Caveatron/caveatron_old_rev-A_version/README.md

# rev-A_version
 Original Caveatron version based on Arduino Due
