Caveatron/caveatron_old_rev-A_version/caveatron-hardware-documentation/README.md

# Documentation for Assembling the Caveatron Hardware
