Caveatron/caveatron_old_rev-A_version/caveatron-hardware-documentation/Electronics/readme.txt

Caveatron Electronics Documentation

Caveatron Base Electronics.pdf - shows approximate layout of electronics modules in main body interior along with pin connection points.

Caveatron Board Connection.pdf - shows details of the module positions and wiring connections of each protoboard used in the main body.

Caveatron Wiring Diagram.pdf - Wiring diagram for the main body enclosure electronics

Caveatron Wiring Diagram Notes.pdf - Additional notes on the electronics

Caveatron 4m LIDAR Wiring Diagram.pdf - Wiring diagram for 4m (XV) LIDAR Module

Caveatron 25m LIDAR Wiring Diagram.pdf - Wiring diagram for 25m (SWEEP) LIDAR Module
