Caveatron/caveatron_old_rev-A_version/caveatron-hardware-documentation/Electronics/Cavatron Base Electronics - Rev A.pdf

## Caveatron Rev A Main Body Base Electronics Illustration

2017-09-23

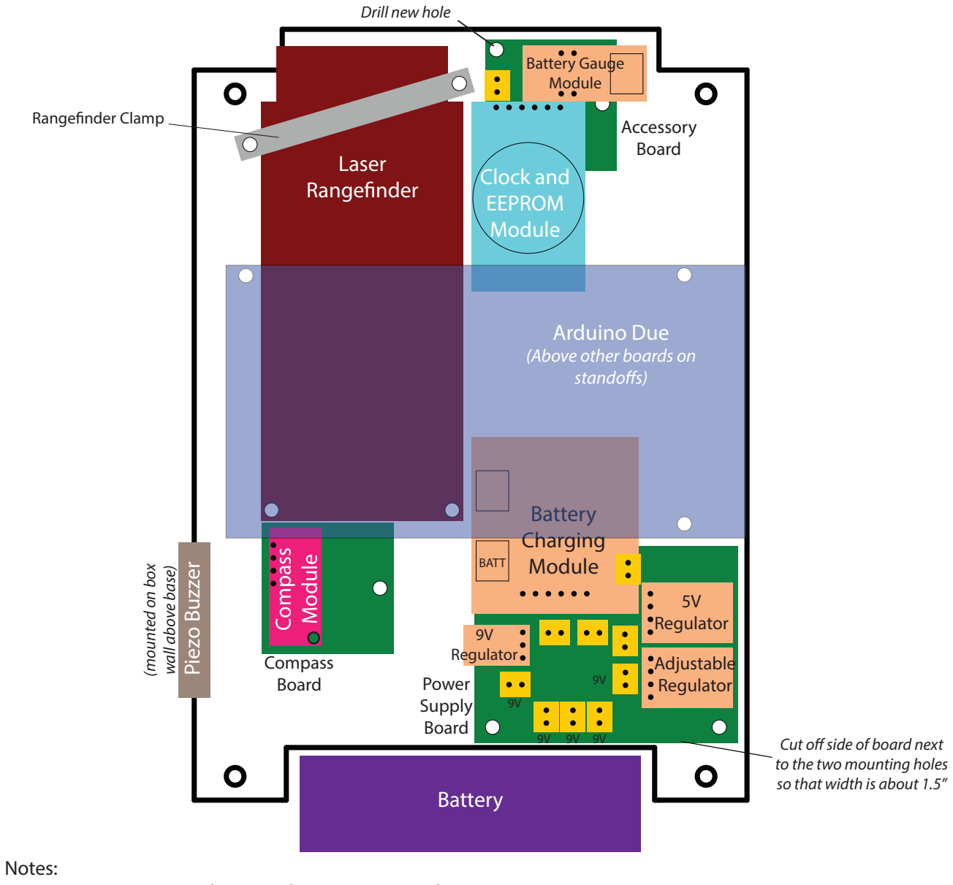
[picture p1: figure]
Battery; Battery Charging Module; Arduino Due (Above other boards on standos); Compass Module; Laser; Rangender; Clock and; EEPROM Module; Battery Gauge Module; 5V Regulator; Adjustable Regulator; 9V Regulator; Accessory Board; Compass; Board; Power; Supply Board; (mounted on box wall above base); Piezo Buzzer; BATT; Drill new hole; Cut o side of board next to the two mounting holes so that width is about 1.5”; Notes:; Rangender Clamp

- Wiring connectors are shown in the seperate Board Connections document.
- Yellow rectangles are JST-PH 2-pin connectors.
- The Rangnder Clamps is a custom cut plastic piece to secure the front of the rangender. A pair of standos screwed down to the base hold it in place.
- It is important to align the edge of the Compass Board with the rear edge of the Laser Rangender so the Compass board cannot rotate and is parallel to it.
- Be sure the battery holder on the Accessory Board and the BATT connector on the Battery Charging Module clear the Arduino Board.

The green boards are protoboards onto which the connectors and modules are soldered with pins. The following protoboards are used:
- Sparkfun PRT-08808 1” Square Protoboard (2x)
- Sparkfun PRT-08811 2” Square Protoboard (1x) These boards are modied as indicated in the drawing.
