Caveatron/caveatron_old_rev-A_version/caveatron-hardware-documentation/Enclosure/Caveatron Main Body Base Plate Hole Pattern.pdf

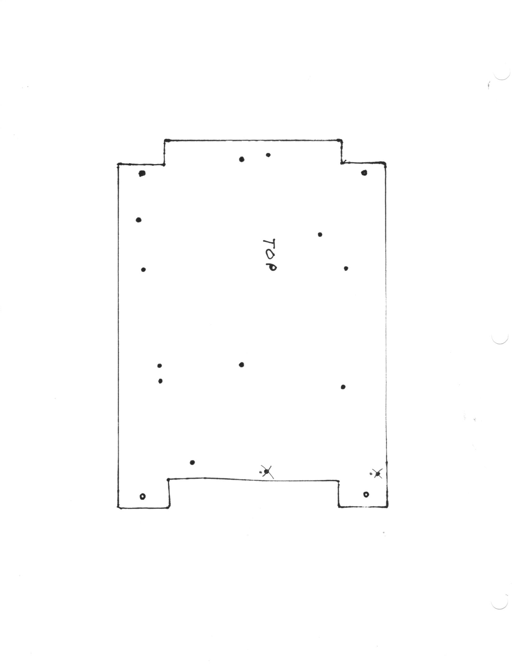
[picture p2: page 1]
