Caveatron/caveatron_old_rev-A_version/caveatron_libraries/SdFat/extras/AnalogBinLoggerExtras/ADC_ENOB.PNG

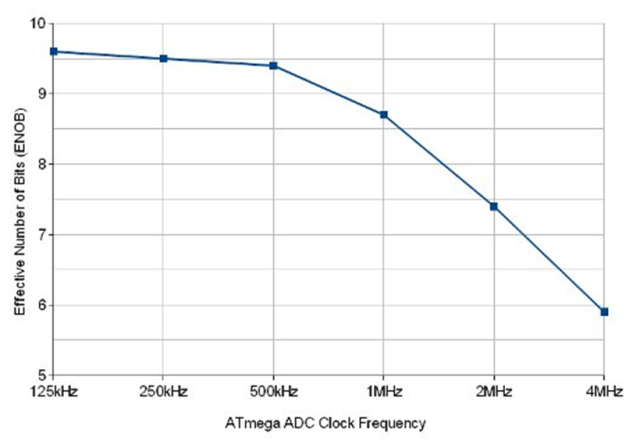
caveatron_libraries/SdFat/extras/AnalogBinLoggerExtras/ADC_ENOB.PNG
