Caveatron/caveatron_old_rev-A_version/caveatron_libraries/SdFat/extras/AnalogBinLoggerExtras/DATA.png

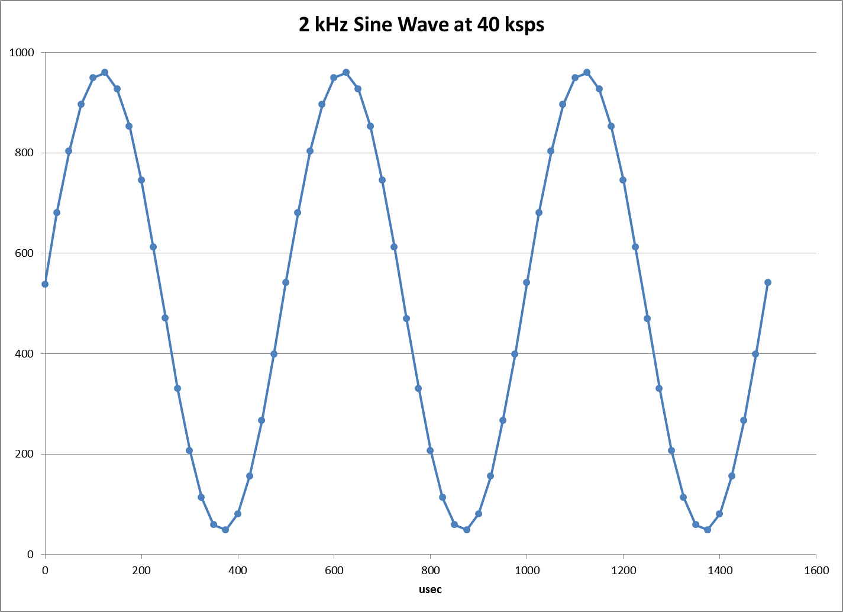
caveatron_libraries/SdFat/extras/AnalogBinLoggerExtras/DATA.png
