Caveatron/caveatron_old_rev-A_version/caveatron_libraries/SdFat/extras/AnalogBinLoggerExtras/FFT.png

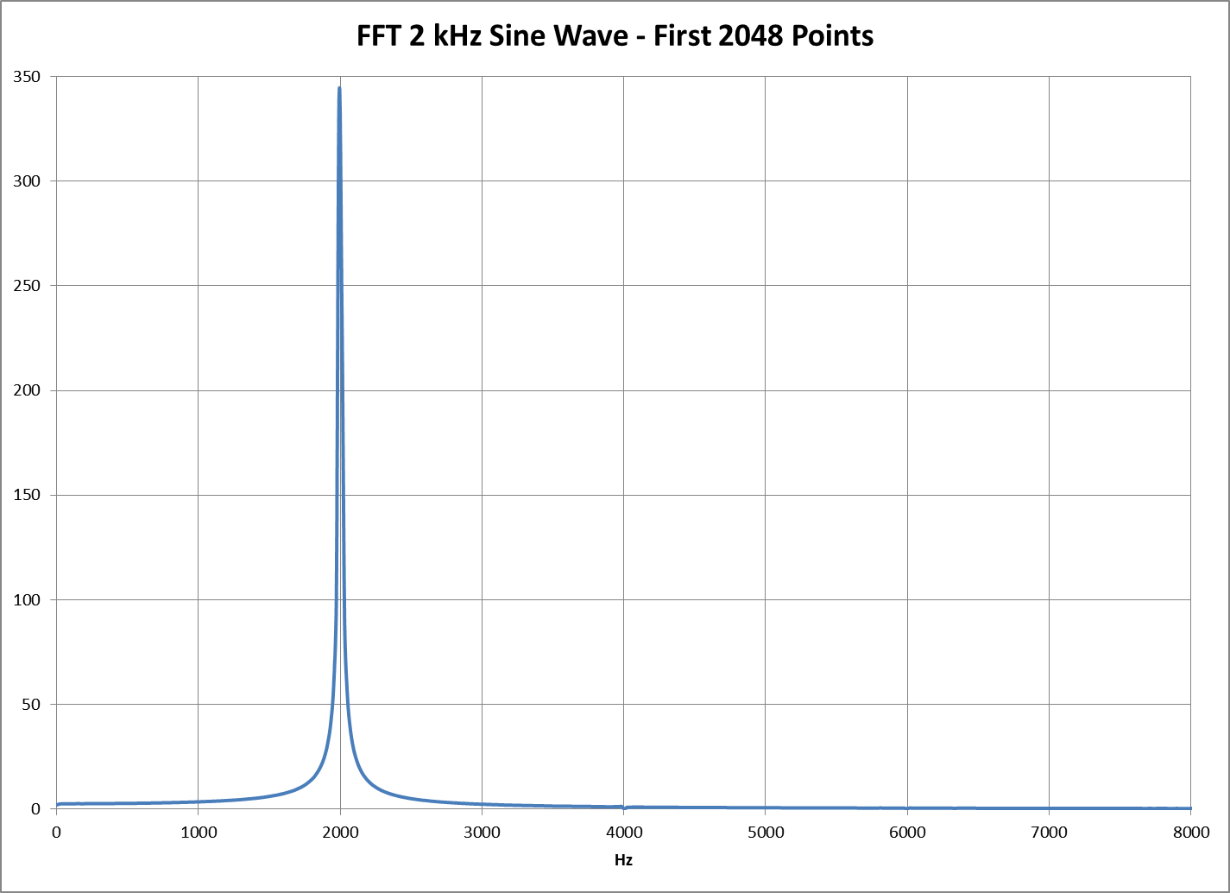
caveatron_libraries/SdFat/extras/AnalogBinLoggerExtras/FFT.png
