Caveatron/caveatron_old_rev-A_version/caveatron_libraries/SdFat/extras/html/_arduino_files_8h__dep__incl.png

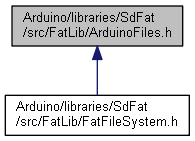
caveatron_libraries/SdFat/extras/html/_arduino_files_8h__dep__incl.png
