Caveatron/caveatron_old_rev-A_version/caveatron_libraries/SdFat/extras/html/_sd_fat_config_8h__incl.png

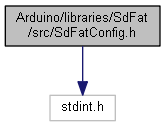
caveatron_libraries/SdFat/extras/html/_sd_fat_config_8h__incl.png
