Caveatron/caveatron_old_rev-A_version/caveatron_libraries/SdFat/extras/html/class_arduino_in_stream__coll__graph.png

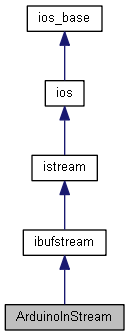
caveatron_libraries/SdFat/extras/html/class_arduino_in_stream__coll__graph.png
