Caveatron/caveatron_old_rev-A_version/caveatron_libraries/SdFat/extras/html/class_sd_fat__coll__graph.png

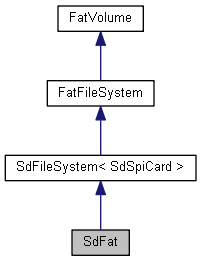
caveatron_libraries/SdFat/extras/html/class_sd_fat__coll__graph.png
