Caveatron/caveatron_old_rev-A_version/caveatron_libraries/SdFat/extras/html/class_sd_fat_e_x__coll__graph.png

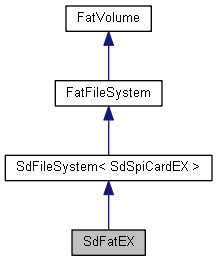
caveatron_libraries/SdFat/extras/html/class_sd_fat_e_x__coll__graph.png
