Caveatron/caveatron_old_rev-A_version/caveatron_libraries/SdFat/extras/html/classfstream__coll__graph.png

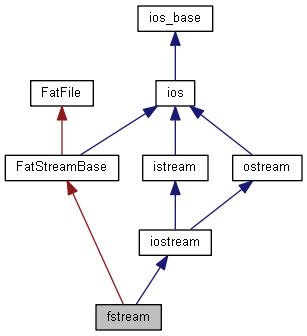
caveatron_libraries/SdFat/extras/html/classfstream__coll__graph.png
