Caveatron/caveatron_old_rev-A_version/caveatron_libraries/SdFat/extras/html/classistream__inherit__graph.png

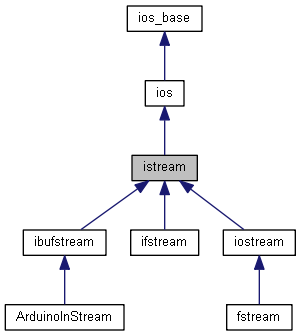
caveatron_libraries/SdFat/extras/html/classistream__inherit__graph.png
