Caveatron/caveatron_old_rev-A_version/caveatron_libraries/SdFat/extras/html/dir_7e472674a7b7d2590a789f197241f95f_dep.png

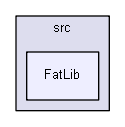
caveatron_libraries/SdFat/extras/html/dir_7e472674a7b7d2590a789f197241f95f_dep.png
