Caveatron/caveatron_old_rev-A_version/caveatron_libraries/SdFat/extras/html/dir_481cc946b8a81b8d9363a4aad6201160_dep.png

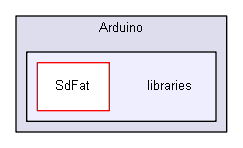
caveatron_libraries/SdFat/extras/html/dir_481cc946b8a81b8d9363a4aad6201160_dep.png
