Caveatron/caveatron_old_rev-A_version/caveatron_libraries/SdFat/extras/html/dir_1281b15c327061056ab3b326e90c50cf_dep.png

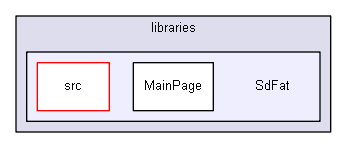
caveatron_libraries/SdFat/extras/html/dir_1281b15c327061056ab3b326e90c50cf_dep.png
