Caveatron/caveatron_old_rev-A_version/caveatron_libraries/SdFat/extras/html/dir_c18d6c86f7b0afecac5c3a8a9885031e_dep.png

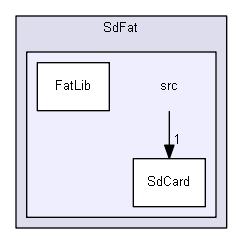
caveatron_libraries/SdFat/extras/html/dir_c18d6c86f7b0afecac5c3a8a9885031e_dep.png
