Caveatron/caveatron_old_rev-A_version/caveatron_libraries/SdFat/extras/html/fstream_8h__incl.png

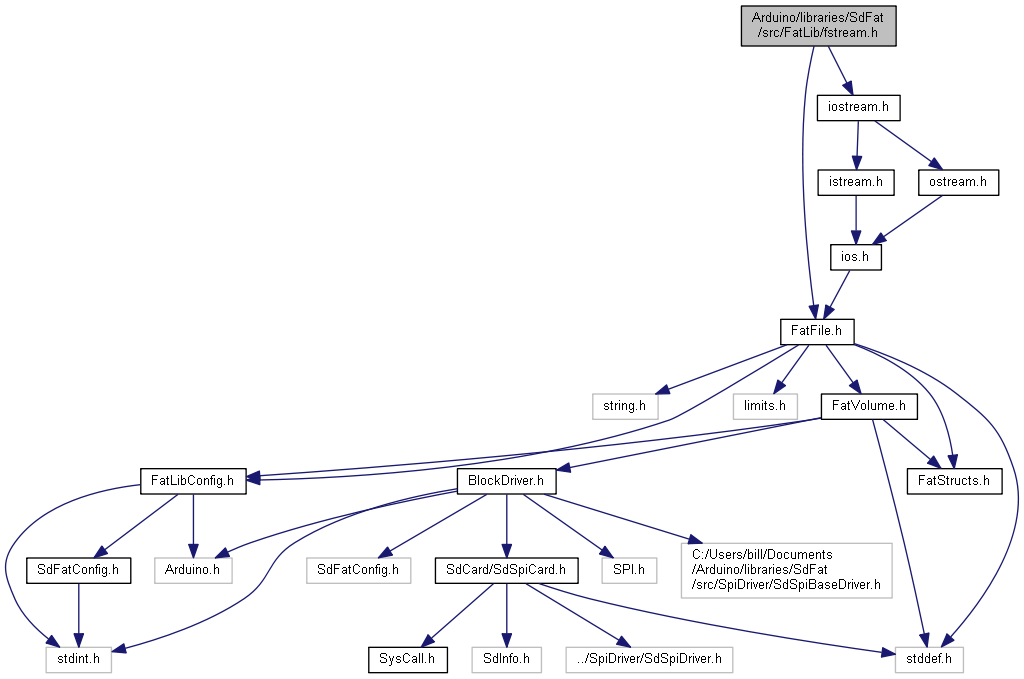
caveatron_libraries/SdFat/extras/html/fstream_8h__incl.png
