Caveatron/caveatron_old_rev-A_version/caveatron_libraries/SdFat/extras/html/graph_legend.png

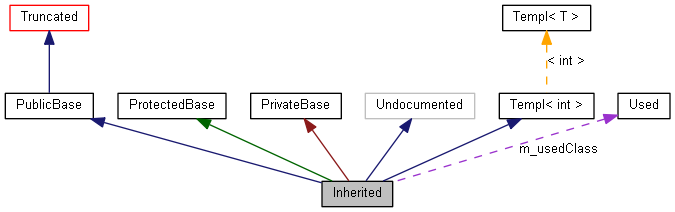
caveatron_libraries/SdFat/extras/html/graph_legend.png
