Caveatron/caveatron_old_rev-A_version/caveatron_libraries/SdFat/extras/html/inherit_graph_10.png

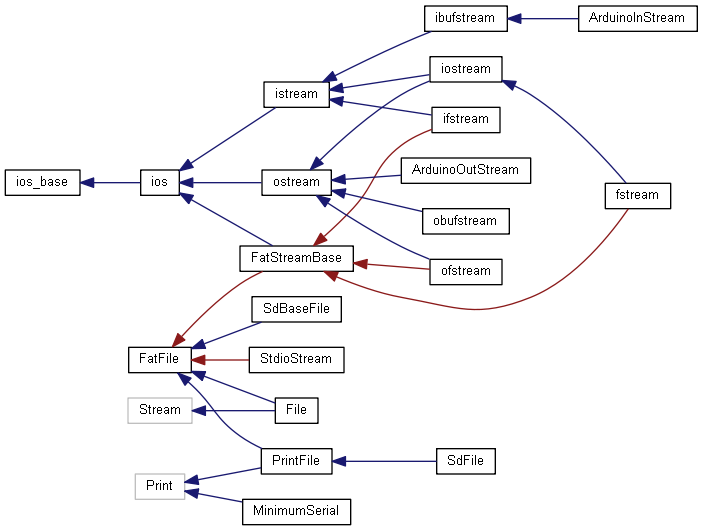
caveatron_libraries/SdFat/extras/html/inherit_graph_10.png
