Caveatron/caveatron_old_rev-A_version/caveatron_libraries/SdFat/extras/html/istream_8h__incl.png

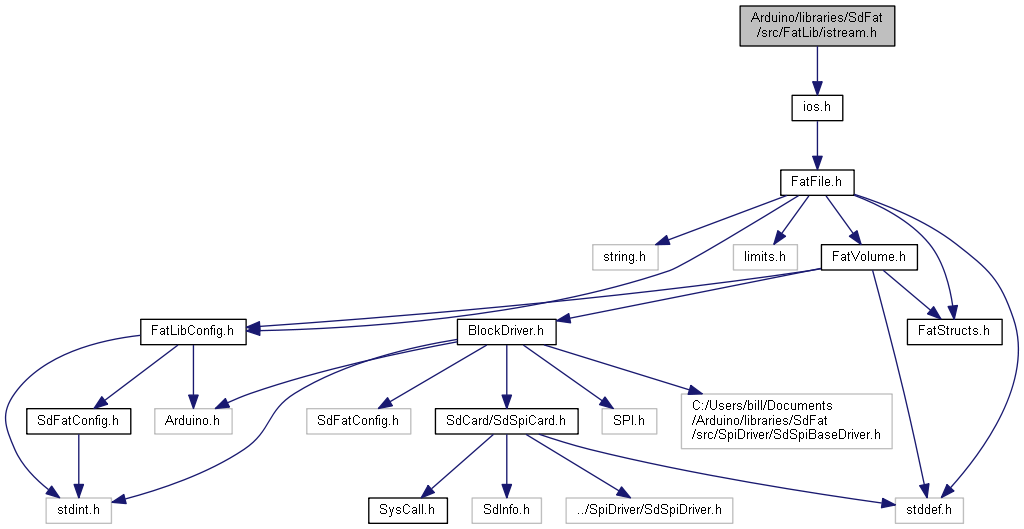
caveatron_libraries/SdFat/extras/html/istream_8h__incl.png
