Caveatron/caveatron_old_rev-A_version/caveatron_libraries/SdFat/extras/html/structmaster_boot_record__coll__graph.png

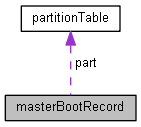
caveatron_libraries/SdFat/extras/html/structmaster_boot_record__coll__graph.png
