Caveatron/caveatron_old_rev-A_version/caveatron_libraries/SdFat/extras/html/unioncache__t__coll__graph.png

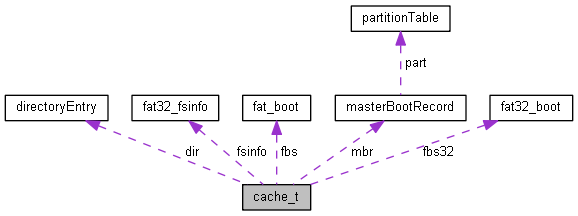
caveatron_libraries/SdFat/extras/html/unioncache__t__coll__graph.png
