Caveatron/caveatron_old_rev-A_version/caveatron-hardware-documentation/Caveatron Bill of Materials - LIDAR 12m version - 2019-11-05.pdf

## Caveatron Bill of Materials – 12m RP LIDAR Module

### Date: 2019-11-05

The LIDAR module mounts onto the top front of the main enclosure and is easily detachable. The module is designed to use a custom 3D printed enclosure consisting of a base part, a lid bottom part, and lid top part. An STL file of these parts is provided. PETG is the recommended printing material.

Item | Qty | Manufacturer | Mfr. P/N | Description | Suggested Vendor Link | Photo
LIDAR | 1 | Slamtec | RPLIDAR A1M8 | LIDAR 360 Degree Laser Range Scanner | RobotShop (https://www.robotshop.com/en/rplidar-a1m8-360-degree-laser-scanner-development-kit.html)

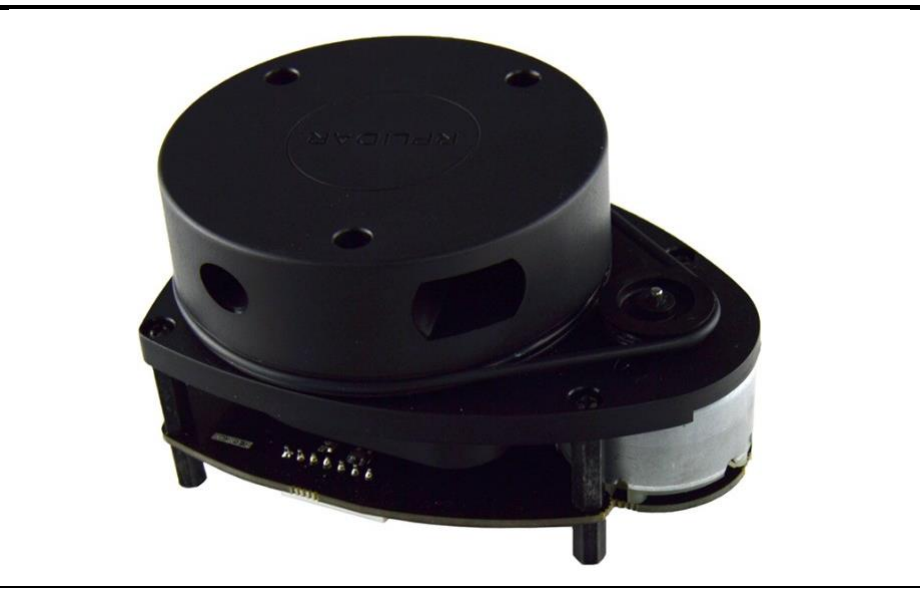
[picture p89: figure]

Notes: Scanning LIDAR sensor. Other models that may also work but have not been tested include RPLIDAR A2M6, A2M8, and A3M1.

Voltage
Regulator –
Adjustable
(OPTIONAL)
1 | Pololu | 2118 | Pololu Adjustable Step- Up/Step-Down Voltage Regulator S7V8A

Pololu (https://www.pololu.com/product/2118)

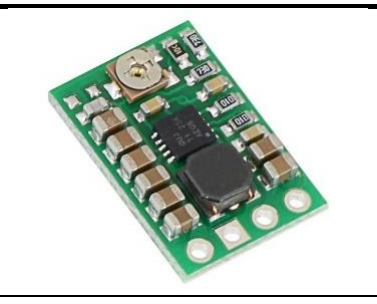
[picture p90: figure]

Notes: Power supply for Laser Rangefinder. Output is set so that the LIDAR is rotating at about 5 Hz (300 RPM). The voltage is typically set to about 3.68 V. It is not necessary to use this component since the LIDAR motor can be directly operated off of 5V, which gives a rotation speed of 7.5 Hz (450 RPM) but reduces the number of points per rotation from 400 to 267.

Item | Qty | Manufacture r | Mfr. P/N | Description | Suggested Vendor Link | Photo
LIDAR Rail Mounts | 1 | Weaver | 49819 | 0.22 Caliber 1-inch Tip-Off Rings | Amazon (https://www.amazon.com/49819-Weaver-Pro-View-Rings-1/dp/B0002IOGF0/)

Notes: Parts for making the rail mounts. The top ring portion is cut off making a flat top and two threaded holes are machined into each ring base for attachment to bottom of LIDAR module enclosure.

LIDAR
Interface Plug

1 Conxall/ Switchcraft

16982-
6PG-522

Micro-Con-X 6 Position
Circular Connector Plug,
Male Pins Solder Cup Gold

Digikey (https://www.digikey.com/products/en?keywords=16982-6PG-522)

Notes: Jack for LIDAR interface cable. Available from multiple vendors.

Cable Gland | 1 | Many sources
PG7 | Waterproof Cable Gland
Wire Feedthrough

Amazon (https://www.amazon.com/Lokman-Plastic-Waterproof-Adjustable-Connectors/dp/B06Y5HGYK2/) or
many other
sources

Notes: Feeds LIDAR interface cable out of LIDAR enclosure. Numerous small variations of style and color are available, so long as it is PG7 size.

Item | Qty | Manufacturer | Mfr. P/N | Description | Suggested Vendor Link | Photo
Window Material | 1 | Small Parts | 5302441212 | Acrylic Sheet, Transparent Clear, Standard Tolerance, ASTM D788, 0.118" Thickness | Amazon (https://www.amazon.com/Acrylic-Transparent-Standard-Tolerance-Thickness/dp/B00CPRAYWK/)

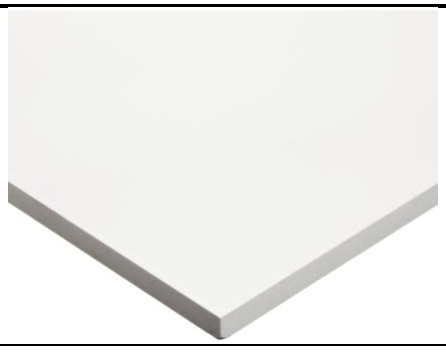
[picture p91: figure]

Notes: Transparent acrylic sheet for LIDAR windows on 3D Printed LIDAR Module. Requires cutting to size. Acrylic seems to be the most transparent with the least distortion and defects of the various clear plastics tested, which is important for not interfering with the LIDAR and rangefinder readings. This is a thicker window than is used on the Main body since it is used in the 3D printed enclosure as a structural piece as well. If a different enclosure design is used, the thinner material could be used instead.

Threaded
Inserts for
LIDAR
Standoffs
1 | Initeq | INM2504 | M2.5-0.4 M2.5 Threaded Heat Set Inserts for 3D Printing (Long)

Amazon (https://www.amazon.com/gp/product/B077CH3GCM/)

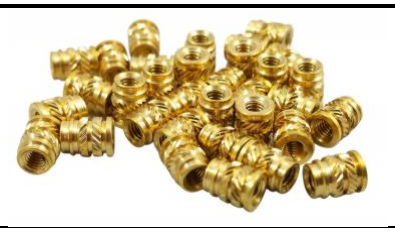
[picture p92: figure]

Notes: Heat set threaded inserts used in 3D printed LIDAR enclosure for LIDAR standoffs. The standoffs that screw into these are included with the RPLIDAR.

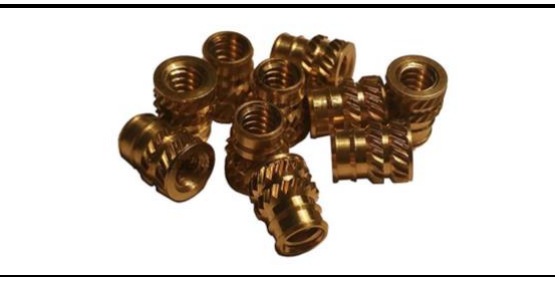
[picture p93: figure]

Threaded
Inserts for
Enclosure Lid
1 | Small Parts | STPVC-0093-F | Qty 20 M4-0.7 Threaded Heat Set Inserts for 3D Printing (Long)

Amazon (https://www.amazon.com/gp/product/B07477XRN4/)

Notes: Heat set threaded inserts used in 3D printed LIDAR enclosure for lid screws.

Item | Qty | Manufacturer | Mfr. P/N | Description | Suggested | Photo

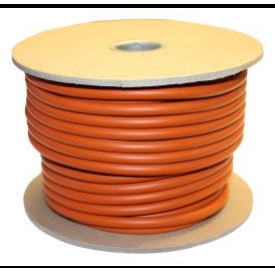
[picture p94: figure]

| | | | | Vendor Link
O-Ring Gasket Material | 1 | Small Parts | S70.093 | .093'' (3/32" Actual) Silicone O-Ring Cord Stock, 70A Durometer, 0.093" Thickness | Amazon (https://www.amazon.com/gp/product/B00QVB0TW6)

Notes: Seal gasket for LIDAR lid.

JST Connector
for LIDAR
Motor
1 | Various | N/A | JST 1.25mm pitch, 3 pin, male connector

Amazon (https://www.amazon.com/gp/product/B073WPQLVX/)

Notes: Connector for LIDAR Motor.

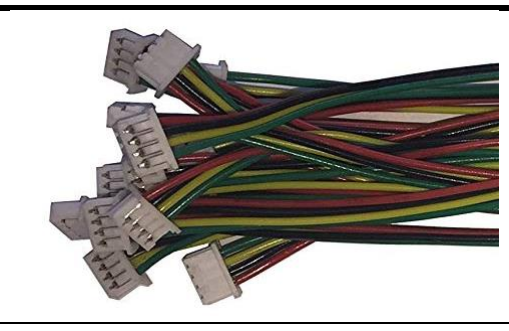
[picture p95: figure]

JST Connector
for LIDAR
Sensor
1 | Various | INM2504 | JST 1.25mm pitch, 4 pin, male connector

Amazon (https://www.amazon.com/1-25MM-Female-Single-Connector-Wires/dp/B07HLF2MFJ/)

Notes: Connector for LIDAR Sensor

Other Required Items:
M4 x 12 Screws for Lid
4 conductor cable to connect LIDAR module to main enclosure through Cable Gland to LIDAR Interface Plug
Slightly flexible sealing epoxy to attach LIDAR windows (marine grade epoxy, silicone epoxy or similar). Rigid epoxies may warp the windows. Tape and/or cable ties to manage wiring and voltage regulator.
Notes: For assembly and electrical interconnections
