Caveatron/caveatron_old_rev-A_version/caveatron-hardware-documentation/Caveatron Bill of Materials - LIDAR 25m version - 2019-02-12.pdf

## Caveatron Bill of Materials – 25m LIDAR Unit

### Date: 2019-02-12

Item | Qty | Manufacturer | Mfr. P/N | Description | Suggested Vendor Link

Photo

LIDAR | 1 | Scanse | N/A | Sweep | N/A No longer manufactured but units can still be found on Ebay from time to time.

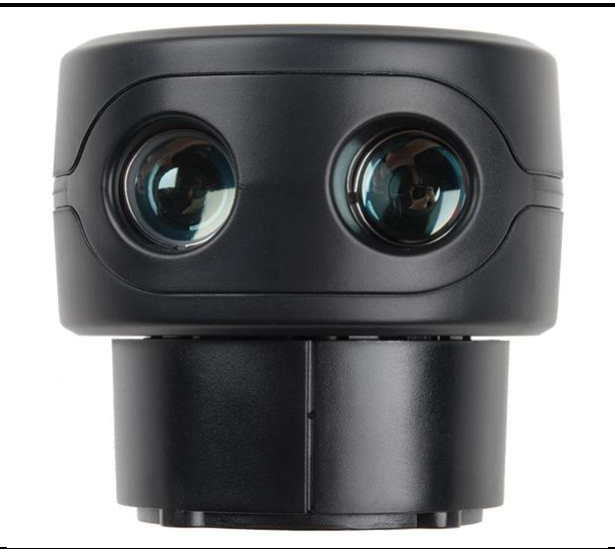
[picture p96: figure]

Notes: Scanning LIDAR sensor. Operates on 5V so separate voltage regulator not required. No longer available.

Item | Qty | Manufacturer | Mfr. P/N | Description | Suggested Vendor Link

Photo

LIDAR Module Enclosure | 1 | Bud Industries | PN-1323- DG | ABS NEMA 4x Enclosure, Dark Gray | Amazon (https://www.amazon.com/BUD-Industries-PN-1323-DG-High-Impact-Indoor/dp/B005T7B0X0/)

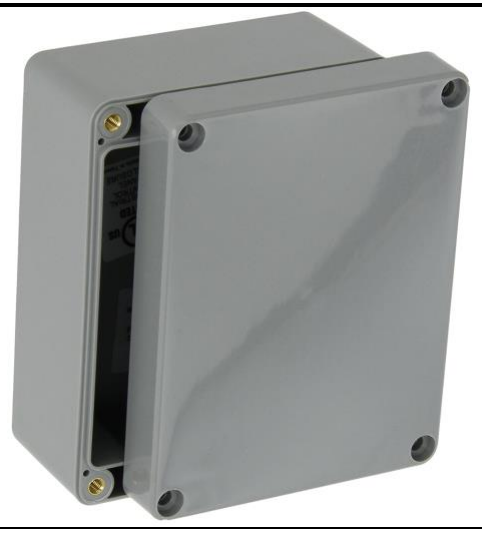
[picture p97: figure]

Notes: Enclosure box for LIDAR module. Requires machining of base to add holes for cable gland and rail mounts. Lid is replaced with a custom 3D printed lid, reusing the gasket from this lid. Available from many vendors. A custom 3D printed baseplate has also been designed to mount the Sweep inside this enclosure.

Cable Gland | 1 | Many sources | PG7 | Waterproof Cable Gland Wire Feedthrough

Amazon or
many other
sources

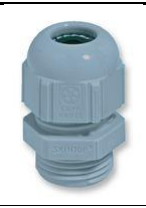
[picture p98: figure]

Notes: Feeds LIDAR interface cable out of LIDAR enclosure. Numerous small variations of style and color are available, so long as it is PG7 size.

Item | Qty | Manufacturer | Mfr. P/N | Description | Suggested Vendor Link | Photo
LIDAR Rail Mounts | 1 | Weaver | 49819 | 0.22 Caliber 1-inch Tip-Off Rings | Amazon (https://www.amazon.com/49819-Weaver-Pro-View-Rings-1/dp/B0002IOGF0/)

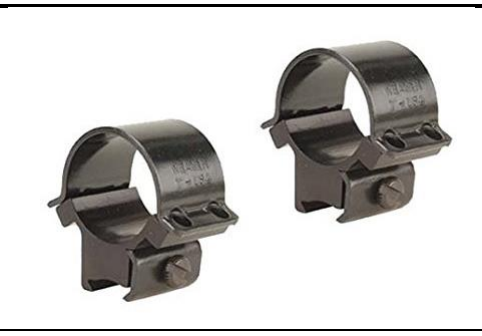
[picture p99: figure]

Notes: Parts for making the rail mounts. The top ring portion is cut off making a flat top and two threaded holes are machined into each ring base for attachment to bottom of LIDAR module enclosure.

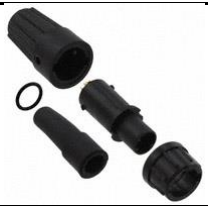
[picture p100: figure]

LIDAR
Interface
Jack

1 Conxall/ Switchcraft

16982-
6PG-522

Micro-Con-X 6 Position
Circular Connector Plug,
Male Pins Solder Cup Gold

Digikey (https://www.digikey.com/products/en?keywords=16982-6PG-522)

Notes: Jack for LIDAR interface cable. Available from multiple vendors.

Item | Qty | Manufacturer | Mfr. P/N | Description | Suggested Vendor Link | Photo

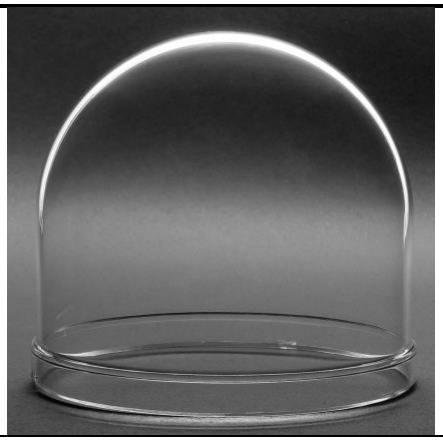
[picture p101: figure]

Window Dome | 1 | JMX | JMX-033 | 3.3 inch Acrylic Clear Camera Dome Cover | Ebay (https://www.ebay.com/itm/3-3-Inch-WEBCAM-Acrylic-PC-Replacement-Clear-Camera-Dome-Cover-/301720384656)

Notes: Transparent acrylic window for LIDAR Module. Glues onto custom 3D printed enclosure lid.

Assorted Fastener Hardware: Screws, Washers, and Nuts
Notes: For assembly. Several sizes of standard hardware required. To be detailed in assembly instructions.

Assorted Electrical Hardware: Wire and JST Connectors.

Notes: For electrical interconnections between boards. To be detailed in assembly instructions.
