Caveatron/caveatron_old_rev-A_version/caveatron-hardware-documentation/Caveatron Bill of Materials - LIDAR 4m version - 2018-03-06.pdf

## Caveatron Bill of Materials – 4m LIDAR Unit

### Date: 2018-03-06

Item | Qty | Manufacturer | Mfr. P/N | Description | Suggested Vendor Link | Photo
LIDAR | 1 | Neato | from XV-11 Vacuum model | LIDAR Laser Distance Sensor | Ebay. - seller availability changes frequently. Occasionally on Amazon

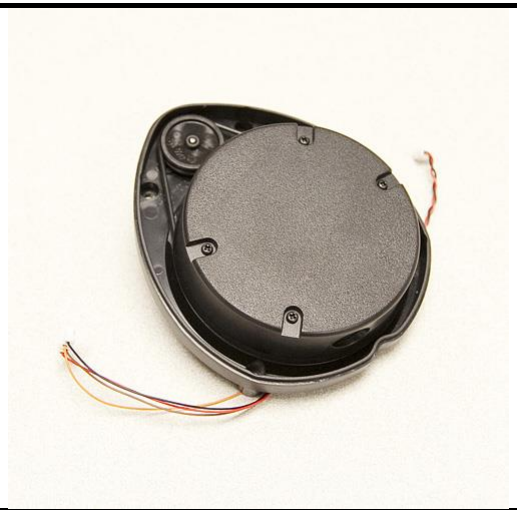
[picture p102: figure]

Notes: Scanning LIDAR sensor. Models listed as XV-11, XV-12, XV-14, XV-15, or XV-21 are all identical and will work the same.

Voltage
Regulator –
Adjustable
1 | Pololu | 2118 | Pololu Adjustable Step- Up/Step-Down Voltage Regulator S7V8A

Pololu (https://www.pololu.com/product/2118)

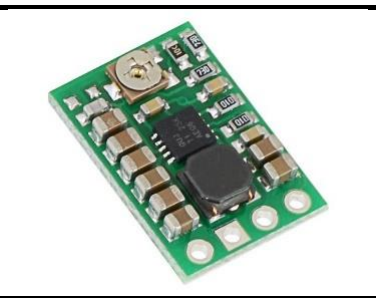
[picture p103: figure]

Notes: Power supply for Laser Rangefinder. Output is set so that the LIDAR is rotating at about 285 RPM (must be between 250 and 300 RPM). The voltage needed varies from LIDAR unit to LIDAR unit though is typically about 2.8 - 3.0 V.

Item | Qty | Manufacturer | Mfr. P/N | Description | Suggested Vendor Link

Photo

LIDAR Module Enclosure | 1 | Bud Industries | PN-1336- DG | ABS NEMA 4x Enclosure, Dark Gray | Amazon (https://www.amazon.com/BUD-Industries-PN-1336-DG-High-Impact-Indoor/dp/B005T7AND8)

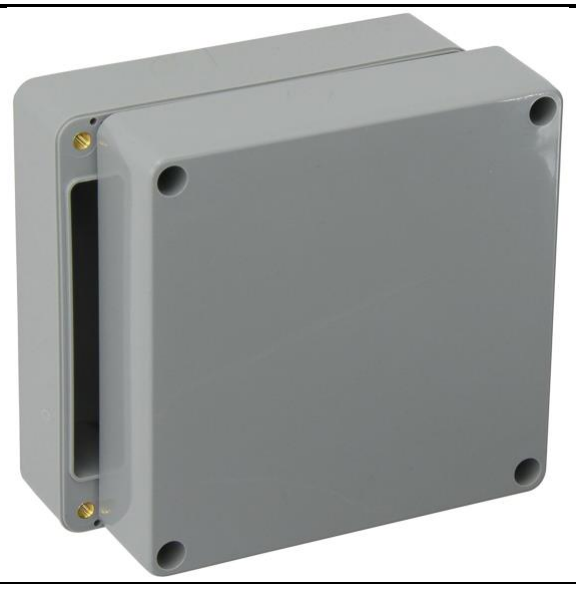
[picture p104: figure]

Notes: Enclosure box for LIDAR module. Requires machining of base to add holes for cable gland and rail mounts. Lid is replaced with a custom 3D printed lid, reusing the gasket from this lid. If no 3D printer available, lid can be used as cover with ½” wide slits cut along the length of all 4 sides, though this obstructs more of the LIDAR field of view in the corners than the custom lid. Available from many vendors.

Cable Gland | 1 | Many sources | PG7 | Waterproof Cable Gland Wire Feedthrough

Amazon or
many other
sources

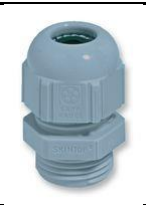
[picture p105: figure]

Notes: Feeds LIDAR interface cable out of LIDAR enclosure. Numerous small variations of style and color are available, so long as it is PG7 size.

Item | Qty | Manufacturer | Mfr. P/N | Description | Suggested Vendor Link | Photo
LIDAR Rail Mounts | 1 | Weaver | 49819 | 0.22 Caliber 1-inch Tip-Off Rings | Amazon (https://www.amazon.com/49819-Weaver-Pro-View-Rings-1/dp/B0002IOGF0)

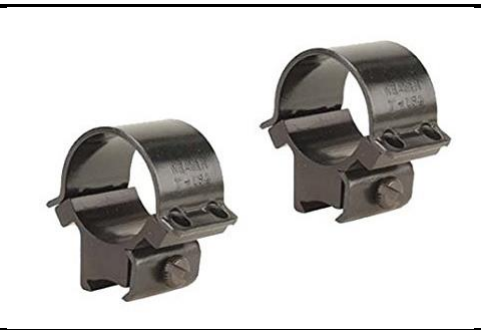
[picture p106: figure]

Notes: Parts for making the rail mounts. The top ring portion is cut off making a flat top and two threaded holes are machined into each ring base for attachment to bottom of LIDAR module enclosure.

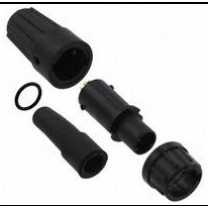
[picture p107: figure]

LIDAR
Interface
Jack
1 | Conxall/ Switchcraft

16982-
6PG-522

Micro-Con-X 6 Position
Circular Connector Plug,
Male Pins Solder Cup Gold

Digikey (https://www.digikey.com/products/en?keywords=16982-6PG-522)

Notes: Jack for LIDAR interface cable. Available from multiple vendors.

Item | Qty | Manufacturer | Mfr. P/N | Description | Suggested Vendor Link | Photo
Window Material | 1 | Small Parts | 50649812 12 | Acrylic Sheet, Transparent Clear, 0.06" Thickness, 12" Width, 12" Length | Amazon (https://www.amazon.com/Acrylic-Transparent-Standard-Tolerance-Thickness/dp/B00CPRAYWK)

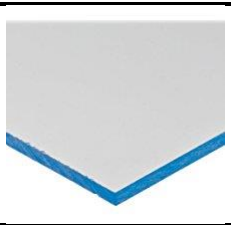
[picture p108: figure]

Notes: Transparent acrylic sheet for Rangefinder window on Main Body and LIDAR windows on LIDAR Module. Requires cutting to size. Acrylic seems to be the most transparent with the least distortion and defects of the various clear plastics tested ,which is important for not interfering with the LIDAR and rangefinder readings.

Plastic Base
Material
1 | Small Parts | STPVC- 0093-F

PVC Sheet, Opaque Gray,
0.093" Thickness, 12"
Width, 24" Length

Amazon (https://www.amazon.com/Polyvinyl-Chloride-Standard-Tolerance-Thickness/dp/B00CPRFA6K)

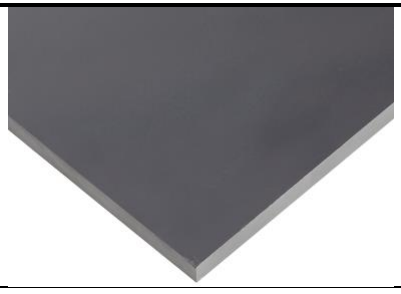
[picture p109: figure]

Notes: Plastic sheet for mounting internal components in Main Body Enclosure and LIDAR Enclosure. Requires cutting to size and drilling mounting holes.

Assorted Fastener Hardware: Screws, Washers, and Nuts
Notes: For assembly. Several sizes of standard hardware required. To be detailed in assembly instructions.

Assorted Electrical Hardware: Wire and JST Connectors.

Notes: For electrical interconnections between boards. To be detailed in assembly instructions.
