Caveatron/caveatron_old_rev-A_version/caveatron-hardware-documentation/Enclosure/Caveatron 12m LIDAR Enclosure Lid (Bottom).stl

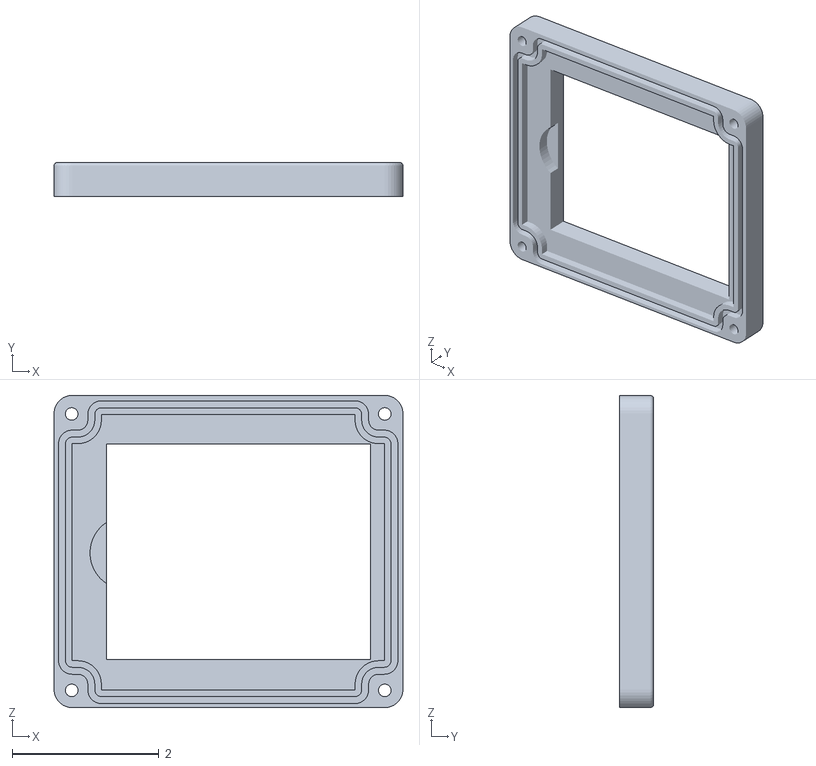
[picture p110: CAD file, 2020-01-26]
caveatron-hardware-documentation/Enclosure/Caveatron 12m LIDAR Enclosure Lid (Bottom).stl
4.76 x 0.47 x 4.26
