Caveatron/caveatron_old_rev-A_version/caveatron-hardware-documentation/Enclosure/Caveatron 25m LIDAR base - Rev A.stl

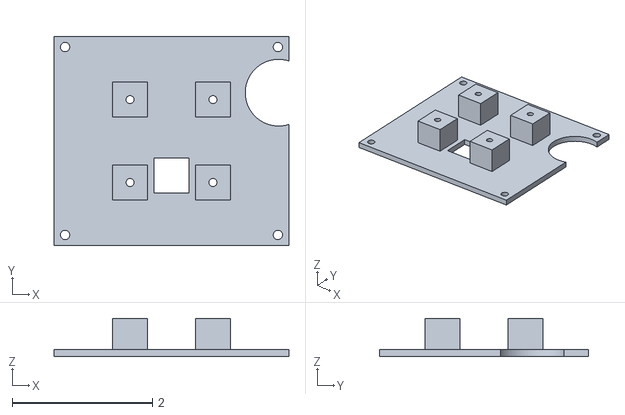
[picture p111: CAD file, 2020-01-26]
caveatron-hardware-documentation/Enclosure/Caveatron 25m LIDAR base - Rev A.stl
3.35 x 2.98 x 0.546
