Caveatron/caveatron_old_rev-A_version/caveatron-hardware-documentation/Enclosure/Caveatron 12m LIDAR Enclosure Lid (Top).stl

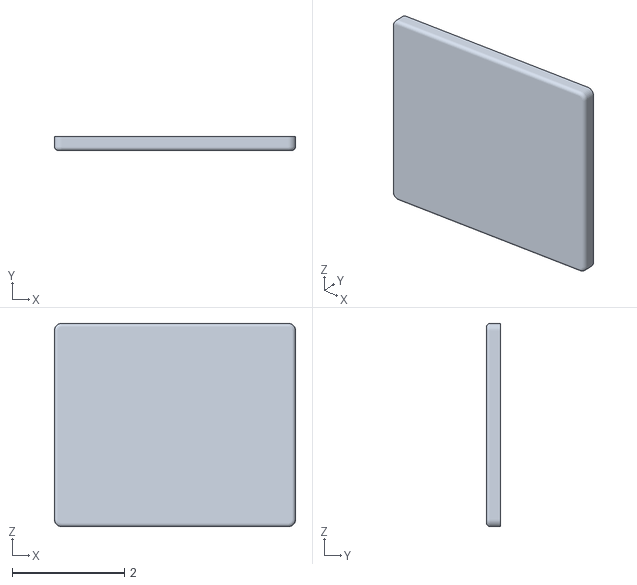
[picture p112: CAD file, 2020-01-26]
caveatron-hardware-documentation/Enclosure/Caveatron 12m LIDAR Enclosure Lid (Top).stl
4.28 x 0.25 x 3.62
