Caveatron/caveatron_old_rev-A_version/caveatron-hardware-documentation/Enclosure/Caveatron 12m LIDAR Enclosure Base.stl

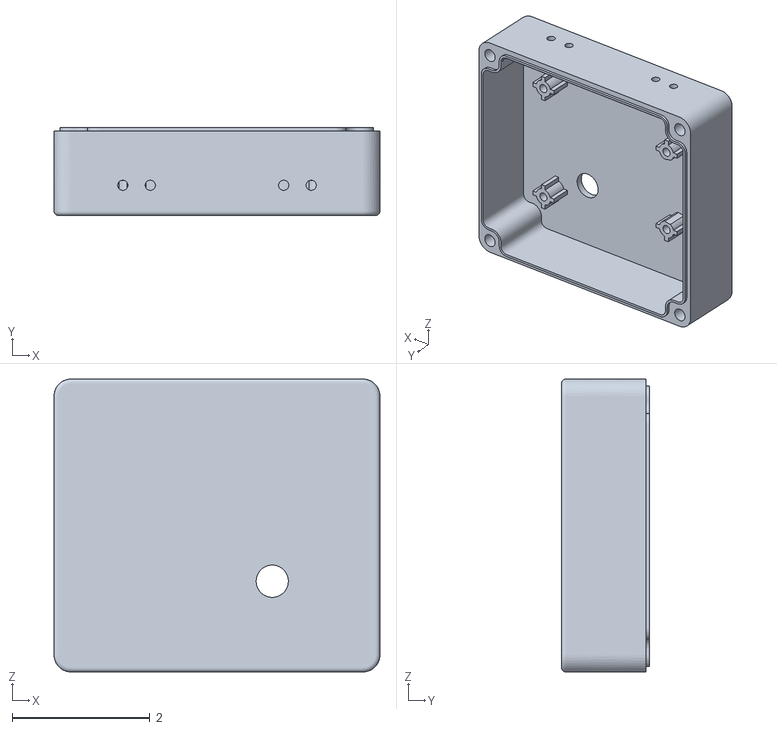
[picture p113: CAD file, 2020-01-26]
caveatron-hardware-documentation/Enclosure/Caveatron 12m LIDAR Enclosure Base.stl
4.74 x 1.28 x 4.26
