Caveatron/caveatron_old_rev-A_version/caveatron-hardware-documentation/Enclosure/Caveatron 4m LIDAR Enclosure Lid - Rev A.STL

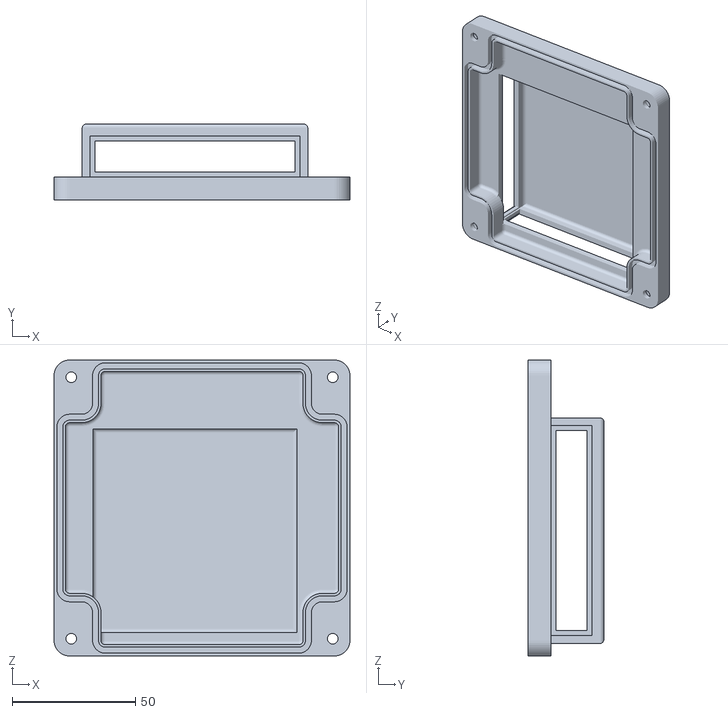
[picture p114: CAD file, 2020-01-26]
caveatron-hardware-documentation/Enclosure/Caveatron 4m LIDAR Enclosure Lid - Rev A.STL
120.0 x 30.7 x 120.0
