Caveatron/caveatron_old_rev-A_version/caveatron-hardware-documentation/Enclosure/Caveatron 25m LIDAR Module Lid - Rev A.stl

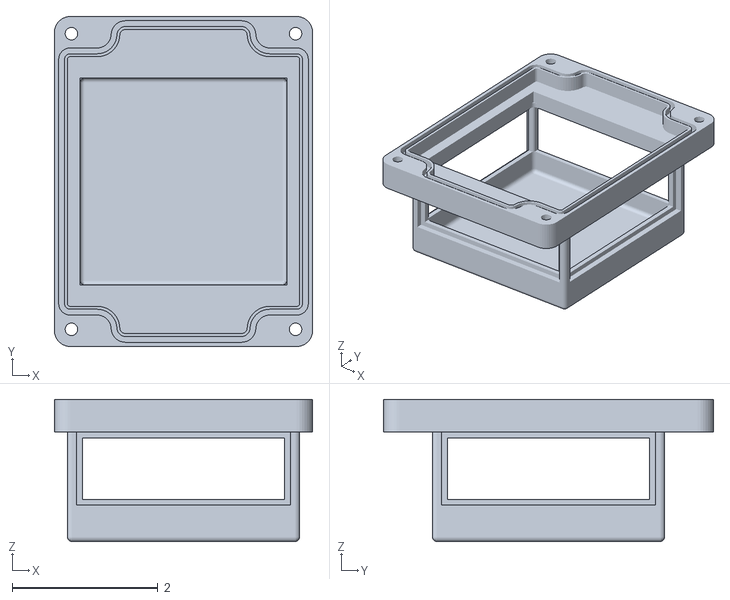
[picture p115: CAD file, 2020-01-26]
caveatron-hardware-documentation/Enclosure/Caveatron 25m LIDAR Module Lid - Rev A.stl
3.54 x 4.53 x 1.95
