Caveatron/caveatron_old_rev-A_version/caveatron-hardware-documentation/Electronics/Caveatron 12m LIDAR Wiring Diagram - Rev A.pdf

# Caveatron Wiring Diagram 12m LIDAR Module (RP) - Rev. A

v. 2019-02-12

*NOTES

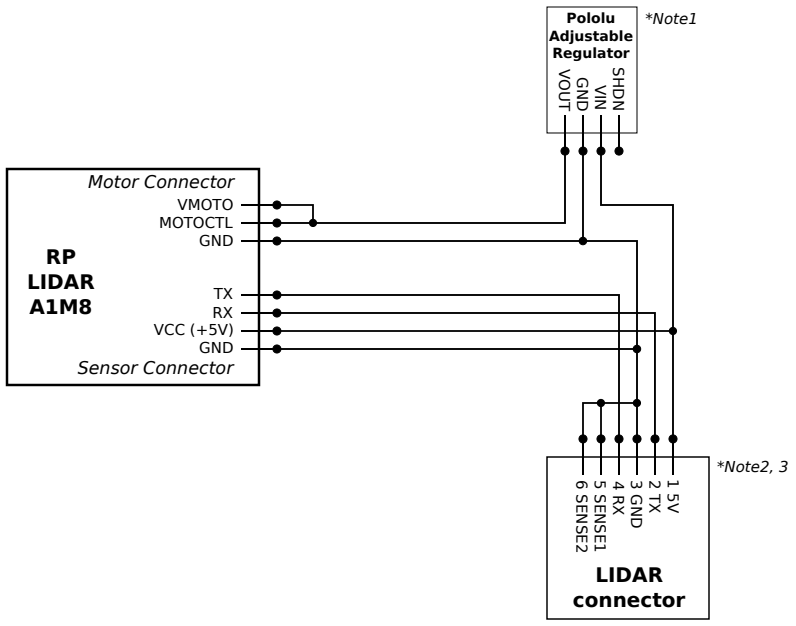
[picture p116: figure]
6 SENSE2; 5 SENSE1; 3 GND; LIDAR; connector¹ ⁵V; Pololu Adjustable Regulator VOUT GND VIN SHDN; *Note1; MOTOCTL GND; VCC (+5V); GND; RP LIDAR A1M8; Motor Connector; Sensor Connector; *Note2, 3; VMOTO

1. Output voltage of regulator sets LIDAR rotation speed. For approximately 5 Hz rotation speed, the set voltage is 3.68V.
2. Numbers designate pin numbers on connector.
3. RX and TX as shown at the LIDAR connector are from the perspective of the Arduino Due board.
