Caveatron/caveatron_old_rev-A_version/caveatron-hardware-documentation/Electronics/Caveatron 25m LIDAR Wiring Diagram - Rev A.pdf

# Caveatron Wiring Diagram 25m LIDAR Module (SWEEP) - Rev. A

v. 2017-01-19

# *NOTES

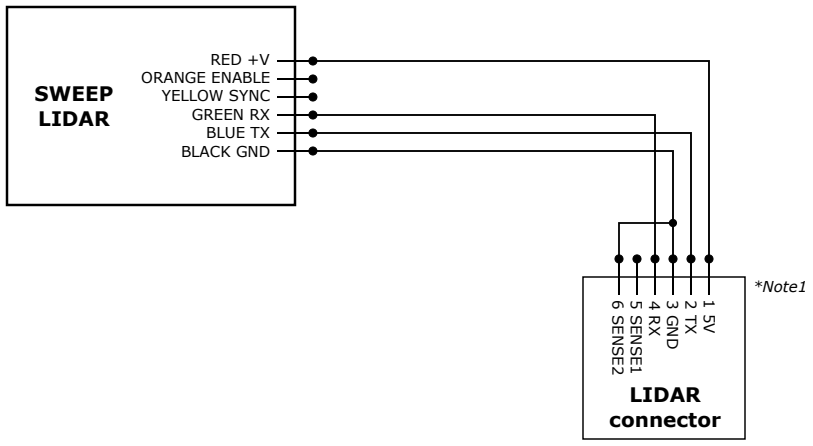
[picture p117: figure]
6 SENSE2; 5 SENSE1; 3 GND 2 TX; LIDAR; connector¹ ⁵V; RED +V; BLUE TX; YELLOW SYNC GREEN RX; ORANGE ENABLE; BLACK GND; SWEEP LIDAR; *Note1

1. Numbers designate pin numbers on connector.
