Caveatron/caveatron_old_rev-A_version/caveatron-hardware-documentation/Electronics/Caveatron 4m LIDAR Wiring Diagram - Rev A.pdf

# Caveatron Wiring Diagram 4m LIDAR Module - Rev. A

v. 2017-11-07

*NOTES

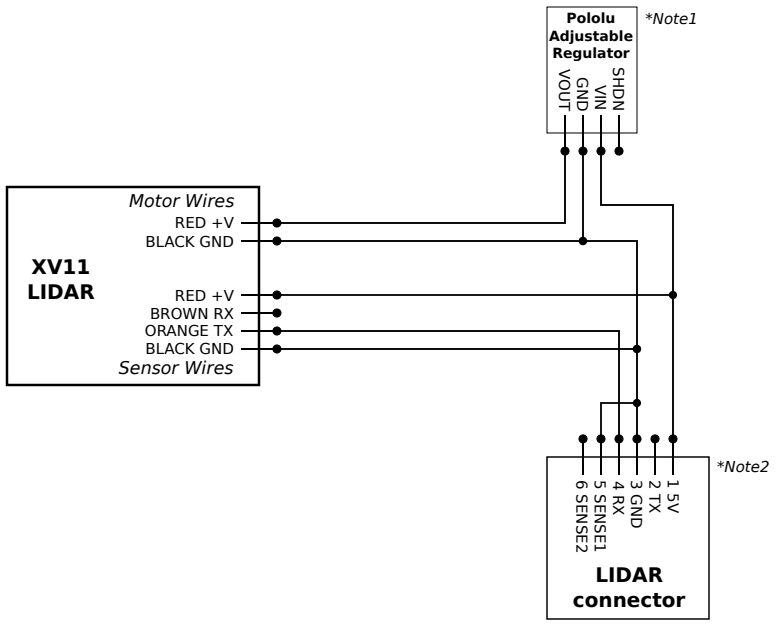
[picture p118: figure]
6 SENSE2; 5 SENSE1; 3 GND; LIDAR; connector¹ ⁵V; Pololu Adjustable Regulator VOUT GND VIN SHDN; *Note1; RED +V BLACK GND; RED +V BROWN RX ORANGE TX BLACK GND; XV11 LIDAR; Motor Wires; Sensor Wires; *Note2

1. Output voltage must be set so that LIDAR rotation speed is between 270 and 300 RPM (target 288 RPM - 4.8 rotations per sec). The voltage varies from LIDAR to LIDAR but is around 2.85 V. If rotation speed exceeds 300 RPM, data will start being corrupted. Also note that the motor starts off at a slightly slower speed, gradually reaching steady state after about 1 minute. So be sure to wait a bit if measuring speed when setting voltage to avoid accidently exceeding the 300 RPM limit.
2. Numbers designate pin numbers on connector.
