Caveatron/caveatron_old_rev-A_version/caveatron-hardware-documentation/Electronics/Caveatron Wiring Diagram Notes - Rev A.pdf

*NOTES
1. Numbers designate pin numbers on connector.
2. Pads for the connections are in various locations on the UT390B board as shown in the photo below. If the alternate JRT 100m laser rangefinder module is used, there is no PWRON pin and the photo below shows the pad locations.
3. Must cut trace that joins the VBATT on the JST connector to the VCC pin to isolate the terminals. On the rear of the board, whent eh words "Fuel Gauge" are at the top, it is the trace that runs from the 12 o'clock to the 3 o'clock position.
4. Requires CR2032 battery to be installed to power clock when system is off.
5. Use right angle locking male headers to connect to the appropriate female headers. The LCD adapter shield is installed on top of the Arduino Due, so the right angle headers will project out to the side from under the LCD adapter shield.
6. Use pins 1 and 2 of the 30 pin header on the LCD adapter shield for 3V3 and GND, respectively.
7. Compass module is sensitive to wires and voltages, so route wiring as far away from the component as possible and be sure attached wires head directly away from the compass module.
8. Adjustable output voltage must be set to 3.0V.
9. Use JST connector labeled "LOAD". The JST connector labelled "BATT" is identical and may need to be removed to avoid interference with Arduino Due board since it goes underneath the Due.

## Caveatron Wiring Diagram- Main Body - Rev A

v. 2019-11-06
UT390B LRF Connections | 100m JRT LRF Connections

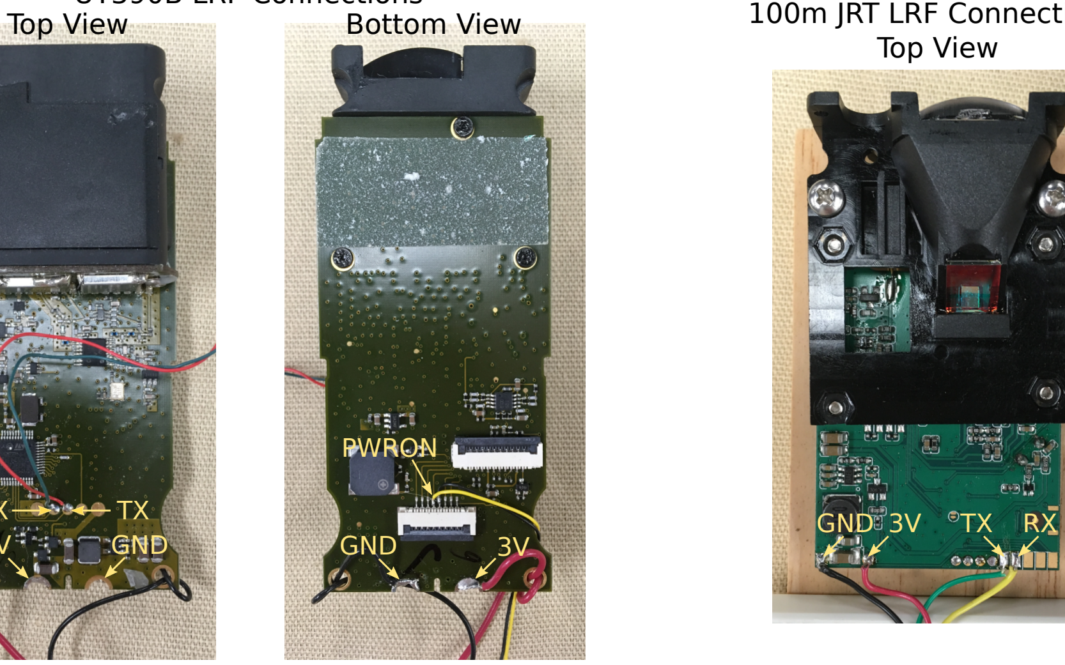
[picture p119: figure]
PWRON; Top View; Bottom View; GND 3V
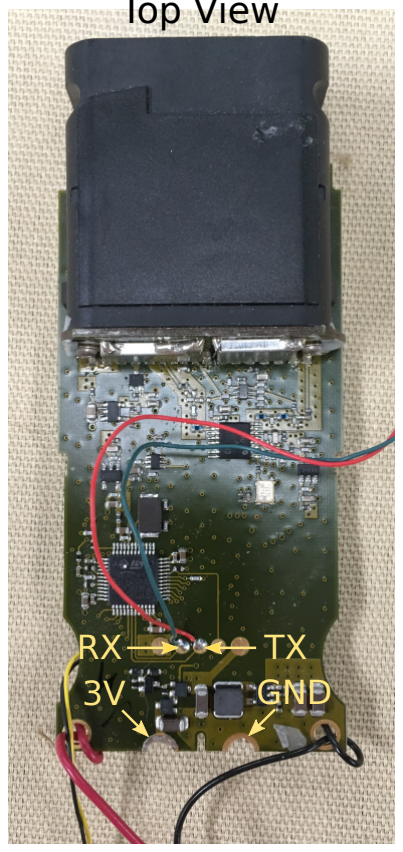
[picture p120: figure]
TXRX
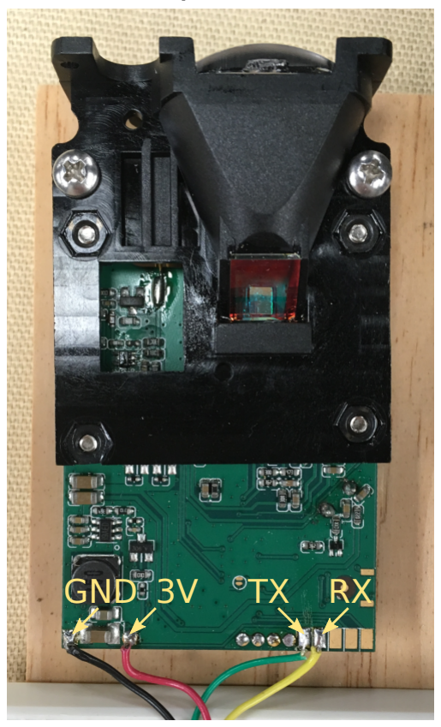
[picture p121: figure]

3V | GND | GND | 3V

The small black wire that connects next to the PWRON pin yellow wire is not required and is common with the GND wire.
