Caveatron/caveatron_old_rev-A_version/caveatron_libraries/Sweep/documentation/wiring_diagrams/MegaSerialPrinter.png

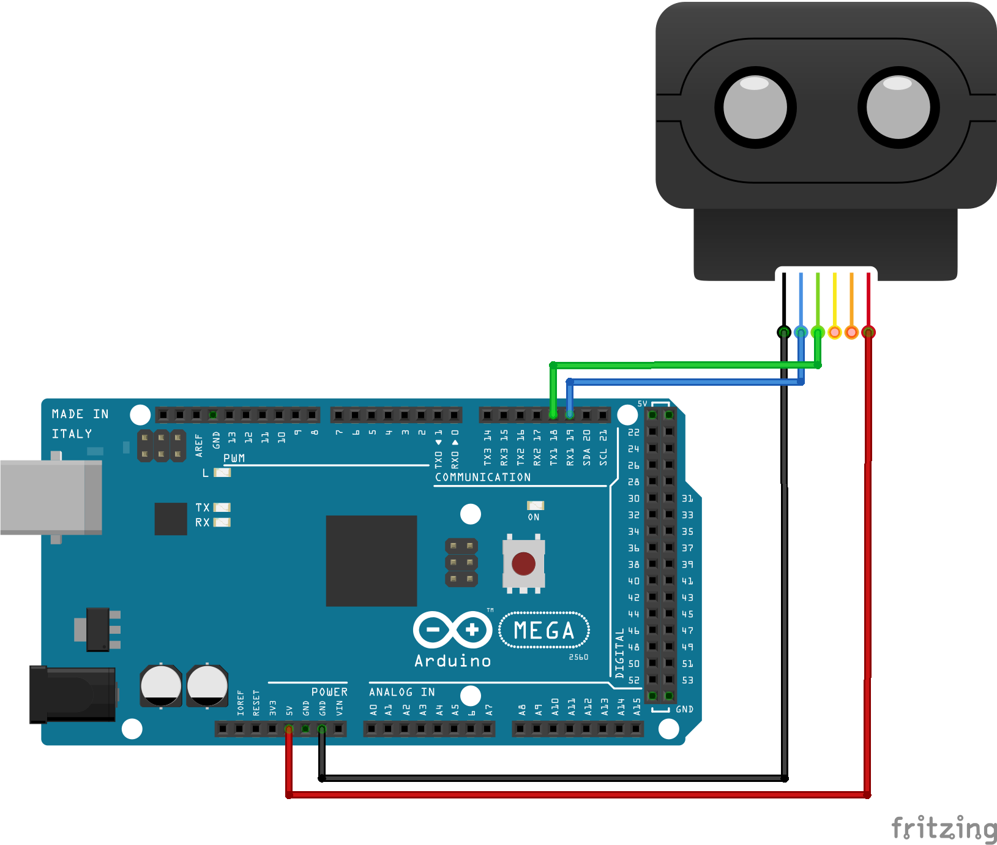
caveatron_libraries/Sweep/documentation/wiring_diagrams/MegaSerialPrinter.png
