Caveatron/caveatron_old_rev-A_version/caveatron-hardware-documentation/Calibration/Caveatron Accelerometer Calibration Calculator.xlsx

Sheet: RESULTS
CAVEATRON ACCELEROMETER CALIBRATION CALCULATOR
Instructions:
In Excel, open each of the 6 accelerometer calibration data files collected on the Caveatron - one for orientation.
Select all 6 columns of data, including the header, from one of the files and copy it.
Select the tab below of the correct orientation of the data just copied and click on the top leftmost cell. Paste the data.
Repeat for each data file until all 6 of the "Values" tabs at bottom have your data entered.
Return to this tab (RESULTS) to obtain the calibration values. They are in the correct matrix order to enter into the calibration uploader.
Accelerometer Calibration Parameters
-0.02136591014 | 0.007348957703 | -0.02782812903
6.342470399e-05 | 1.844633559e-08 | 3.664372819e-07
1.388123326e-08 | 6.263366016e-05 | -3.478649902e-07
-3.387321672e-08 | 2.604331603e-07 | 6.284412576e-05
HINT: If you forgot to name the calibration files properly that you collected on the Caveatron, you can easily figure out which one was which according to the table below
Note that the first three columns contain the accelerometer X, Y, and Z values, respectively
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
