Caveatron/caveatron_old_rev-A_version/caveatron-hardware-documentation/Calibration/Caveatron Magnetometer Calibration Calculator.xlsx

Sheet: PLOT
Enter Actual Azimuth Values |  |  | Adjust these values to minimize the error
0.5 |  |  | UP | DN
31.5 |  | MXOFF | -90 | -10
60 |  | MYOFF | -150 | -150
89.5 |  | MZOFF | 0 | 0
119.5 |  | ROT | 2.5 | 3.8
150.5
180
210.5 |  | AVERAGE: | -0.022 | -0.054
240.5 |  | STD DEV: | 0.218 | 0.306
269.5 |  | MAX ERROR: | 0.37 | 0.45
300
329
Instructions: Enter the measured azimuth values of your calibration range above.
Enter accelerometer and hard/soft iron calibration in Cal Parameters sheet.
Paste up and down oriented measurements from calibration range in correct sheet.
Adjust yellow highlighted values in boxes above until error plot is as flat as possible.
UP Azimuth | DN Azimuth |  | UP Delta | DN Delta
0.2071367104 | 0.0952441447 |  | -0.29 | -0.40
31.48344328 | 31.26910219 |  | -0.02 | -0.23
59.86144092 | 59.77517736 |  | -0.14 | -0.22
89.3244326 | 89.47953742 |  | -0.18 | -0.02
119.8660361 | 119.5363729 |  | 0.37 | 0.04
150.7106433 | 150.8562692 |  | 0.21 | 0.36
180.0113541 | 179.8530536 |  | 0.01 | -0.15
210.7816322 | 210.5817608 |  | 0.28 | 0.08
240.2835091 | 240.1048463 |  | -0.22 | -0.40
269.2057582 | 269.0545146 |  | -0.29 | -0.45
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
