Caveatron/caveatron_old_rev-A_version/caveatron-hardware-documentation/Electronics/Cavatron Board Connections - Rev A.pdf

# Caveatron Rev A Board Connections

2017-09-23

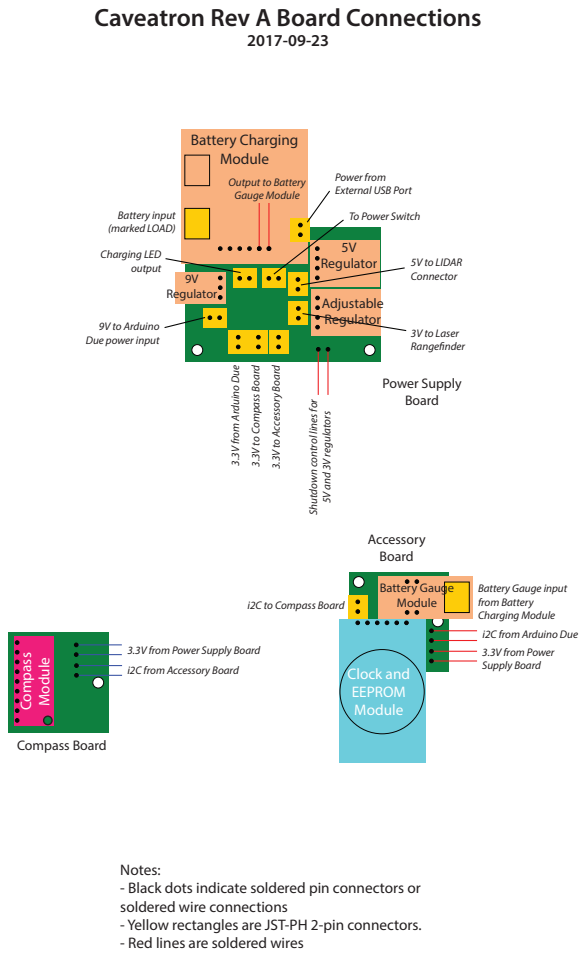
[picture p136: page 1]
Accessory Board; To Power Switch; 5V to LIDAR Connector; 3V to Laser Rangender; 5V and 3V regulators; Charging LED output; Battery input (marked LOAD); Power Supply Board; Compass Board; Compass Module; Clock and EEPROM Module; Battery Gauge Module; Battery Charging Module; 5V Regulator; Adjustable Regulator; 9V Regulator

Power from
External USB Port

Output to Battery
Gauge Module

9V to Arduino
Due power input

3.3V from Arduino Due

3.3V to Compass Board

3.3V to Accessory Board

Shutdown control lines for

Battery Gauge input
from Battery
Charging Module
i2C from Arduino Due
3.3V from Power
Supply Board

i2C to Compass Board

3.3V from Power Supply Board
i2C from Accessory Board

Notes:
- Black dots indicate soldered pin connectors or
soldered wire connections
- Yellow rectangles are JST-PH 2-pin connectors.
- Red lines are soldered wires
