Caveatron/caveatron_old_rev-A_version/caveatron-hardware-documentation/Electronics/Caveatron Wiring Diagram - Rev A.pdf

## UT390B Laser

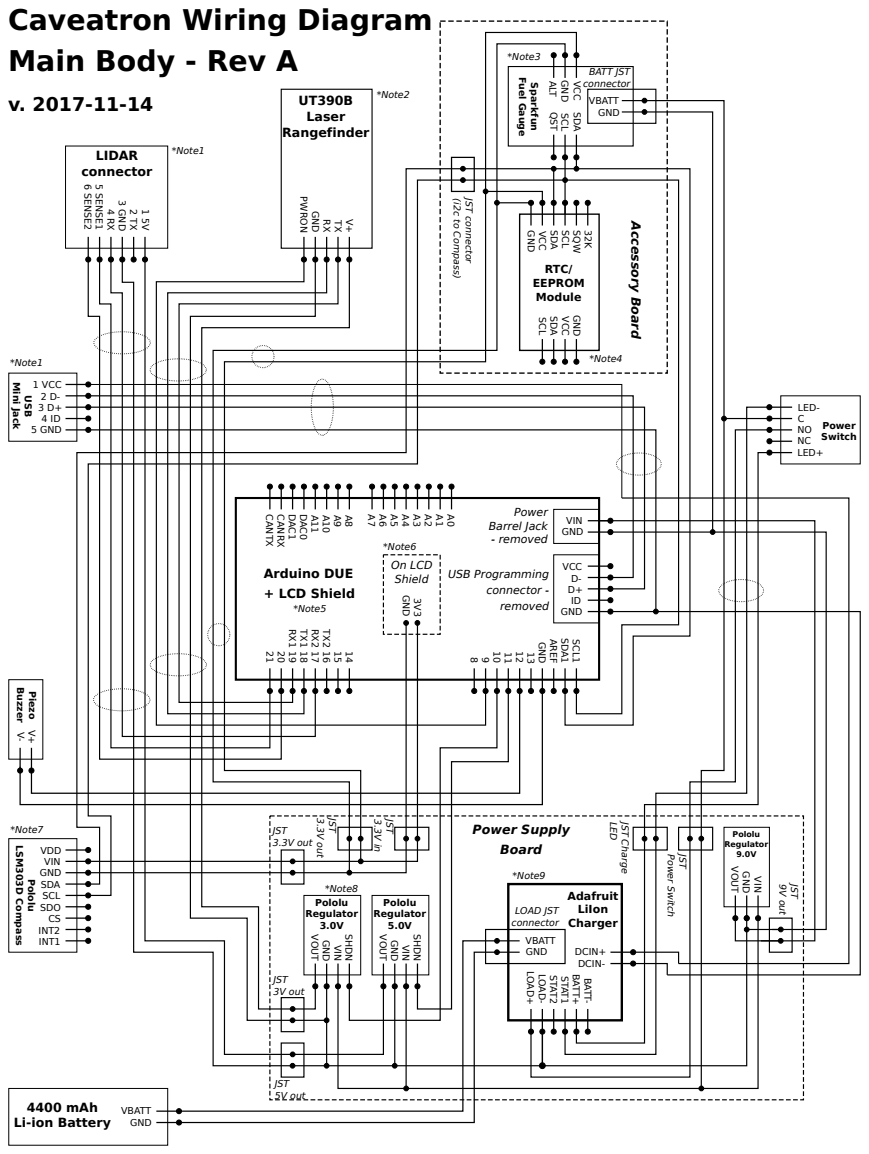
[picture p137: page 1]
Pololu Regulator 3.0V VOUT; GND; VIN; SHDN; Pololu Regulator 5.0V VOUT; SCL; SDA; VDD; SDO CS INT2 INT1; Pololu; LSM303D Compass; VBATT GND; LOAD+; LOAD-; STAT2; STAT1; BATT+; BATT-; DCIN+ DCIN-; VBATT; LOAD JST connector; Adafruit LiIon Charger; Power Switch NC; LED-; LED+; Piezo; Buzzer V-; Sparkfun; Fuel Gauge; QST ALT; VCC; BATT JST connector; SQW; RTC/ EEPROM Module; PWRON; Rangefinder; 6 SENSE2; 5 SENSE1; 3 GND; LIDAR connector1 5V; *Note8; (i2c to Compass); JST connector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

Caveatron Wiring Diagram
Main Body - Rev A

Pololu
Regulator
9.0V VOUT GND VIN

4400 mAh
Li-ion Battery
