Caveatron/caveatron_old_rev-A_version/caveatron-hardware-documentation/Enclosure/Caveatron 25m LIDAR Enclosure - Rev A.pdf

## Caveatron 25m LIDAR Module

## Rev A - For SWEEP LIDAR

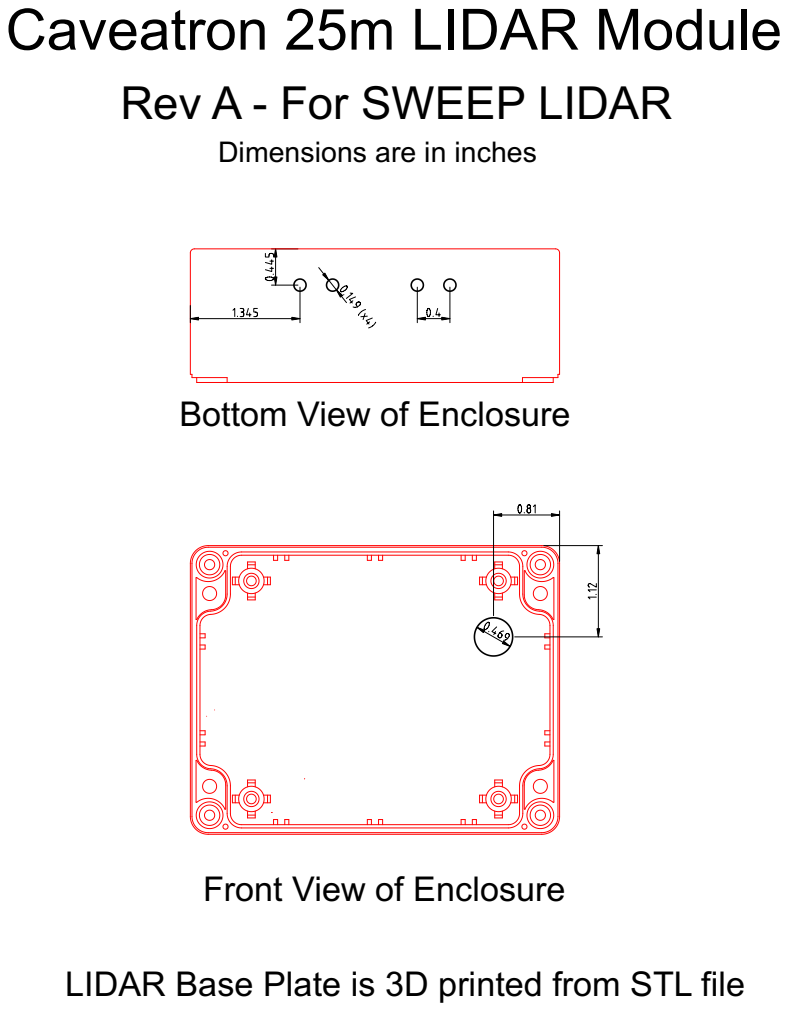
[picture p138: page 1]

Dimensions are in inches

Bottom View of Enclosure

Front View of Enclosure

LIDAR Base Plate is 3D printed from STL file
