Caveatron/caveatron_old_rev-A_version/caveatron-hardware-documentation/Enclosure/Caveatron 4m LIDAR Enclosure Base - Rev A.pdf

## Caveatron 4m LIDAR Module

## Rev A - For XV LIDAR

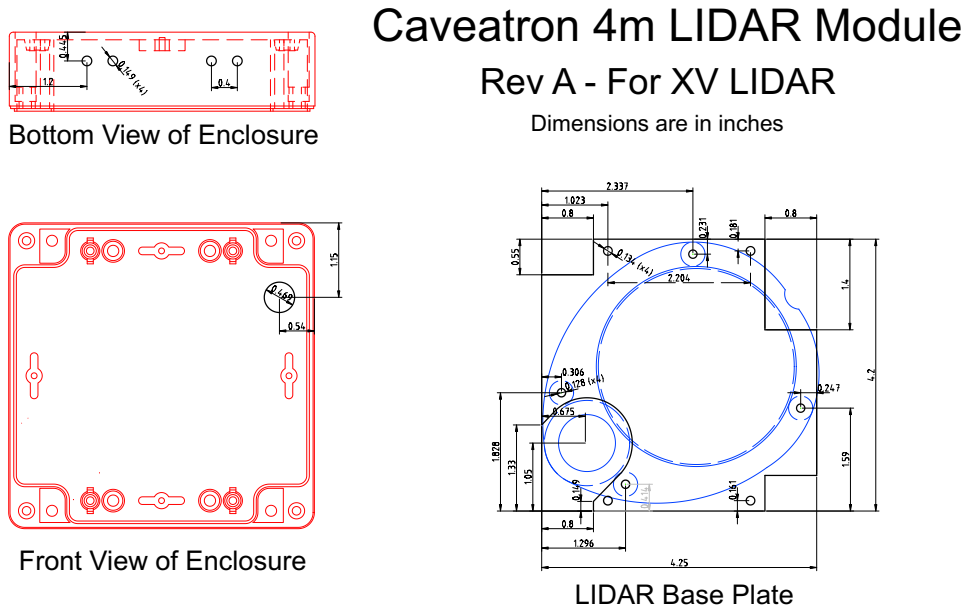
[picture p139: page 1]

Dimensions are in inches

Bottom View of Enclosure

Front View of Enclosure

LIDAR Base Plate
