Caveatron/caveatron_old_rev-A_version/caveatron-hardware-documentation/Enclosure/Caveatron Main Body Base Plate Drawing - Rev A.pdf

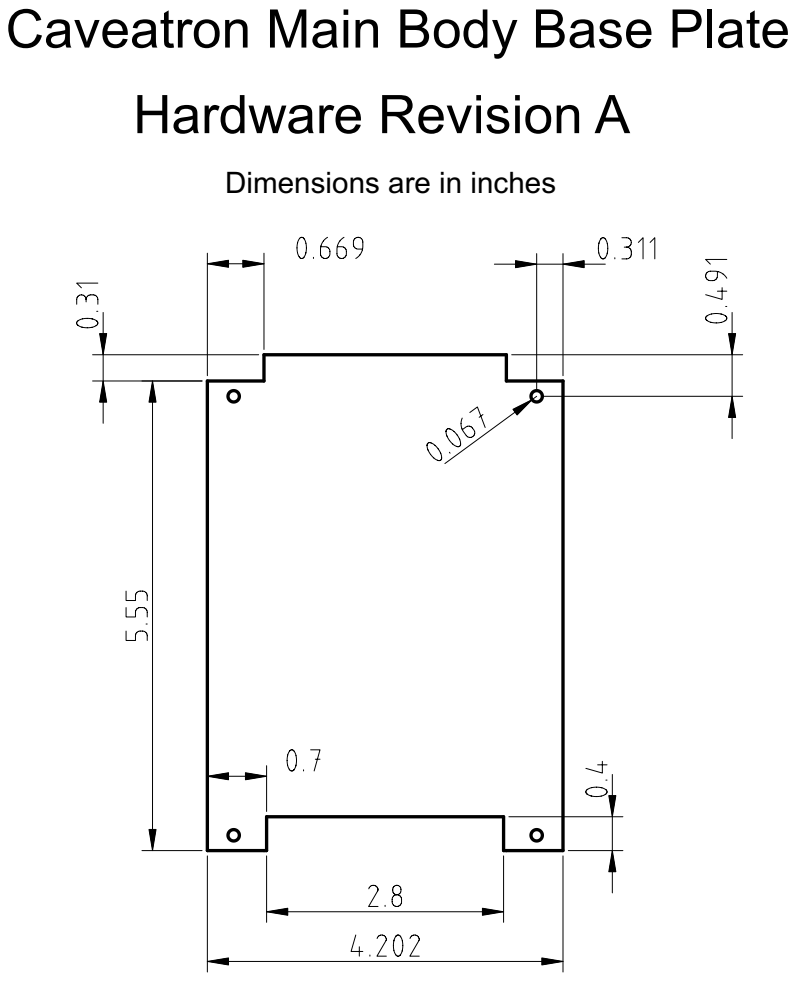
[picture p140: page 1]
Hardware Revision A

Caveatron Main Body Base Plate

Dimensions are in inches
