Caveatron/caveatron_old_rev-A_version/caveatron-hardware-documentation/Enclosure/Caveatron Main Body Enclosure Lid Drawing - Rev A.pdf

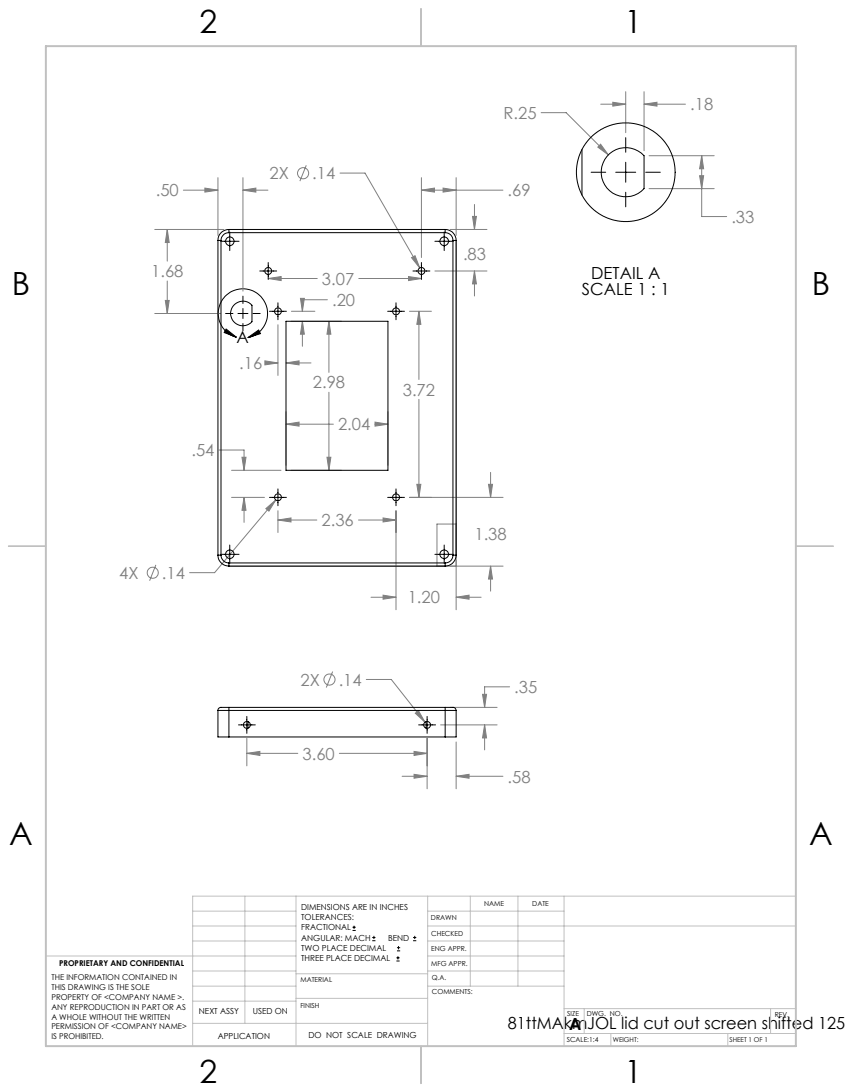
[picture p144: page 1]
DETAIL A SCALE 1 : 1

TOLERANCES: FRACTIONAL ANGULAR: MACH BEND TWO PLACE DECIMAL THREE PLACE DECIMAL | | NAME | DATE DIMENSIONS ARE IN INCHES

DRAWN
CHECKED
ENG APPR.

PROPRIETARY AND CONFIDENTIAL THE INFORMATION CONTAINED IN THIS DRAWING IS THE SOLE PROPERTY OF <COMPANY NAME >. ANY REPRODUCTION IN PART OR AS A WHOLE WITHOUT THE WRITTEN PERMISSION OF <COMPANY NAME> IS PROHIBITED. | | | MFG APPR.

MATERIAL | Q.A.

NEXT ASSY | USED ON | FINISH

81ttMAkmJOL lid cut out screen shifted 125

SIZE A | DWG. NO. | REV.

APPLICATION | | DO NOT SCALE DRAWING

SCALE:1:4 | WEIGHT: | SHEET 1 OF 1
