Caveatron/caveatron_old_rev-A_version/caveatron_libraries/SparkFunBQ27441/documentation/Hardware/sparkfun-battery-babysitter.brd

## EAGLE design caveatron_libraries/SparkFunBQ27441/documentation/Hardware/sparkfun-battery-babysitter.brd (2020-01-26)

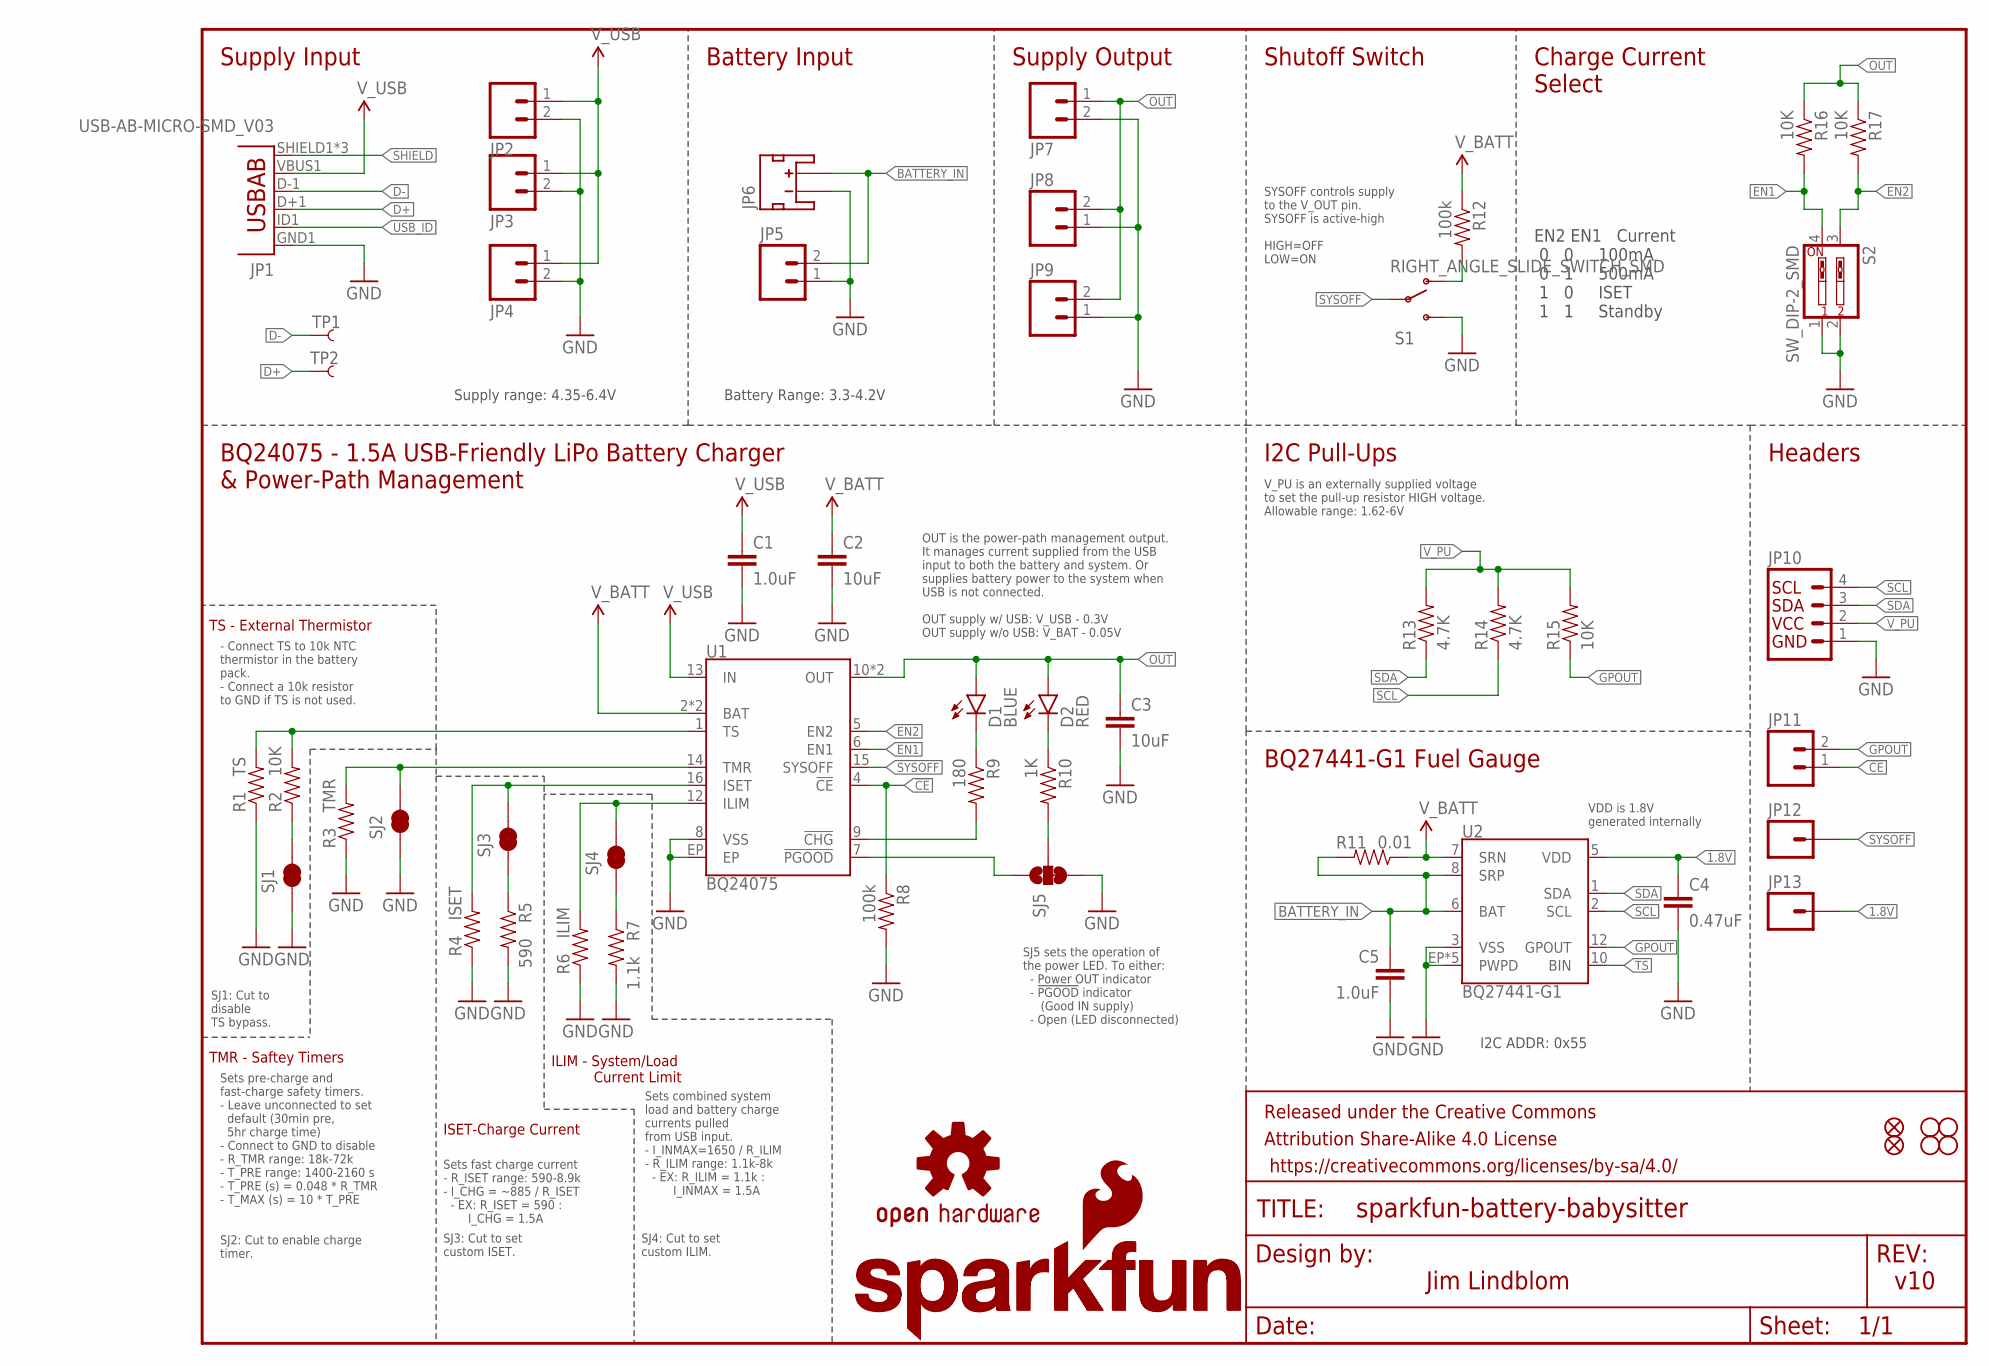
[picture p145: schematic sparkfun-battery-babysitter.sch]

Parts:
C1: 1.0uF; 1206-CAP
C2, C3: 10uF; 0805-CAP
C4: 0.47uF; 0603-CAP
C5: 1.0uF; 0603-CAP
D1: BLUE; LED-0603
D2: RED; LED-0603
FID1, FID2: FIDUCIAL1X2; FIDUCIAL-1X2
FRAME1: FRAME-LETTER; CREATIVE_COMMONS
JP1: USB-AB-MICRO-SMD_V03
JP2, JP4, JP5, JP8, JP11: M021X02_NO_SILK; 1X02_NO_SILK
JP3, JP7: M023.5MM-NO_SILK; SCREWTERMINAL-3.5MM-2-NS
JP6: JST_2MM_MALE; JST-2-SMD
JP9: M02-JST-2-PTH-NO_SILK; JST-2-PTH-NS
JP10: I2C_STANDARD_NO_SILK; 1X04_NO_SILK
JP12, JP13: M01PTH_NO_SILK_YES_STOP; 1X01_NO_SILK
LOGO1: SFE_LOGO_NAME.1_INCH; SFE_LOGO_NAME_.1
LOGO2: SFE_LOGO_NAME_FLAME.1_INCH; SFE_LOGO_NAME_FLAME_.1
LOGO3: OSHW-LOGOS; OSHW-LOGO-S
R1: TS; 1/6W-RES
R2, R15, R16, R17: 10K; 0603-RES
R3: TMR; 1/6W-RES
R4: ISET; 1/6W-RES
R5: 590; 0603-RES
R6: ILIM; 1/6W-RES
R7: 1.1k; 0603-RES
R8, R12: 100k; 0603-RES
R9: 180; 0603-RES
R10: 1K; 0603-RES
R11: 0.01; 1206
R13, R14: 4.7K; 0603-RES
S1: RIGHT_ANGLE_SLIDE_SWITCH_SMD; SWITCH-SPST-SMD-A
S2: SW_DIP-2_SMD; DIPSWITCH-02-50MIL
SJ1, SJ2, SJ3, SJ4: JUMPER-PAD-2-NC_BY_TRACE; PAD-JUMPER-2-NC_BY_TRACE_YES_SILK
SJ5: JUMPER-PAD-3-2OF3_NC_BY_TRACE_SMALL; PAD-JUMPER-3-2OF3_NC_BY_TRACE_YES_SILK_FULL_BOX
STANDOFF1, STANDOFF2, STANDOFF3, STANDOFF4: STAND-OFF
TP1, TP2: TEST-POINT3X4; PAD.03X.04
U1: BQ24075; PVQFN-N16
U2: BQ27441-G1; PDSO-N12

Connections:
1.8V: C4.1, JP13.1, U2.5 (VDD)
!CE!: JP11.1, R8.1, U1.4 (!CE!)
!CHG!: R9.2, U1.9 (!CHG!)
!PGOOD!: SJ5.1, U1.7 (!PGOOD!)
BATTERY_IN: C5.1, JP5.2, JP6.2 (+), R11.2, U2.6 (BAT), U2.8 (SRP)
D+: JP1.D+1 (D+), TP2.P$1
D-: JP1.D-1 (D-), TP1.P$1
EN1: R16.2, S2.4, U1.6 (EN1)
EN2: R17.2, S2.3, U1.5 (EN2)
GND: C1.2, C2.2, C3.2, C4.2, C5.2, JP1.GND1 (GND), JP2.2, JP3.2, JP4.2, JP5.1, JP6.1 (-), JP7.2, JP8.1, JP9.1, JP10.1, R1.1, R3.1, R4.1, R5.2, R6.1, R7.2, R8.2, S1.3 (S), S2.1, S2.2, SJ1.1, SJ2.1, SJ5.3, U1.8 (VSS), U1.EP, U2.3 (VSS), U2.EP (PWPD), U2.EP1 (PWPD), U2.EP2 (PWPD), U2.EP3 (PWPD), U2.EP4 (PWPD)
GPOUT: JP11.2, R15.1, U2.12 (GPOUT)
ILIM: R6.2, SJ4.2, U1.12 (ILIM)
ISET: R4.2, SJ3.2, U1.16 (ISET)
unnamed: R2.1, SJ1.2
unnamed: R7.1, SJ4.1
unnamed: R5.1, SJ3.1
unnamed: R12.2, S1.1 (O)
unnamed: R10.2, SJ5.2
unnamed: D1.C, R9.1
unnamed: D2.C, R10.1
OUT: C3.1, D1.A, D2.A, JP7.1, JP8.2, JP9.2, R16.1, R17.1, U1.10 (OUT), U1.11 (OUT)
SCL: JP10.4, R14.1, U2.2 (SCL)
SDA: JP10.3, R13.1, U2.1 (SDA)
SHIELD: JP1.SHIELD1 (SHIELD), JP1.SHIELD2 (SHIELD), JP1.SHIELD3 (SHIELD)
SYSOFF: JP12.1, S1.2, U1.15 (SYSOFF)
TMR: R3.2, SJ2.2, U1.14 (TMR)
TS: R1.2, R2.2, U1.1 (TS), U2.10 (BIN)
USB_ID: JP1.ID1 (USBID)
V_BATT: C2.1, R11.1, R12.1, U1.2 (BAT), U1.3 (BAT), U2.7 (SRN)
V_PU: JP10.2, R13.2, R14.2, R15.2
V_USB: C1.1, JP1.VBUS1 (VBUS), JP2.1, JP3.1, JP4.1, U1.13 (IN)

Notes on the sheet:
EN2 EN1 Current 0 0 100mA 0 1 500mA 1 0 ISET 1 1 Standby
Sets fast charge current - R_ISET range: 590-8.9k - I_CHG = ~885 / R_ISET - EX: R_ISET = 590 : I_CHG = 1.5A
Sets combined system load and battery charge currents pulled from USB input. - I_INMAX=1650 / R_ILIM - R_ILIM range: 1.1k-8k - EX: R_ILIM = 1.1k : I_INMAX = 1.5A
Supply Input
Battery Input
Supply Output
Shutoff Switch
Charge Current Select
BQ24075 - 1.5A USB-Friendly LiPo Battery Charger & Power-Path Management
I2C Pull-Ups
BQ27441-G1 Fuel Gauge
Headers
Jim Lindblom
v10
SYSOFF controls supply to the V_OUT pin. SYSOFF is active-high HIGH=OFF LOW=ON
SJ1: Cut to disable TS bypass.
SJ3: Cut to set custom ISET.
SJ4: Cut to set custom ILIM.
ILIM - System/Load Current Limit
ISET-Charge Current
TMR - Saftey Timers
Sets pre-charge and fast-charge safety timers. - Leave unconnected to set default (30min pre, 5hr charge time) - Connect to GND to disable - R_TMR range: 18k-72k - T_PRE range: 1400-2160 s - T_PRE (s) = 0.048 * R_TMR - T_MAX (s) = 10 * T_PRE
SJ2: Cut to enable charge timer.
TS - External Thermistor
- Connect TS to 10k NTC thermistor in the battery pack. - Connect a 10k resistor to GND if TS is not used.
V_PU is an externally supplied voltage to set the pull-up resistor HIGH voltage. Allowable range: 1.62-6V
Supply range: 4.35-6.4V
VDD is 1.8V generated internally
OUT is the power-path management output. It manages current supplied from the USB input to both the battery and system. Or supplies battery power to the system when USB is not connected. OUT supply w/ USB: V_USB - 0.3V OUT supply w/o USB: V_BAT - 0.05V
I2C ADDR: 0x55
SJ5 sets the operation of the power LED. To either: - Power OUT indicator - !PGOOD! indicator (Good IN supply) - Open (LED disconnected)
Battery Range: 3.3-4.2V

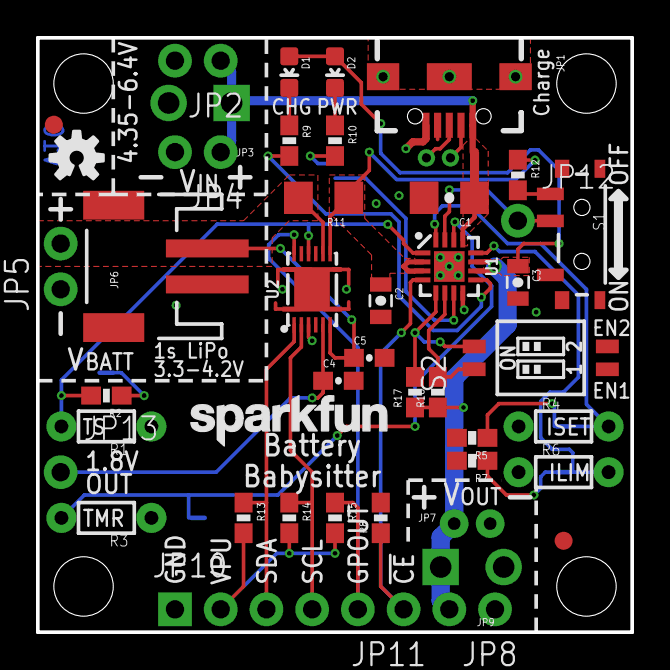
[picture p146: board sparkfun-battery-babysitter.brd from above]

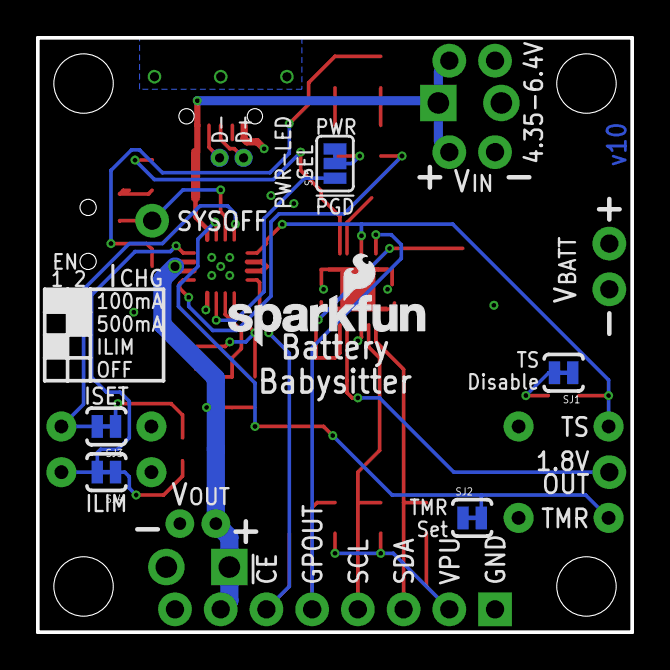
[picture p147: board sparkfun-battery-babysitter.brd from below]

Board: 2 copper layers, 33.0 x 33.0 mm, 58 parts (8 on the bottom side), 30 nets.
