Caveatron/caveatron_old_rev-A_version/caveatron_libraries/SparkFunBQ27441/documentation/Production/sparkfun-battery-babysitter-panel-v10.brd

## EAGLE design caveatron_libraries/SparkFunBQ27441/documentation/Production/sparkfun-battery-babysitter-panel-v10.brd (2020-01-26)

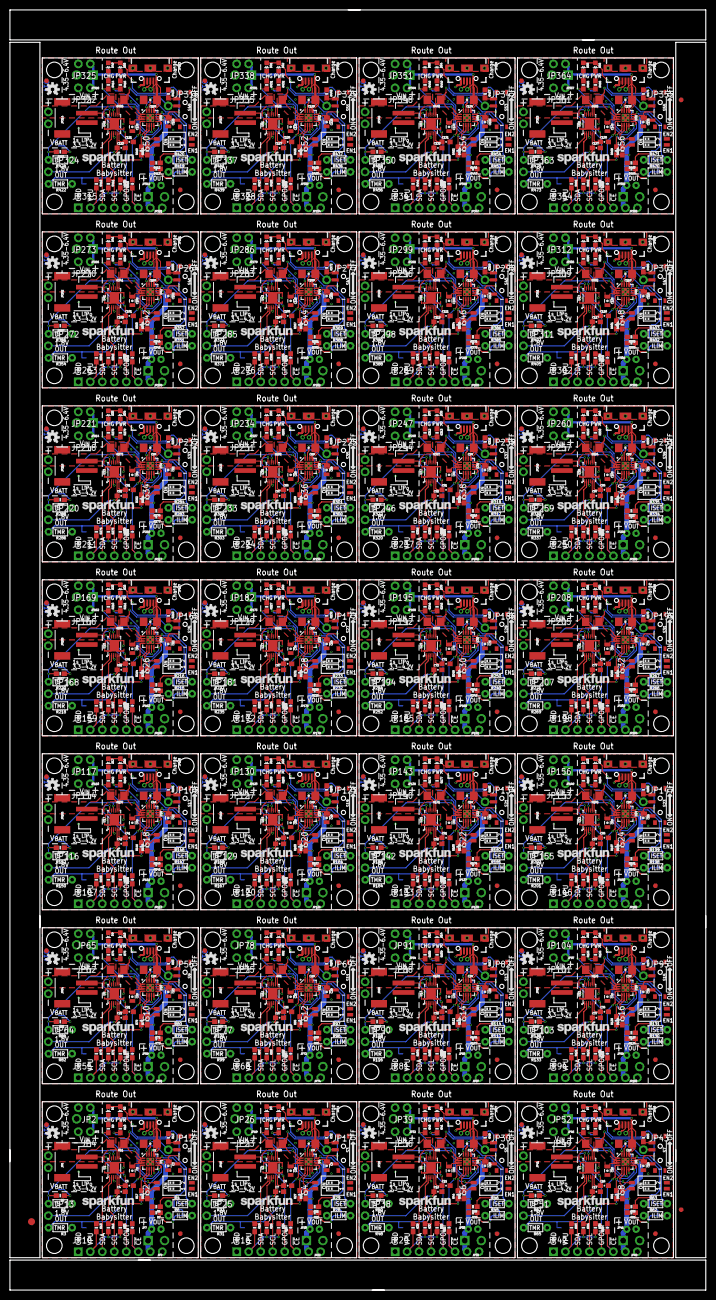
[picture p148: board sparkfun-battery-babysitter-panel-v10.brd from above]

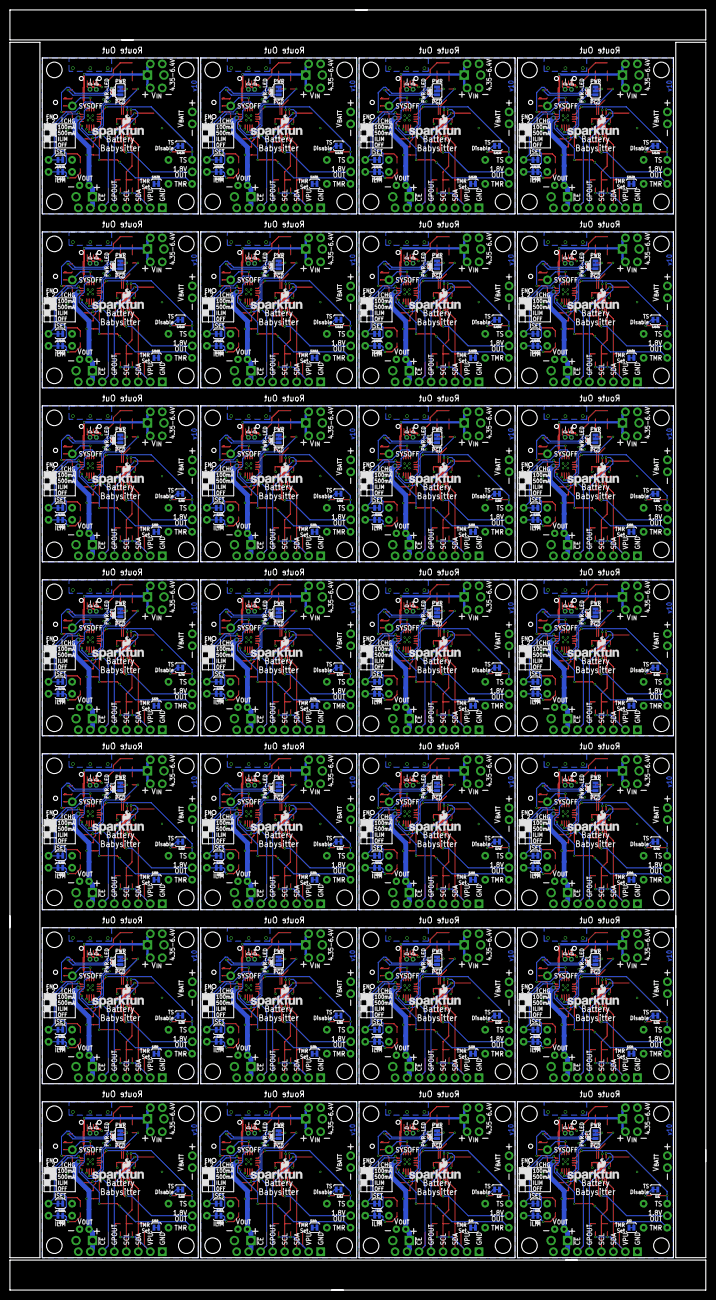
[picture p149: board sparkfun-battery-babysitter-panel-v10.brd from below]

Board: 2 copper layers, 147.3 x 271.0 mm, 1599 parts (224 on the bottom side), 840 nets.

Parts:
C1, C9, C14, C19, C24, C29, C34, C39, C44, C49, C54, C59, C64, C69, C74, C79, C84, C89, C94, C99, C104, C109, C114, C119, C124, C129, C134, C139: 1.0uF; 1206-CAP
C2, C3, C8, C10, C13, C15, C18, C20, C23, C25, C28, C30, C33, C35, C38, C40, C43, C45, C48, C50, C53, C55, C58, C60, C63, C65, C68, C70, C73, C75, C78, C80, C83, C85, C88, C90, C93, C95, C98, C100, C103, C105, C108, C110, C113, C115, C118, C120, C123, C125, C128, C130, C133, C135, C138, C140: 10uF; 0805-CAP
C4, C7, C12, C17, C22, C27, C32, C37, C42, C47, C52, C57, C62, C67, C72, C77, C82, C87, C92, C97, C102, C107, C112, C117, C122, C127, C132, C137: 0.47uF; 0603-CAP
C5, C6, C11, C16, C21, C26, C31, C36, C41, C46, C51, C56, C61, C66, C71, C76, C81, C86, C91, C96, C101, C106, C111, C116, C121, C126, C131, C136: 1.0uF; 0603-CAP
D1, D3, D5, D7, D9, D11, D13, D15, D17, D19, D21, D23, D25, D27, D29, D31, D33, D35, D37, D39, D41, D43, D45, D47, D49, D51, D53, D55: BLUE; LED-0603
D2, D4, D6, D8, D10, D12, D14, D16, D18, D20, D22, D24, D26, D28, D30, D32, D34, D36, D38, D40, D42, D44, D46, D48, D50, D52, D54, D56: RED; LED-0603
E$1: FIDUCIAL-1.5X3
E$5, E$6: FIDUCIAL-1X2
FID1, FID2, FID3, FID4, FID5, FID6, FID7, FID8, FID9, FID10, FID11, FID12, FID13, FID14, FID15, FID16, FID17, FID18, FID19, FID20, FID21, FID22, FID23, FID24, FID25, FID26, FID27, FID28, FID29, FID30, FID31, FID32, FID33, FID34, FID35, FID36, FID37, FID38, FID39, FID40, FID41, FID42, FID43, FID44, FID45, FID46, FID47, FID48, FID49, FID50, FID51, FID52, FID53, FID54, FID55, FID56: FIDUCIAL1X2; FIDUCIAL-1X2
JP1, JP14, JP27, JP40, JP53, JP66, JP79, JP92, JP105, JP118, JP131, JP144, JP157, JP170, JP183, JP196, JP209, JP222, JP235, JP248, JP261, JP274, JP287, JP300, JP313, JP326, JP339, JP352: USB-AB-MICRO-SMD_V03
JP2, JP4, JP5, JP8, JP11, JP18, JP21, JP23, JP24, JP26, JP31, JP34, JP36, JP37, JP39, JP44, JP47, JP49, JP50, JP52, JP57, JP60, JP62, JP63, JP65, JP70, JP73, JP75, JP76, JP78, JP83, JP86, JP88, JP89, JP91, JP96, JP99, JP101, JP102, JP104, JP109, JP112, JP114, JP115, JP117, JP122, JP125, JP127, JP128, JP130, JP135, JP138, JP140, JP141, JP143, JP148, JP151, JP153, JP154, JP156, JP161, JP164, JP166, JP167, JP169, JP174, JP177, JP179, JP180, JP182, JP187, JP190, JP192, JP193, JP195, JP200, JP203, JP205, JP206, JP208, JP213, JP216, JP218, JP219, JP221, JP226, JP229, JP231, JP232, JP234, JP239, JP242, JP244, JP245, JP247, JP252, JP255, JP257, JP258, JP260, JP265, JP268, JP270, JP271, JP273, JP278, JP281, JP283, JP284, JP286, JP291, JP294, JP296, JP297, JP299, JP304, JP307, JP309, JP310, JP312, JP317, JP320, JP322, JP323, JP325, JP330, JP333, JP335, JP336, JP338, JP343, JP346, JP348, JP349, JP351, JP356, JP359, JP361, JP362, JP364: 1X02_NO_SILK
JP3, JP7, JP19, JP20, JP32, JP33, JP45, JP46, JP58, JP59, JP71, JP72, JP84, JP85, JP97, JP98, JP110, JP111, JP123, JP124, JP136, JP137, JP149, JP150, JP162, JP163, JP175, JP176, JP188, JP189, JP201, JP202, JP214, JP215, JP227, JP228, JP240, JP241, JP253, JP254, JP266, JP267, JP279, JP280, JP292, JP293, JP305, JP306, JP318, JP319, JP331, JP332, JP344, JP345, JP357, JP358: SCREWTERMINAL-3.5MM-2-NS
JP6, JP15, JP28, JP41, JP54, JP67, JP80, JP93, JP106, JP119, JP132, JP145, JP158, JP171, JP184, JP197, JP210, JP223, JP236, JP249, JP262, JP275, JP288, JP301, JP314, JP327, JP340, JP353: JST-2-SMD
JP9, JP22, JP35, JP48, JP61, JP74, JP87, JP100, JP113, JP126, JP139, JP152, JP165, JP178, JP191, JP204, JP217, JP230, JP243, JP256, JP269, JP282, JP295, JP308, JP321, JP334, JP347, JP360: JST-2-PTH-NS
JP10, JP16, JP29, JP42, JP55, JP68, JP81, JP94, JP107, JP120, JP133, JP146, JP159, JP172, JP185, JP198, JP211, JP224, JP237, JP250, JP263, JP276, JP289, JP302, JP315, JP328, JP341, JP354: 1X04_NO_SILK
JP12, JP13, JP17, JP25, JP30, JP38, JP43, JP51, JP56, JP64, JP69, JP77, JP82, JP90, JP95, JP103, JP108, JP116, JP121, JP129, JP134, JP142, JP147, JP155, JP160, JP168, JP173, JP181, JP186, JP194, JP199, JP207, JP212, JP220, JP225, JP233, JP238, JP246, JP251, JP259, JP264, JP272, JP277, JP285, JP290, JP298, JP303, JP311, JP316, JP324, JP329, JP337, JP342, JP350, JP355, JP363: 1X01_NO_SILK
LOGO1, LOGO4, LOGO7, LOGO10, LOGO13, LOGO16, LOGO19, LOGO22, LOGO25, LOGO28, LOGO31, LOGO34, LOGO37, LOGO40, LOGO43, LOGO46, LOGO49, LOGO52, LOGO55, LOGO58, LOGO61, LOGO64, LOGO67, LOGO70, LOGO73, LOGO76, LOGO79, LOGO82: SFE_LOGO_NAME.1_INCH; SFE_LOGO_NAME_.1
LOGO2, LOGO6, LOGO9, LOGO12, LOGO15, LOGO18, LOGO21, LOGO24, LOGO27, LOGO30, LOGO33, LOGO36, LOGO39, LOGO42, LOGO45, LOGO48, LOGO51, LOGO54, LOGO57, LOGO60, LOGO63, LOGO66, LOGO69, LOGO72, LOGO75, LOGO78, LOGO81, LOGO84: SFE_LOGO_NAME_FLAME.1_INCH; SFE_LOGO_NAME_FLAME_.1
LOGO3, LOGO5, LOGO8, LOGO11, LOGO14, LOGO17, LOGO20, LOGO23, LOGO26, LOGO29, LOGO32, LOGO35, LOGO38, LOGO41, LOGO44, LOGO47, LOGO50, LOGO53, LOGO56, LOGO59, LOGO62, LOGO65, LOGO68, LOGO71, LOGO74, LOGO77, LOGO80, LOGO83: OSHW-LOGOS; OSHW-LOGO-S
R1, R33, R50, R67, R84, R101, R118, R135, R152, R169, R186, R203, R220, R237, R254, R271, R288, R305, R322, R339, R356, R373, R390, R407, R424, R441, R458, R475: TS; 1/6W-RES
R2, R15, R16, R17, R26, R27, R30, R34, R43, R44, R47, R51, R60, R61, R64, R68, R77, R78, R81, R85, R94, R95, R98, R102, R111, R112, R115, R119, R128, R129, R132, R136, R145, R146, R149, R153, R162, R163, R166, R170, R179, R180, R183, R187, R196, R197, R200, R204, R213, R214, R217, R221, R230, R231, R234, R238, R247, R248, R251, R255, R264, R265, R268, R272, R281, R282, R285, R289, R298, R299, R302, R306, R315, R316, R319, R323, R332, R333, R336, R340, R349, R350, R353, R357, R366, R367, R370, R374, R383, R384, R387, R391, R400, R401, R404, R408, R417, R418, R421, R425, R434, R435, R438, R442, R451, R452, R455, R459, R468, R469, R472, R476: 10K; 0603-RES
R3, R31, R48, R65, R82, R99, R116, R133, R150, R167, R184, R201, R218, R235, R252, R269, R286, R303, R320, R337, R354, R371, R388, R405, R422, R439, R456, R473: TMR; 1/6W-RES
R4, R29, R46, R63, R80, R97, R114, R131, R148, R165, R182, R199, R216, R233, R250, R267, R284, R301, R318, R335, R352, R369, R386, R403, R420, R437, R454, R471: ISET; 1/6W-RES
R5, R21, R38, R55, R72, R89, R106, R123, R140, R157, R174, R191, R208, R225, R242, R259, R276, R293, R310, R327, R344, R361, R378, R395, R412, R429, R446, R463: 590; 0603-RES
R6, R28, R45, R62, R79, R96, R113, R130, R147, R164, R181, R198, R215, R232, R249, R266, R283, R300, R317, R334, R351, R368, R385, R402, R419, R436, R453, R470: ILIM; 1/6W-RES
R7, R22, R39, R56, R73, R90, R107, R124, R141, R158, R175, R192, R209, R226, R243, R260, R277, R294, R311, R328, R345, R362, R379, R396, R413, R430, R447, R464: 1.1k; 0603-RES
R8, R12, R25, R32, R42, R49, R59, R66, R76, R83, R93, R100, R110, R117, R127, R134, R144, R151, R161, R168, R178, R185, R195, R202, R212, R219, R229, R236, R246, R253, R263, R270, R280, R287, R297, R304, R314, R321, R331, R338, R348, R355, R365, R372, R382, R389, R399, R406, R416, R423, R433, R440, R450, R457, R467, R474: 100k; 0603-RES
R9, R23, R40, R57, R74, R91, R108, R125, R142, R159, R176, R193, R210, R227, R244, R261, R278, R295, R312, R329, R346, R363, R380, R397, R414, R431, R448, R465: 180; 0603-RES
R10, R24, R41, R58, R75, R92, R109, R126, R143, R160, R177, R194, R211, R228, R245, R262, R279, R296, R313, R330, R347, R364, R381, R398, R415, R432, R449, R466: 1K; 0603-RES
R11, R18, R35, R52, R69, R86, R103, R120, R137, R154, R171, R188, R205, R222, R239, R256, R273, R290, R307, R324, R341, R358, R375, R392, R409, R426, R443, R460: 0.01; 1206
R13, R14, R19, R20, R36, R37, R53, R54, R70, R71, R87, R88, R104, R105, R121, R122, R138, R139, R155, R156, R172, R173, R189, R190, R206, R207, R223, R224, R240, R241, R257, R258, R274, R275, R291, R292, R308, R309, R325, R326, R342, R343, R359, R360, R376, R377, R393, R394, R410, R411, R427, R428, R444, R445, R461, R462: 4.7K; 0603-RES
S1, S3, S5, S7, S9, S11, S13, S15, S17, S19, S21, S23, S25, S27, S29, S31, S33, S35, S37, S39, S41, S43, S45, S47, S49, S51, S53, S55: SWITCH-SPST-SMD-A
S2, S4, S6, S8, S10, S12, S14, S16, S18, S20, S22, S24, S26, S28, S30, S32, S34, S36, S38, S40, S42, S44, S46, S48, S50, S52, S54, S56: DIPSWITCH-02-50MIL
SJ1, SJ2, SJ3, SJ4, SJ6, SJ7, SJ8, SJ9, SJ11, SJ12, SJ13, SJ14, SJ16, SJ17, SJ18, SJ19, SJ21, SJ22, SJ23, SJ24, SJ26, SJ27, SJ28, SJ29, SJ31, SJ32, SJ33, SJ34, SJ36, SJ37, SJ38, SJ39, SJ41, SJ42, SJ43, SJ44, SJ46, SJ47, SJ48, SJ49, SJ51, SJ52, SJ53, SJ54, SJ56, SJ57, SJ58, SJ59, SJ61, SJ62, SJ63, SJ64, SJ66, SJ67, SJ68, SJ69, SJ71, SJ72, SJ73, SJ74, SJ76, SJ77, SJ78, SJ79, SJ81, SJ82, SJ83, SJ84, SJ86, SJ87, SJ88, SJ89, SJ91, SJ92, SJ93, SJ94, SJ96, SJ97, SJ98, SJ99, SJ101, SJ102, SJ103, SJ104, SJ106, SJ107, SJ108, SJ109, SJ111, SJ112, SJ113, SJ114, SJ116, SJ117, SJ118, SJ119, SJ121, SJ122, SJ123, SJ124, SJ126, SJ127, SJ128, SJ129, SJ131, SJ132, SJ133, SJ134, SJ136, SJ137, SJ138, SJ139: PAD-JUMPER-2-NC_BY_TRACE_YES_SILK
SJ5, SJ10, SJ15, SJ20, SJ25, SJ30, SJ35, SJ40, SJ45, SJ50, SJ55, SJ60, SJ65, SJ70, SJ75, SJ80, SJ85, SJ90, SJ95, SJ100, SJ105, SJ110, SJ115, SJ120, SJ125, SJ130, SJ135, SJ140: PAD-JUMPER-3-2OF3_NC_BY_TRACE_YES_SILK_FULL_BOX
STANDOFF1, STANDOFF2, STANDOFF3, STANDOFF4, STANDOFF5, STANDOFF6, STANDOFF7, STANDOFF8, STANDOFF9, STANDOFF10, STANDOFF11, STANDOFF12, STANDOFF13, STANDOFF14, STANDOFF15, STANDOFF16, STANDOFF17, STANDOFF18, STANDOFF19, STANDOFF20, STANDOFF21, STANDOFF22, STANDOFF23, STANDOFF24, STANDOFF25, STANDOFF26, STANDOFF27, STANDOFF28, STANDOFF29, STANDOFF30, STANDOFF31, STANDOFF32, STANDOFF33, STANDOFF34, STANDOFF35, STANDOFF36, STANDOFF37, STANDOFF38, STANDOFF39, STANDOFF40, STANDOFF41, STANDOFF42, STANDOFF43, STANDOFF44, STANDOFF45, STANDOFF46, STANDOFF47, STANDOFF48, STANDOFF49, STANDOFF50, STANDOFF51, STANDOFF52, STANDOFF53, STANDOFF54, STANDOFF55, STANDOFF56, STANDOFF57, STANDOFF58, STANDOFF59, STANDOFF60, STANDOFF61, STANDOFF62, STANDOFF63, STANDOFF64, STANDOFF65, STANDOFF66, STANDOFF67, STANDOFF68, STANDOFF69, STANDOFF70, STANDOFF71, STANDOFF72, STANDOFF73, STANDOFF74, STANDOFF75, STANDOFF76, STANDOFF77, STANDOFF78, STANDOFF79, STANDOFF80, STANDOFF81, STANDOFF82, STANDOFF83, STANDOFF84, STANDOFF85, STANDOFF86, STANDOFF87, STANDOFF88, STANDOFF89, STANDOFF90, STANDOFF91, STANDOFF92, STANDOFF93, STANDOFF94, STANDOFF95, STANDOFF96, STANDOFF97, STANDOFF98, STANDOFF99, STANDOFF100, STANDOFF101, STANDOFF102, STANDOFF103, STANDOFF104, STANDOFF105, STANDOFF106, STANDOFF107, STANDOFF108, STANDOFF109, STANDOFF110, STANDOFF111, STANDOFF112: STAND-OFF
TP1, TP2, TP3, TP4, TP5, TP6, TP7, TP8, TP9, TP10, TP11, TP12, TP13, TP14, TP15, TP16, TP17, TP18, TP19, TP20, TP21, TP22, TP23, TP24, TP25, TP26, TP27, TP28, TP29, TP30, TP31, TP32, TP33, TP34, TP35, TP36, TP37, TP38, TP39, TP40, TP41, TP42, TP43, TP44, TP45, TP46, TP47, TP48, TP49, TP50, TP51, TP52, TP53, TP54, TP55, TP56: PAD.03X.04
U1, U4, U6, U8, U10, U12, U14, U16, U18, U20, U22, U24, U26, U28, U30, U32, U34, U36, U38, U40, U42, U44, U46, U48, U50, U52, U54, U56: BQ24075; PVQFN-N16
U2, U3, U5, U7, U9, U11, U13, U15, U17, U19, U21, U23, U25, U27, U29, U31, U33, U35, U37, U39, U41, U43, U45, U47, U49, U51, U53, U55: BQ27441-G1; PDSO-N12

Connections:
1.8V: C4.1, JP13.1, U2.5
1.8V1: C7.1, JP25.1, U3.5
1.8V2: C12.1, JP38.1, U5.5
1.8V3: C17.1, JP51.1, U7.5
1.8V4: C22.1, JP64.1, U9.5
1.8V5: C27.1, JP77.1, U11.5
1.8V6: C32.1, JP90.1, U13.5
1.8V7: C37.1, JP103.1, U15.5
1.8V8: C42.1, JP116.1, U17.5
1.8V9: C47.1, JP129.1, U19.5
1.8V10: C52.1, JP142.1, U21.5
1.8V11: C57.1, JP155.1, U23.5
1.8V12: C62.1, JP168.1, U25.5
1.8V13: C67.1, JP181.1, U27.5
1.8V14: C72.1, JP194.1, U29.5
1.8V15: C77.1, JP207.1, U31.5
1.8V16: C82.1, JP220.1, U33.5
1.8V17: C87.1, JP233.1, U35.5
1.8V18: C92.1, JP246.1, U37.5
1.8V19: C97.1, JP259.1, U39.5
1.8V20: C102.1, JP272.1, U41.5
1.8V21: C107.1, JP285.1, U43.5
1.8V22: C112.1, JP298.1, U45.5
1.8V23: C117.1, JP311.1, U47.5
1.8V24: C122.1, JP324.1, U49.5
1.8V25: C127.1, JP337.1, U51.5
1.8V26: C132.1, JP350.1, U53.5
1.8V27: C137.1, JP363.1, U55.5
!CE!: JP11.1, R8.1, U1.4
!CE!1: JP24.1, R25.1, U4.4
!CE!2: JP37.1, R42.1, U6.4
!CE!3: JP50.1, R59.1, U8.4
!CE!4: JP63.1, R76.1, U10.4
!CE!5: JP76.1, R93.1, U12.4
!CE!6: JP89.1, R110.1, U14.4
!CE!7: JP102.1, R127.1, U16.4
!CE!8: JP115.1, R144.1, U18.4
!CE!9: JP128.1, R161.1, U20.4
!CE!10: JP141.1, R178.1, U22.4
!CE!11: JP154.1, R195.1, U24.4
!CE!12: JP167.1, R212.1, U26.4
!CE!13: JP180.1, R229.1, U28.4
!CE!14: JP193.1, R246.1, U30.4
!CE!15: JP206.1, R263.1, U32.4
!CE!16: JP219.1, R280.1, U34.4
!CE!17: JP232.1, R297.1, U36.4
!CE!18: JP245.1, R314.1, U38.4
!CE!19: JP258.1, R331.1, U40.4
!CE!20: JP271.1, R348.1, U42.4
!CE!21: JP284.1, R365.1, U44.4
!CE!22: JP297.1, R382.1, U46.4
!CE!23: JP310.1, R399.1, U48.4
!CE!24: JP323.1, R416.1, U50.4
!CE!25: JP336.1, R433.1, U52.4
!CE!26: JP349.1, R450.1, U54.4
!CE!27: JP362.1, R467.1, U56.4
!CHG!: R9.2, U1.9
!CHG!1: R23.2, U4.9
!CHG!2: R40.2, U6.9
!CHG!3: R57.2, U8.9
!CHG!4: R74.2, U10.9
!CHG!5: R91.2, U12.9
!CHG!6: R108.2, U14.9
!CHG!7: R125.2, U16.9
!CHG!8: R142.2, U18.9
!CHG!9: R159.2, U20.9
!CHG!10: R176.2, U22.9
!CHG!11: R193.2, U24.9
!CHG!12: R210.2, U26.9
!CHG!13: R227.2, U28.9
!CHG!14: R244.2, U30.9
!CHG!15: R261.2, U32.9
!CHG!16: R278.2, U34.9
!CHG!17: R295.2, U36.9
!CHG!18: R312.2, U38.9
!CHG!19: R329.2, U40.9
!CHG!20: R346.2, U42.9
!CHG!21: R363.2, U44.9
!CHG!22: R380.2, U46.9
!CHG!23: R397.2, U48.9
!CHG!24: R414.2, U50.9
!CHG!25: R431.2, U52.9
!CHG!26: R448.2, U54.9
!CHG!27: R465.2, U56.9
!PGOOD!: SJ5.1, U1.7
!PGOOD!1: SJ10.1, U4.7
!PGOOD!2: SJ15.1, U6.7
!PGOOD!3: SJ20.1, U8.7
!PGOOD!4: SJ25.1, U10.7
!PGOOD!5: SJ30.1, U12.7
!PGOOD!6: SJ35.1, U14.7
!PGOOD!7: SJ40.1, U16.7
!PGOOD!8: SJ45.1, U18.7
!PGOOD!9: SJ50.1, U20.7
!PGOOD!10: SJ55.1, U22.7
!PGOOD!11: SJ60.1, U24.7
!PGOOD!12: SJ65.1, U26.7
!PGOOD!13: SJ70.1, U28.7
!PGOOD!14: SJ75.1, U30.7
!PGOOD!15: SJ80.1, U32.7
!PGOOD!16: SJ85.1, U34.7
!PGOOD!17: SJ90.1, U36.7
!PGOOD!18: SJ95.1, U38.7
!PGOOD!19: SJ100.1, U40.7
!PGOOD!20: SJ105.1, U42.7
!PGOOD!21: SJ110.1, U44.7
!PGOOD!22: SJ115.1, U46.7
!PGOOD!23: SJ120.1, U48.7
!PGOOD!24: SJ125.1, U50.7
!PGOOD!25: SJ130.1, U52.7
!PGOOD!26: SJ135.1, U54.7
!PGOOD!27: SJ140.1, U56.7
BATTERY_IN: C5.1, JP5.2, JP6.2, R11.2, U2.6, U2.8
BATTERY_IN1: C6.1, JP15.2, JP18.2, R18.2, U3.6, U3.8
BATTERY_IN2: C11.1, JP28.2, JP31.2, R35.2, U5.6, U5.8
BATTERY_IN3: C16.1, JP41.2, JP44.2, R52.2, U7.6, U7.8
BATTERY_IN4: C21.1, JP54.2, JP57.2, R69.2, U9.6, U9.8
BATTERY_IN5: C26.1, JP67.2, JP70.2, R86.2, U11.6, U11.8
BATTERY_IN6: C31.1, JP80.2, JP83.2, R103.2, U13.6, U13.8
BATTERY_IN7: C36.1, JP93.2, JP96.2, R120.2, U15.6, U15.8
BATTERY_IN8: C41.1, JP106.2, JP109.2, R137.2, U17.6, U17.8
BATTERY_IN9: C46.1, JP119.2, JP122.2, R154.2, U19.6, U19.8
BATTERY_IN10: C51.1, JP132.2, JP135.2, R171.2, U21.6, U21.8
BATTERY_IN11: C56.1, JP145.2, JP148.2, R188.2, U23.6, U23.8
BATTERY_IN12: C61.1, JP158.2, JP161.2, R205.2, U25.6, U25.8
BATTERY_IN13: C66.1, JP171.2, JP174.2, R222.2, U27.6, U27.8
BATTERY_IN14: C71.1, JP184.2, JP187.2, R239.2, U29.6, U29.8
BATTERY_IN15: C76.1, JP197.2, JP200.2, R256.2, U31.6, U31.8
BATTERY_IN16: C81.1, JP210.2, JP213.2, R273.2, U33.6, U33.8
BATTERY_IN17: C86.1, JP223.2, JP226.2, R290.2, U35.6, U35.8
BATTERY_IN18: C91.1, JP236.2, JP239.2, R307.2, U37.6, U37.8
BATTERY_IN19: C96.1, JP249.2, JP252.2, R324.2, U39.6, U39.8
BATTERY_IN20: C101.1, JP262.2, JP265.2, R341.2, U41.6, U41.8
BATTERY_IN21: C106.1, JP275.2, JP278.2, R358.2, U43.6, U43.8
BATTERY_IN22: C111.1, JP288.2, JP291.2, R375.2, U45.6, U45.8
BATTERY_IN23: C116.1, JP301.2, JP304.2, R392.2, U47.6, U47.8
BATTERY_IN24: C121.1, JP314.2, JP317.2, R409.2, U49.6, U49.8
BATTERY_IN25: C126.1, JP327.2, JP330.2, R426.2, U51.6, U51.8
BATTERY_IN26: C131.1, JP340.2, JP343.2, R443.2, U53.6, U53.8
BATTERY_IN27: C136.1, JP353.2, JP356.2, R460.2, U55.6, U55.8
D+: JP1.D+1, TP2.P$1
D+1: JP14.D+1, TP4.P$1
D+2: JP27.D+1, TP6.P$1
D+3: JP40.D+1, TP8.P$1
D+4: JP53.D+1, TP10.P$1
D+5: JP66.D+1, TP12.P$1
D+6: JP79.D+1, TP14.P$1
D+7: JP92.D+1, TP16.P$1
D+8: JP105.D+1, TP18.P$1
D+9: JP118.D+1, TP20.P$1
D+10: JP131.D+1, TP22.P$1
D+11: JP144.D+1, TP24.P$1
D+12: JP157.D+1, TP26.P$1
D+13: JP170.D+1, TP28.P$1
D+14: JP183.D+1, TP30.P$1
D+15: JP196.D+1, TP32.P$1
D+16: JP209.D+1, TP34.P$1
D+17: JP222.D+1, TP36.P$1
D+18: JP235.D+1, TP38.P$1
D+19: JP248.D+1, TP40.P$1
D+20: JP261.D+1, TP42.P$1
D+21: JP274.D+1, TP44.P$1
D+22: JP287.D+1, TP46.P$1
D+23: JP300.D+1, TP48.P$1
D+24: JP313.D+1, TP50.P$1
D+25: JP326.D+1, TP52.P$1
D+26: JP339.D+1, TP54.P$1
D+27: JP352.D+1, TP56.P$1
D-: JP1.D-1, TP1.P$1
D-1: JP14.D-1, TP3.P$1
D-2: JP27.D-1, TP5.P$1
D-3: JP40.D-1, TP7.P$1
D-4: JP53.D-1, TP9.P$1
D-5: JP66.D-1, TP11.P$1
D-6: JP79.D-1, TP13.P$1
D-7: JP92.D-1, TP15.P$1
D-8: JP105.D-1, TP17.P$1
D-9: JP118.D-1, TP19.P$1
D-10: JP131.D-1, TP21.P$1
D-11: JP144.D-1, TP23.P$1
D-12: JP157.D-1, TP25.P$1
D-13: JP170.D-1, TP27.P$1
D-14: JP183.D-1, TP29.P$1
D-15: JP196.D-1, TP31.P$1
D-16: JP209.D-1, TP33.P$1
D-17: JP222.D-1, TP35.P$1
D-18: JP235.D-1, TP37.P$1
D-19: JP248.D-1, TP39.P$1
D-20: JP261.D-1, TP41.P$1
D-21: JP274.D-1, TP43.P$1
D-22: JP287.D-1, TP45.P$1
D-23: JP300.D-1, TP47.P$1
D-24: JP313.D-1, TP49.P$1
D-25: JP326.D-1, TP51.P$1
D-26: JP339.D-1, TP53.P$1
D-27: JP352.D-1, TP55.P$1
EN1: R16.2, S2.4, U1.6
EN2: R17.2, S2.3, U1.5
EN3: R27.2, S4.3, U4.5
EN4: R26.2, S4.4, U4.6
EN5: R44.2, S6.3, U6.5
EN6: R43.2, S6.4, U6.6
EN7: R61.2, S8.3, U8.5
EN8: R60.2, S8.4, U8.6
EN9: R78.2, S10.3, U10.5
EN10: R77.2, S10.4, U10.6
EN11: R95.2, S12.3, U12.5
EN12: R94.2, S12.4, U12.6
EN13: R112.2, S14.3, U14.5
EN14: R111.2, S14.4, U14.6
EN15: R129.2, S16.3, U16.5
EN16: R128.2, S16.4, U16.6
EN17: R146.2, S18.3, U18.5
EN18: R145.2, S18.4, U18.6
EN19: R163.2, S20.3, U20.5
EN20: R162.2, S20.4, U20.6
EN21: R180.2, S22.3, U22.5
EN22: R179.2, S22.4, U22.6
EN23: R197.2, S24.3, U24.5
EN24: R196.2, S24.4, U24.6
EN25: R214.2, S26.3, U26.5
EN26: R213.2, S26.4, U26.6
EN27: R231.2, S28.3, U28.5
EN28: R230.2, S28.4, U28.6
EN29: R248.2, S30.3, U30.5
EN30: R247.2, S30.4, U30.6
EN31: R265.2, S32.3, U32.5
EN32: R264.2, S32.4, U32.6
EN33: R282.2, S34.3, U34.5
EN34: R281.2, S34.4, U34.6
EN35: R299.2, S36.3, U36.5
EN36: R298.2, S36.4, U36.6
EN37: R316.2, S38.3, U38.5
EN38: R315.2, S38.4, U38.6
EN39: R333.2, S40.3, U40.5
EN40: R332.2, S40.4, U40.6
EN41: R350.2, S42.3, U42.5
EN42: R349.2, S42.4, U42.6
EN43: R367.2, S44.3, U44.5
EN44: R366.2, S44.4, U44.6
EN45: R384.2, S46.3, U46.5
EN46: R383.2, S46.4, U46.6
EN47: R401.2, S48.3, U48.5
EN48: R400.2, S48.4, U48.6
EN49: R418.2, S50.3, U50.5
EN50: R417.2, S50.4, U50.6
EN51: R435.2, S52.3, U52.5
EN52: R434.2, S52.4, U52.6
EN53: R452.2, S54.3, U54.5
EN54: R451.2, S54.4, U54.6
EN55: R469.2, S56.3, U56.5
EN56: R468.2, S56.4, U56.6
GND: C1.2, C2.2, C3.2, C4.2, C5.2, JP1.GND1, JP2.2, JP3.2, JP4.2, JP5.1, JP6.1, JP7.2, JP8.1, JP9.1, JP10.1, R1.1, R3.1, R4.1, R5.2, R6.1, R7.2, R8.2, S1.3, S2.1, S2.2, SJ1.1, SJ2.1, SJ5.3, U1.8, U1.EP, U2.3, U2.EP, U2.EP1, U2.EP2, U2.EP3, U2.EP4
GND1: C6.2, C7.2, C8.2, C9.2, C10.2, JP14.GND1, JP15.1, JP16.1, JP18.1, JP19.2, JP20.2, JP21.1, JP22.1, JP23.2, JP26.2, R21.2, R22.2, R25.2, R28.1, R29.1, R31.1, R33.1, S3.3, S4.1, S4.2, SJ6.1, SJ9.1, SJ10.3, U3.3, U3.EP, U3.EP1, U3.EP2, U3.EP3, U3.EP4, U4.8, U4.EP
GND2: C11.2, C12.2, C13.2, C14.2, C15.2, JP27.GND1, JP28.1, JP29.1, JP31.1, JP32.2, JP33.2, JP34.1, JP35.1, JP36.2, JP39.2, R38.2, R39.2, R42.2, R45.1, R46.1, R48.1, R50.1, S5.3, S6.1, S6.2, SJ11.1, SJ14.1, SJ15.3, U5.3, U5.EP, U5.EP1, U5.EP2, U5.EP3, U5.EP4, U6.8, U6.EP
GND3: C16.2, C17.2, C18.2, C19.2, C20.2, JP40.GND1, JP41.1, JP42.1, JP44.1, JP45.2, JP46.2, JP47.1, JP48.1, JP49.2, JP52.2, R55.2, R56.2, R59.2, R62.1, R63.1, R65.1, R67.1, S7.3, S8.1, S8.2, SJ16.1, SJ19.1, SJ20.3, U7.3, U7.EP, U7.EP1, U7.EP2, U7.EP3, U7.EP4, U8.8, U8.EP
GND4: C21.2, C22.2, C23.2, C24.2, C25.2, JP53.GND1, JP54.1, JP55.1, JP57.1, JP58.2, JP59.2, JP60.1, JP61.1, JP62.2, JP65.2, R72.2, R73.2, R76.2, R79.1, R80.1, R82.1, R84.1, S9.3, S10.1, S10.2, SJ21.1, SJ24.1, SJ25.3, U9.3, U9.EP, U9.EP1, U9.EP2, U9.EP3, U9.EP4, U10.8, U10.EP
GND5: C26.2, C27.2, C28.2, C29.2, C30.2, JP66.GND1, JP67.1, JP68.1, JP70.1, JP71.2, JP72.2, JP73.1, JP74.1, JP75.2, JP78.2, R89.2, R90.2, R93.2, R96.1, R97.1, R99.1, R101.1, S11.3, S12.1, S12.2, SJ26.1, SJ29.1, SJ30.3, U11.3, U11.EP, U11.EP1, U11.EP2, U11.EP3, U11.EP4, U12.8, U12.EP
GND6: C31.2, C32.2, C33.2, C34.2, C35.2, JP79.GND1, JP80.1, JP81.1, JP83.1, JP84.2, JP85.2, JP86.1, JP87.1, JP88.2, JP91.2, R106.2, R107.2, R110.2, R113.1, R114.1, R116.1, R118.1, S13.3, S14.1, S14.2, SJ31.1, SJ34.1, SJ35.3, U13.3, U13.EP, U13.EP1, U13.EP2, U13.EP3, U13.EP4, U14.8, U14.EP
GND7: C36.2, C37.2, C38.2, C39.2, C40.2, JP92.GND1, JP93.1, JP94.1, JP96.1, JP97.2, JP98.2, JP99.1, JP100.1, JP101.2, JP104.2, R123.2, R124.2, R127.2, R130.1, R131.1, R133.1, R135.1, S15.3, S16.1, S16.2, SJ36.1, SJ39.1, SJ40.3, U15.3, U15.EP, U15.EP1, U15.EP2, U15.EP3, U15.EP4, U16.8, U16.EP
GND8: C41.2, C42.2, C43.2, C44.2, C45.2, JP105.GND1, JP106.1, JP107.1, JP109.1, JP110.2, JP111.2, JP112.1, JP113.1, JP114.2, JP117.2, R140.2, R141.2, R144.2, R147.1, R148.1, R150.1, R152.1, S17.3, S18.1, S18.2, SJ41.1, SJ44.1, SJ45.3, U17.3, U17.EP, U17.EP1, U17.EP2, U17.EP3, U17.EP4, U18.8, U18.EP
GND9: C46.2, C47.2, C48.2, C49.2, C50.2, JP118.GND1, JP119.1, JP120.1, JP122.1, JP123.2, JP124.2, JP125.1, JP126.1, JP127.2, JP130.2, R157.2, R158.2, R161.2, R164.1, R165.1, R167.1, R169.1, S19.3, S20.1, S20.2, SJ46.1, SJ49.1, SJ50.3, U19.3, U19.EP, U19.EP1, U19.EP2, U19.EP3, U19.EP4, U20.8, U20.EP
GND10: C51.2, C52.2, C53.2, C54.2, C55.2, JP131.GND1, JP132.1, JP133.1, JP135.1, JP136.2, JP137.2, JP138.1, JP139.1, JP140.2, JP143.2, R174.2, R175.2, R178.2, R181.1, R182.1, R184.1, R186.1, S21.3, S22.1, S22.2, SJ51.1, SJ54.1, SJ55.3, U21.3, U21.EP, U21.EP1, U21.EP2, U21.EP3, U21.EP4, U22.8, U22.EP
GND11: C56.2, C57.2, C58.2, C59.2, C60.2, JP144.GND1, JP145.1, JP146.1, JP148.1, JP149.2, JP150.2, JP151.1, JP152.1, JP153.2, JP156.2, R191.2, R192.2, R195.2, R198.1, R199.1, R201.1, R203.1, S23.3, S24.1, S24.2, SJ56.1, SJ59.1, SJ60.3, U23.3, U23.EP, U23.EP1, U23.EP2, U23.EP3, U23.EP4, U24.8, U24.EP
GND12: C61.2, C62.2, C63.2, C64.2, C65.2, JP157.GND1, JP158.1, JP159.1, JP161.1, JP162.2, JP163.2, JP164.1, JP165.1, JP166.2, JP169.2, R208.2, R209.2, R212.2, R215.1, R216.1, R218.1, R220.1, S25.3, S26.1, S26.2, SJ61.1, SJ64.1, SJ65.3, U25.3, U25.EP, U25.EP1, U25.EP2, U25.EP3, U25.EP4, U26.8, U26.EP
GND13: C66.2, C67.2, C68.2, C69.2, C70.2, JP170.GND1, JP171.1, JP172.1, JP174.1, JP175.2, JP176.2, JP177.1, JP178.1, JP179.2, JP182.2, R225.2, R226.2, R229.2, R232.1, R233.1, R235.1, R237.1, S27.3, S28.1, S28.2, SJ66.1, SJ69.1, SJ70.3, U27.3, U27.EP, U27.EP1, U27.EP2, U27.EP3, U27.EP4, U28.8, U28.EP
GND14: C71.2, C72.2, C73.2, C74.2, C75.2, JP183.GND1, JP184.1, JP185.1, JP187.1, JP188.2, JP189.2, JP190.1, JP191.1, JP192.2, JP195.2, R242.2, R243.2, R246.2, R249.1, R250.1, R252.1, R254.1, S29.3, S30.1, S30.2, SJ71.1, SJ74.1, SJ75.3, U29.3, U29.EP, U29.EP1, U29.EP2, U29.EP3, U29.EP4, U30.8, U30.EP
GND15: C76.2, C77.2, C78.2, C79.2, C80.2, JP196.GND1, JP197.1, JP198.1, JP200.1, JP201.2, JP202.2, JP203.1, JP204.1, JP205.2, JP208.2, R259.2, R260.2, R263.2, R266.1, R267.1, R269.1, R271.1, S31.3, S32.1, S32.2, SJ76.1, SJ79.1, SJ80.3, U31.3, U31.EP, U31.EP1, U31.EP2, U31.EP3, U31.EP4, U32.8, U32.EP
GND16: C81.2, C82.2, C83.2, C84.2, C85.2, JP209.GND1, JP210.1, JP211.1, JP213.1, JP214.2, JP215.2, JP216.1, JP217.1, JP218.2, JP221.2, R276.2, R277.2, R280.2, R283.1, R284.1, R286.1, R288.1, S33.3, S34.1, S34.2, SJ81.1, SJ84.1, SJ85.3, U33.3, U33.EP, U33.EP1, U33.EP2, U33.EP3, U33.EP4, U34.8, U34.EP
GND17: C86.2, C87.2, C88.2, C89.2, C90.2, JP222.GND1, JP223.1, JP224.1, JP226.1, JP227.2, JP228.2, JP229.1, JP230.1, JP231.2, JP234.2, R293.2, R294.2, R297.2, R300.1, R301.1, R303.1, R305.1, S35.3, S36.1, S36.2, SJ86.1, SJ89.1, SJ90.3, U35.3, U35.EP, U35.EP1, U35.EP2, U35.EP3, U35.EP4, U36.8, U36.EP
GND18: C91.2, C92.2, C93.2, C94.2, C95.2, JP235.GND1, JP236.1, JP237.1, JP239.1, JP240.2, JP241.2, JP242.1, JP243.1, JP244.2, JP247.2, R310.2, R311.2, R314.2, R317.1, R318.1, R320.1, R322.1, S37.3, S38.1, S38.2, SJ91.1, SJ94.1, SJ95.3, U37.3, U37.EP, U37.EP1, U37.EP2, U37.EP3, U37.EP4, U38.8, U38.EP
GND19: C96.2, C97.2, C98.2, C99.2, C100.2, JP248.GND1, JP249.1, JP250.1, JP252.1, JP253.2, JP254.2, JP255.1, JP256.1, JP257.2, JP260.2, R327.2, R328.2, R331.2, R334.1, R335.1, R337.1, R339.1, S39.3, S40.1, S40.2, SJ96.1, SJ99.1, SJ100.3, U39.3, U39.EP, U39.EP1, U39.EP2, U39.EP3, U39.EP4, U40.8, U40.EP
GND20: C101.2, C102.2, C103.2, C104.2, C105.2, JP261.GND1, JP262.1, JP263.1, JP265.1, JP266.2, JP267.2, JP268.1, JP269.1, JP270.2, JP273.2, R344.2, R345.2, R348.2, R351.1, R352.1, R354.1, R356.1, S41.3, S42.1, S42.2, SJ101.1, SJ104.1, SJ105.3, U41.3, U41.EP, U41.EP1, U41.EP2, U41.EP3, U41.EP4, U42.8, U42.EP
GND21: C106.2, C107.2, C108.2, C109.2, C110.2, JP274.GND1, JP275.1, JP276.1, JP278.1, JP279.2, JP280.2, JP281.1, JP282.1, JP283.2, JP286.2, R361.2, R362.2, R365.2, R368.1, R369.1, R371.1, R373.1, S43.3, S44.1, S44.2, SJ106.1, SJ109.1, SJ110.3, U43.3, U43.EP, U43.EP1, U43.EP2, U43.EP3, U43.EP4, U44.8, U44.EP
GND22: C111.2, C112.2, C113.2, C114.2, C115.2, JP287.GND1, JP288.1, JP289.1, JP291.1, JP292.2, JP293.2, JP294.1, JP295.1, JP296.2, JP299.2, R378.2, R379.2, R382.2, R385.1, R386.1, R388.1, R390.1, S45.3, S46.1, S46.2, SJ111.1, SJ114.1, SJ115.3, U45.3, U45.EP, U45.EP1, U45.EP2, U45.EP3, U45.EP4, U46.8, U46.EP
GND23: C116.2, C117.2, C118.2, C119.2, C120.2, JP300.GND1, JP301.1, JP302.1, JP304.1, JP305.2, JP306.2, JP307.1, JP308.1, JP309.2, JP312.2, R395.2, R396.2, R399.2, R402.1, R403.1, R405.1, R407.1, S47.3, S48.1, S48.2, SJ116.1, SJ119.1, SJ120.3, U47.3, U47.EP, U47.EP1, U47.EP2, U47.EP3, U47.EP4, U48.8, U48.EP
GND24: C121.2, C122.2, C123.2, C124.2, C125.2, JP313.GND1, JP314.1, JP315.1, JP317.1, JP318.2, JP319.2, JP320.1, JP321.1, JP322.2, JP325.2, R412.2, R413.2, R416.2, R419.1, R420.1, R422.1, R424.1, S49.3, S50.1, S50.2, SJ121.1, SJ124.1, SJ125.3, U49.3, U49.EP, U49.EP1, U49.EP2, U49.EP3, U49.EP4, U50.8, U50.EP
GND25: C126.2, C127.2, C128.2, C129.2, C130.2, JP326.GND1, JP327.1, JP328.1, JP330.1, JP331.2, JP332.2, JP333.1, JP334.1, JP335.2, JP338.2, R429.2, R430.2, R433.2, R436.1, R437.1, R439.1, R441.1, S51.3, S52.1, S52.2, SJ126.1, SJ129.1, SJ130.3, U51.3, U51.EP, U51.EP1, U51.EP2, U51.EP3, U51.EP4, U52.8, U52.EP
GND26: C131.2, C132.2, C133.2, C134.2, C135.2, JP339.GND1, JP340.1, JP341.1, JP343.1, JP344.2, JP345.2, JP346.1, JP347.1, JP348.2, JP351.2, R446.2, R447.2, R450.2, R453.1, R454.1, R456.1, R458.1, S53.3, S54.1, S54.2, SJ131.1, SJ134.1, SJ135.3, U53.3, U53.EP, U53.EP1, U53.EP2, U53.EP3, U53.EP4, U54.8, U54.EP
GND27: C136.2, C137.2, C138.2, C139.2, C140.2, JP352.GND1, JP353.1, JP354.1, JP356.1, JP357.2, JP358.2, JP359.1, JP360.1, JP361.2, JP364.2, R463.2, R464.2, R467.2, R470.1, R471.1, R473.1, R475.1, S55.3, S56.1, S56.2, SJ136.1, SJ139.1, SJ140.3, U55.3, U55.EP, U55.EP1, U55.EP2, U55.EP3, U55.EP4, U56.8, U56.EP
GPOUT: JP11.2, R15.1, U2.12
GPOUT1: JP24.2, R34.1, U3.12
GPOUT2: JP37.2, R51.1, U5.12
GPOUT3: JP50.2, R68.1, U7.12
GPOUT4: JP63.2, R85.1, U9.12
GPOUT5: JP76.2, R102.1, U11.12
GPOUT6: JP89.2, R119.1, U13.12
GPOUT7: JP102.2, R136.1, U15.12
GPOUT8: JP115.2, R153.1, U17.12
GPOUT9: JP128.2, R170.1, U19.12
GPOUT10: JP141.2, R187.1, U21.12
GPOUT11: JP154.2, R204.1, U23.12
GPOUT12: JP167.2, R221.1, U25.12
GPOUT13: JP180.2, R238.1, U27.12
GPOUT14: JP193.2, R255.1, U29.12
GPOUT15: JP206.2, R272.1, U31.12
GPOUT16: JP219.2, R289.1, U33.12
GPOUT17: JP232.2, R306.1, U35.12
GPOUT18: JP245.2, R323.1, U37.12
GPOUT19: JP258.2, R340.1, U39.12
GPOUT20: JP271.2, R357.1, U41.12
GPOUT21: JP284.2, R374.1, U43.12
GPOUT22: JP297.2, R391.1, U45.12
GPOUT23: JP310.2, R408.1, U47.12
GPOUT24: JP323.2, R425.1, U49.12
GPOUT25: JP336.2, R442.1, U51.12
GPOUT26: JP349.2, R459.1, U53.12
GPOUT27: JP362.2, R476.1, U55.12
ILIM: R6.2, SJ4.2, U1.12
ILIM1: R28.2, SJ7.2, U4.12
ILIM2: R45.2, SJ12.2, U6.12
ILIM3: R62.2, SJ17.2, U8.12
ILIM4: R79.2, SJ22.2, U10.12
ILIM5: R96.2, SJ27.2, U12.12
ILIM6: R113.2, SJ32.2, U14.12
ILIM7: R130.2, SJ37.2, U16.12
ILIM8: R147.2, SJ42.2, U18.12
ILIM9: R164.2, SJ47.2, U20.12
ILIM10: R181.2, SJ52.2, U22.12
ILIM11: R198.2, SJ57.2, U24.12
ILIM12: R215.2, SJ62.2, U26.12
ILIM13: R232.2, SJ67.2, U28.12
ILIM14: R249.2, SJ72.2, U30.12
ILIM15: R266.2, SJ77.2, U32.12
ILIM16: R283.2, SJ82.2, U34.12
ILIM17: R300.2, SJ87.2, U36.12
ILIM18: R317.2, SJ92.2, U38.12
ILIM19: R334.2, SJ97.2, U40.12
ILIM20: R351.2, SJ102.2, U42.12
ILIM21: R368.2, SJ107.2, U44.12
ILIM22: R385.2, SJ112.2, U46.12
ILIM23: R402.2, SJ117.2, U48.12
ILIM24: R419.2, SJ122.2, U50.12
ILIM25: R436.2, SJ127.2, U52.12
ILIM26: R453.2, SJ132.2, U54.12
ILIM27: R470.2, SJ137.2, U56.12
ISET: R4.2, SJ3.2, U1.16
ISET1: R29.2, SJ8.2, U4.16
ISET2: R46.2, SJ13.2, U6.16
ISET3: R63.2, SJ18.2, U8.16
ISET4: R80.2, SJ23.2, U10.16
ISET5: R97.2, SJ28.2, U12.16
ISET6: R114.2, SJ33.2, U14.16
ISET7: R131.2, SJ38.2, U16.16
ISET8: R148.2, SJ43.2, U18.16
ISET9: R165.2, SJ48.2, U20.16
ISET10: R182.2, SJ53.2, U22.16
ISET11: R199.2, SJ58.2, U24.16
ISET12: R216.2, SJ63.2, U26.16
ISET13: R233.2, SJ68.2, U28.16
ISET14: R250.2, SJ73.2, U30.16
ISET15: R267.2, SJ78.2, U32.16
ISET16: R284.2, SJ83.2, U34.16
ISET17: R301.2, SJ88.2, U36.16
ISET18: R318.2, SJ93.2, U38.16
ISET19: R335.2, SJ98.2, U40.16
ISET20: R352.2, SJ103.2, U42.16
ISET21: R369.2, SJ108.2, U44.16
ISET22: R386.2, SJ113.2, U46.16
ISET23: R403.2, SJ118.2, U48.16
ISET24: R420.2, SJ123.2, U50.16
ISET25: R437.2, SJ128.2, U52.16
ISET26: R454.2, SJ133.2, U54.16
ISET27: R471.2, SJ138.2, U56.16
unnamed: R2.1, SJ1.2
unnamed: R7.1, SJ4.1
unnamed: R5.1, SJ3.1
unnamed: R12.2, S1.1
unnamed: R10.2, SJ5.2
unnamed: D3.C, R23.1
unnamed: D4.C, R24.1
unnamed: R32.2, S3.1
unnamed: R30.1, SJ6.2
unnamed: R22.1, SJ7.1
unnamed: D1.C, R9.1
unnamed: D2.C, R10.1
unnamed: R21.1, SJ8.1
unnamed: R24.2, SJ10.2
unnamed: D5.C, R40.1
unnamed: D6.C, R41.1
unnamed: R49.2, S5.1
unnamed: R47.1, SJ11.2
unnamed: R39.1, SJ12.1
unnamed: R38.1, SJ13.1
unnamed: R41.2, SJ15.2
unnamed: D7.C, R57.1
unnamed: D8.C, R58.1
unnamed: R66.2, S7.1
unnamed: R64.1, SJ16.2
unnamed: R56.1, SJ17.1
unnamed: R55.1, SJ18.1
unnamed: R58.2, SJ20.2
unnamed: D9.C, R74.1
unnamed: D10.C, R75.1
unnamed: R83.2, S9.1
unnamed: R81.1, SJ21.2
unnamed: R73.1, SJ22.1
unnamed: R72.1, SJ23.1
unnamed: R75.2, SJ25.2
unnamed: D11.C, R91.1
unnamed: D12.C, R92.1
unnamed: R100.2, S11.1
unnamed: R98.1, SJ26.2
unnamed: R90.1, SJ27.1
unnamed: R89.1, SJ28.1
unnamed: R92.2, SJ30.2
unnamed: D13.C, R108.1
unnamed: D14.C, R109.1
unnamed: R117.2, S13.1
unnamed: R115.1, SJ31.2
unnamed: R107.1, SJ32.1
unnamed: R106.1, SJ33.1
unnamed: R109.2, SJ35.2
unnamed: D15.C, R125.1
unnamed: D16.C, R126.1
unnamed: R134.2, S15.1
unnamed: R132.1, SJ36.2
unnamed: R124.1, SJ37.1
unnamed: R123.1, SJ38.1
unnamed: R126.2, SJ40.2
unnamed: D17.C, R142.1
unnamed: D18.C, R143.1
unnamed: R151.2, S17.1
unnamed: R149.1, SJ41.2
unnamed: R141.1, SJ42.1
unnamed: R140.1, SJ43.1
unnamed: R143.2, SJ45.2
unnamed: D19.C, R159.1
unnamed: D20.C, R160.1
unnamed: R168.2, S19.1
unnamed: R166.1, SJ46.2
unnamed: R158.1, SJ47.1
unnamed: R157.1, SJ48.1
unnamed: R160.2, SJ50.2
unnamed: D21.C, R176.1
unnamed: D22.C, R177.1
unnamed: R185.2, S21.1
unnamed: R183.1, SJ51.2
unnamed: R175.1, SJ52.1
unnamed: R174.1, SJ53.1
unnamed: R177.2, SJ55.2
unnamed: D23.C, R193.1
unnamed: D24.C, R194.1
unnamed: R202.2, S23.1
unnamed: R200.1, SJ56.2
unnamed: R192.1, SJ57.1
unnamed: R191.1, SJ58.1
unnamed: R194.2, SJ60.2
unnamed: D25.C, R210.1
unnamed: D26.C, R211.1
unnamed: R219.2, S25.1
unnamed: R217.1, SJ61.2
unnamed: R209.1, SJ62.1
unnamed: R208.1, SJ63.1
unnamed: R211.2, SJ65.2
unnamed: D27.C, R227.1
unnamed: D28.C, R228.1
unnamed: R236.2, S27.1
unnamed: R234.1, SJ66.2
unnamed: R226.1, SJ67.1
unnamed: R225.1, SJ68.1
unnamed: R228.2, SJ70.2
unnamed: D29.C, R244.1
unnamed: D30.C, R245.1
unnamed: R253.2, S29.1
unnamed: R251.1, SJ71.2
unnamed: R243.1, SJ72.1
unnamed: R242.1, SJ73.1
unnamed: R245.2, SJ75.2
unnamed: D31.C, R261.1
unnamed: D32.C, R262.1
unnamed: R270.2, S31.1
unnamed: R268.1, SJ76.2
unnamed: R260.1, SJ77.1
unnamed: R259.1, SJ78.1
unnamed: R262.2, SJ80.2
unnamed: D33.C, R278.1
unnamed: D34.C, R279.1
unnamed: R287.2, S33.1
unnamed: R285.1, SJ81.2
unnamed: R277.1, SJ82.1
unnamed: R276.1, SJ83.1
unnamed: R279.2, SJ85.2
unnamed: D35.C, R295.1
unnamed: D36.C, R296.1
unnamed: R304.2, S35.1
unnamed: R302.1, SJ86.2
unnamed: R294.1, SJ87.1
unnamed: R293.1, SJ88.1
unnamed: R296.2, SJ90.2
unnamed: D37.C, R312.1
unnamed: D38.C, R313.1
unnamed: R321.2, S37.1
unnamed: R319.1, SJ91.2
unnamed: R311.1, SJ92.1
unnamed: R310.1, SJ93.1
unnamed: R313.2, SJ95.2
unnamed: D39.C, R329.1
unnamed: D40.C, R330.1
unnamed: R338.2, S39.1
unnamed: R336.1, SJ96.2
unnamed: R328.1, SJ97.1
unnamed: R327.1, SJ98.1
unnamed: R330.2, SJ100.2
unnamed: D41.C, R346.1
unnamed: D42.C, R347.1
unnamed: R355.2, S41.1
unnamed: R353.1, SJ101.2
unnamed: R345.1, SJ102.1
unnamed: R344.1, SJ103.1
unnamed: R347.2, SJ105.2
unnamed: D43.C, R363.1
unnamed: D44.C, R364.1
unnamed: R372.2, S43.1
unnamed: R370.1, SJ106.2
unnamed: R362.1, SJ107.1
unnamed: R361.1, SJ108.1
unnamed: R364.2, SJ110.2
unnamed: D45.C, R380.1
unnamed: D46.C, R381.1
unnamed: R389.2, S45.1
unnamed: R387.1, SJ111.2
unnamed: R379.1, SJ112.1
unnamed: R378.1, SJ113.1
unnamed: R381.2, SJ115.2
unnamed: D47.C, R397.1
unnamed: D48.C, R398.1
unnamed: R406.2, S47.1
unnamed: R404.1, SJ116.2
unnamed: R396.1, SJ117.1
unnamed: R395.1, SJ118.1
unnamed: R398.2, SJ120.2
unnamed: D49.C, R414.1
unnamed: D50.C, R415.1
unnamed: R423.2, S49.1
unnamed: R421.1, SJ121.2
unnamed: R413.1, SJ122.1
unnamed: R412.1, SJ123.1
unnamed: R415.2, SJ125.2
unnamed: D51.C, R431.1
unnamed: D52.C, R432.1
unnamed: R440.2, S51.1
unnamed: R438.1, SJ126.2
unnamed: R430.1, SJ127.1
unnamed: R429.1, SJ128.1
unnamed: R432.2, SJ130.2
unnamed: D53.C, R448.1
unnamed: D54.C, R449.1
unnamed: R457.2, S53.1
unnamed: R455.1, SJ131.2
unnamed: R447.1, SJ132.1
unnamed: R446.1, SJ133.1
unnamed: R449.2, SJ135.2
unnamed: D55.C, R465.1
unnamed: D56.C, R466.1
unnamed: R474.2, S55.1
unnamed: R472.1, SJ136.2
unnamed: R464.1, SJ137.1
unnamed: R463.1, SJ138.1
unnamed: R466.2, SJ140.2
OUT: C3.1, D1.A, D2.A, JP7.1, JP8.2, JP9.2, R16.1, R17.1, U1.10, U1.11
OUT1: C8.1, D3.A, D4.A, JP20.1, JP21.2, JP22.2, R26.1, R27.1, U4.10, U4.11
OUT2: C13.1, D5.A, D6.A, JP33.1, JP34.2, JP35.2, R43.1, R44.1, U6.10, U6.11
OUT3: C18.1, D7.A, D8.A, JP46.1, JP47.2, JP48.2, R60.1, R61.1, U8.10, U8.11
OUT4: C23.1, D9.A, D10.A, JP59.1, JP60.2, JP61.2, R77.1, R78.1, U10.10, U10.11
OUT5: C28.1, D11.A, D12.A, JP72.1, JP73.2, JP74.2, R94.1, R95.1, U12.10, U12.11
OUT6: C33.1, D13.A, D14.A, JP85.1, JP86.2, JP87.2, R111.1, R112.1, U14.10, U14.11
OUT7: C38.1, D15.A, D16.A, JP98.1, JP99.2, JP100.2, R128.1, R129.1, U16.10, U16.11
OUT8: C43.1, D17.A, D18.A, JP111.1, JP112.2, JP113.2, R145.1, R146.1, U18.10, U18.11
OUT9: C48.1, D19.A, D20.A, JP124.1, JP125.2, JP126.2, R162.1, R163.1, U20.10, U20.11
OUT10: C53.1, D21.A, D22.A, JP137.1, JP138.2, JP139.2, R179.1, R180.1, U22.10, U22.11
OUT11: C58.1, D23.A, D24.A, JP150.1, JP151.2, JP152.2, R196.1, R197.1, U24.10, U24.11
OUT12: C63.1, D25.A, D26.A, JP163.1, JP164.2, JP165.2, R213.1, R214.1, U26.10, U26.11
OUT13: C68.1, D27.A, D28.A, JP176.1, JP177.2, JP178.2, R230.1, R231.1, U28.10, U28.11
OUT14: C73.1, D29.A, D30.A, JP189.1, JP190.2, JP191.2, R247.1, R248.1, U30.10, U30.11
OUT15: C78.1, D31.A, D32.A, JP202.1, JP203.2, JP204.2, R264.1, R265.1, U32.10, U32.11
OUT16: C83.1, D33.A, D34.A, JP215.1, JP216.2, JP217.2, R281.1, R282.1, U34.10, U34.11
OUT17: C88.1, D35.A, D36.A, JP228.1, JP229.2, JP230.2, R298.1, R299.1, U36.10, U36.11
OUT18: C93.1, D37.A, D38.A, JP241.1, JP242.2, JP243.2, R315.1, R316.1, U38.10, U38.11
OUT19: C98.1, D39.A, D40.A, JP254.1, JP255.2, JP256.2, R332.1, R333.1, U40.10, U40.11
OUT20: C103.1, D41.A, D42.A, JP267.1, JP268.2, JP269.2, R349.1, R350.1, U42.10, U42.11
OUT21: C108.1, D43.A, D44.A, JP280.1, JP281.2, JP282.2, R366.1, R367.1, U44.10, U44.11
OUT22: C113.1, D45.A, D46.A, JP293.1, JP294.2, JP295.2, R383.1, R384.1, U46.10, U46.11
OUT23: C118.1, D47.A, D48.A, JP306.1, JP307.2, JP308.2, R400.1, R401.1, U48.10, U48.11
OUT24: C123.1, D49.A, D50.A, JP319.1, JP320.2, JP321.2, R417.1, R418.1, U50.10, U50.11
OUT25: C128.1, D51.A, D52.A, JP332.1, JP333.2, JP334.2, R434.1, R435.1, U52.10, U52.11
OUT26: C133.1, D53.A, D54.A, JP345.1, JP346.2, JP347.2, R451.1, R452.1, U54.10, U54.11
OUT27: C138.1, D55.A, D56.A, JP358.1, JP359.2, JP360.2, R468.1, R469.1, U56.10, U56.11
SCL: JP10.4, R14.1, U2.2
SCL1: JP16.4, R20.1, U3.2
SCL2: JP29.4, R37.1, U5.2
SCL3: JP42.4, R54.1, U7.2
SCL4: JP55.4, R71.1, U9.2
SCL5: JP68.4, R88.1, U11.2
SCL6: JP81.4, R105.1, U13.2
SCL7: JP94.4, R122.1, U15.2
SCL8: JP107.4, R139.1, U17.2
SCL9: JP120.4, R156.1, U19.2
SCL10: JP133.4, R173.1, U21.2
SCL11: JP146.4, R190.1, U23.2
SCL12: JP159.4, R207.1, U25.2
SCL13: JP172.4, R224.1, U27.2
SCL14: JP185.4, R241.1, U29.2
SCL15: JP198.4, R258.1, U31.2
SCL16: JP211.4, R275.1, U33.2
SCL17: JP224.4, R292.1, U35.2
SCL18: JP237.4, R309.1, U37.2
SCL19: JP250.4, R326.1, U39.2
SCL20: JP263.4, R343.1, U41.2
SCL21: JP276.4, R360.1, U43.2
SCL22: JP289.4, R377.1, U45.2
SCL23: JP302.4, R394.1, U47.2
SCL24: JP315.4, R411.1, U49.2
SCL25: JP328.4, R428.1, U51.2
SCL26: JP341.4, R445.1, U53.2
SCL27: JP354.4, R462.1, U55.2
SDA: JP10.3, R13.1, U2.1
SDA1: JP16.3, R19.1, U3.1
SDA2: JP29.3, R36.1, U5.1
SDA3: JP42.3, R53.1, U7.1
SDA4: JP55.3, R70.1, U9.1
SDA5: JP68.3, R87.1, U11.1
SDA6: JP81.3, R104.1, U13.1
SDA7: JP94.3, R121.1, U15.1
SDA8: JP107.3, R138.1, U17.1
SDA9: JP120.3, R155.1, U19.1
SDA10: JP133.3, R172.1, U21.1
SDA11: JP146.3, R189.1, U23.1
SDA12: JP159.3, R206.1, U25.1
SDA13: JP172.3, R223.1, U27.1
SDA14: JP185.3, R240.1, U29.1
SDA15: JP198.3, R257.1, U31.1
SDA16: JP211.3, R274.1, U33.1
SDA17: JP224.3, R291.1, U35.1
SDA18: JP237.3, R308.1, U37.1
SDA19: JP250.3, R325.1, U39.1
SDA20: JP263.3, R342.1, U41.1
SDA21: JP276.3, R359.1, U43.1
SDA22: JP289.3, R376.1, U45.1
SDA23: JP302.3, R393.1, U47.1
SDA24: JP315.3, R410.1, U49.1
SDA25: JP328.3, R427.1, U51.1
SDA26: JP341.3, R444.1, U53.1
SDA27: JP354.3, R461.1, U55.1
SHIELD: JP1.SHIELD1, JP1.SHIELD2, JP1.SHIELD3
SHIELD1: JP14.SHIELD1, JP14.SHIELD2, JP14.SHIELD3
SHIELD2: JP27.SHIELD1, JP27.SHIELD2, JP27.SHIELD3
SHIELD3: JP40.SHIELD1, JP40.SHIELD2, JP40.SHIELD3
SHIELD4: JP53.SHIELD1, JP53.SHIELD2, JP53.SHIELD3
SHIELD5: JP66.SHIELD1, JP66.SHIELD2, JP66.SHIELD3
SHIELD6: JP79.SHIELD1, JP79.SHIELD2, JP79.SHIELD3
SHIELD7: JP92.SHIELD1, JP92.SHIELD2, JP92.SHIELD3
SHIELD8: JP105.SHIELD1, JP105.SHIELD2, JP105.SHIELD3
SHIELD9: JP118.SHIELD1, JP118.SHIELD2, JP118.SHIELD3
SHIELD10: JP131.SHIELD1, JP131.SHIELD2, JP131.SHIELD3
SHIELD11: JP144.SHIELD1, JP144.SHIELD2, JP144.SHIELD3
SHIELD12: JP157.SHIELD1, JP157.SHIELD2, JP157.SHIELD3
SHIELD13: JP170.SHIELD1, JP170.SHIELD2, JP170.SHIELD3
SHIELD14: JP183.SHIELD1, JP183.SHIELD2, JP183.SHIELD3
SHIELD15: JP196.SHIELD1, JP196.SHIELD2, JP196.SHIELD3
SHIELD16: JP209.SHIELD1, JP209.SHIELD2, JP209.SHIELD3
SHIELD17: JP222.SHIELD1, JP222.SHIELD2, JP222.SHIELD3
SHIELD18: JP235.SHIELD1, JP235.SHIELD2, JP235.SHIELD3
SHIELD19: JP248.SHIELD1, JP248.SHIELD2, JP248.SHIELD3
SHIELD20: JP261.SHIELD1, JP261.SHIELD2, JP261.SHIELD3
SHIELD21: JP274.SHIELD1, JP274.SHIELD2, JP274.SHIELD3
SHIELD22: JP287.SHIELD1, JP287.SHIELD2, JP287.SHIELD3
SHIELD23: JP300.SHIELD1, JP300.SHIELD2, JP300.SHIELD3
SHIELD24: JP313.SHIELD1, JP313.SHIELD2, JP313.SHIELD3
SHIELD25: JP326.SHIELD1, JP326.SHIELD2, JP326.SHIELD3
SHIELD26: JP339.SHIELD1, JP339.SHIELD2, JP339.SHIELD3
SHIELD27: JP352.SHIELD1, JP352.SHIELD2, JP352.SHIELD3
SYSOFF: JP12.1, S1.2, U1.15
SYSOFF1: JP17.1, S3.2, U4.15
SYSOFF2: JP30.1, S5.2, U6.15
SYSOFF3: JP43.1, S7.2, U8.15
SYSOFF4: JP56.1, S9.2, U10.15
SYSOFF5: JP69.1, S11.2, U12.15
SYSOFF6: JP82.1, S13.2, U14.15
SYSOFF7: JP95.1, S15.2, U16.15
SYSOFF8: JP108.1, S17.2, U18.15
SYSOFF9: JP121.1, S19.2, U20.15
SYSOFF10: JP134.1, S21.2, U22.15
SYSOFF11: JP147.1, S23.2, U24.15
SYSOFF12: JP160.1, S25.2, U26.15
SYSOFF13: JP173.1, S27.2, U28.15
SYSOFF14: JP186.1, S29.2, U30.15
SYSOFF15: JP199.1, S31.2, U32.15
SYSOFF16: JP212.1, S33.2, U34.15
SYSOFF17: JP225.1, S35.2, U36.15
SYSOFF18: JP238.1, S37.2, U38.15
SYSOFF19: JP251.1, S39.2, U40.15
SYSOFF20: JP264.1, S41.2, U42.15
SYSOFF21: JP277.1, S43.2, U44.15
SYSOFF22: JP290.1, S45.2, U46.15
SYSOFF23: JP303.1, S47.2, U48.15
SYSOFF24: JP316.1, S49.2, U50.15
SYSOFF25: JP329.1, S51.2, U52.15
SYSOFF26: JP342.1, S53.2, U54.15
SYSOFF27: JP355.1, S55.2, U56.15
TMR: R3.2, SJ2.2, U1.14
TMR1: R31.2, SJ9.2, U4.14
TMR2: R48.2, SJ14.2, U6.14
TMR3: R65.2, SJ19.2, U8.14
TMR4: R82.2, SJ24.2, U10.14
TMR5: R99.2, SJ29.2, U12.14
TMR6: R116.2, SJ34.2, U14.14
TMR7: R133.2, SJ39.2, U16.14
TMR8: R150.2, SJ44.2, U18.14
TMR9: R167.2, SJ49.2, U20.14
TMR10: R184.2, SJ54.2, U22.14
TMR11: R201.2, SJ59.2, U24.14
TMR12: R218.2, SJ64.2, U26.14
TMR13: R235.2, SJ69.2, U28.14
TMR14: R252.2, SJ74.2, U30.14
TMR15: R269.2, SJ79.2, U32.14
TMR16: R286.2, SJ84.2, U34.14
TMR17: R303.2, SJ89.2, U36.14
TMR18: R320.2, SJ94.2, U38.14
TMR19: R337.2, SJ99.2, U40.14
TMR20: R354.2, SJ104.2, U42.14
TMR21: R371.2, SJ109.2, U44.14
TMR22: R388.2, SJ114.2, U46.14
TMR23: R405.2, SJ119.2, U48.14
TMR24: R422.2, SJ124.2, U50.14
TMR25: R439.2, SJ129.2, U52.14
TMR26: R456.2, SJ134.2, U54.14
TMR27: R473.2, SJ139.2, U56.14
TS: R1.2, R2.2, U1.1, U2.10
TS1: R30.2, R33.2, U3.10, U4.1
TS2: R47.2, R50.2, U5.10, U6.1
TS3: R64.2, R67.2, U7.10, U8.1
TS4: R81.2, R84.2, U9.10, U10.1
TS5: R98.2, R101.2, U11.10, U12.1
TS6: R115.2, R118.2, U13.10, U14.1
TS7: R132.2, R135.2, U15.10, U16.1
TS8: R149.2, R152.2, U17.10, U18.1
TS9: R166.2, R169.2, U19.10, U20.1
TS10: R183.2, R186.2, U21.10, U22.1
TS11: R200.2, R203.2, U23.10, U24.1
TS12: R217.2, R220.2, U25.10, U26.1
TS13: R234.2, R237.2, U27.10, U28.1
TS14: R251.2, R254.2, U29.10, U30.1
TS15: R268.2, R271.2, U31.10, U32.1
TS16: R285.2, R288.2, U33.10, U34.1
TS17: R302.2, R305.2, U35.10, U36.1
TS18: R319.2, R322.2, U37.10, U38.1
TS19: R336.2, R339.2, U39.10, U40.1
TS20: R353.2, R356.2, U41.10, U42.1
TS21: R370.2, R373.2, U43.10, U44.1
TS22: R387.2, R390.2, U45.10, U46.1
TS23: R404.2, R407.2, U47.10, U48.1
TS24: R421.2, R424.2, U49.10, U50.1
TS25: R438.2, R441.2, U51.10, U52.1
TS26: R455.2, R458.2, U53.10, U54.1
TS27: R472.2, R475.2, U55.10, U56.1
V_BATT: C2.1, R11.1, R12.1, U1.2, U1.3, U2.7
V_BATT1: C10.1, R18.1, R32.1, U3.7, U4.2, U4.3
V_BATT2: C15.1, R35.1, R49.1, U5.7, U6.2, U6.3
V_BATT3: C20.1, R52.1, R66.1, U7.7, U8.2, U8.3
V_BATT4: C25.1, R69.1, R83.1, U9.7, U10.2, U10.3
V_BATT5: C30.1, R86.1, R100.1, U11.7, U12.2, U12.3
V_BATT6: C35.1, R103.1, R117.1, U13.7, U14.2, U14.3
V_BATT7: C40.1, R120.1, R134.1, U15.7, U16.2, U16.3
V_BATT8: C45.1, R137.1, R151.1, U17.7, U18.2, U18.3
V_BATT9: C50.1, R154.1, R168.1, U19.7, U20.2, U20.3
V_BATT10: C55.1, R171.1, R185.1, U21.7, U22.2, U22.3
V_BATT11: C60.1, R188.1, R202.1, U23.7, U24.2, U24.3
V_BATT12: C65.1, R205.1, R219.1, U25.7, U26.2, U26.3
V_BATT13: C70.1, R222.1, R236.1, U27.7, U28.2, U28.3
V_BATT14: C75.1, R239.1, R253.1, U29.7, U30.2, U30.3
V_BATT15: C80.1, R256.1, R270.1, U31.7, U32.2, U32.3
V_BATT16: C85.1, R273.1, R287.1, U33.7, U34.2, U34.3
V_BATT17: C90.1, R290.1, R304.1, U35.7, U36.2, U36.3
V_BATT18: C95.1, R307.1, R321.1, U37.7, U38.2, U38.3
V_BATT19: C100.1, R324.1, R338.1, U39.7, U40.2, U40.3
V_BATT20: C105.1, R341.1, R355.1, U41.7, U42.2, U42.3
V_BATT21: C110.1, R358.1, R372.1, U43.7, U44.2, U44.3
V_BATT22: C115.1, R375.1, R389.1, U45.7, U46.2, U46.3
V_BATT23: C120.1, R392.1, R406.1, U47.7, U48.2, U48.3
V_BATT24: C125.1, R409.1, R423.1, U49.7, U50.2, U50.3
V_BATT25: C130.1, R426.1, R440.1, U51.7, U52.2, U52.3
V_BATT26: C135.1, R443.1, R457.1, U53.7, U54.2, U54.3
V_BATT27: C140.1, R460.1, R474.1, U55.7, U56.2, U56.3
V_PU: JP10.2, R13.2, R14.2, R15.2
V_PU1: JP16.2, R19.2, R20.2, R34.2
V_PU2: JP29.2, R36.2, R37.2, R51.2
V_PU3: JP42.2, R53.2, R54.2, R68.2
V_PU4: JP55.2, R70.2, R71.2, R85.2
V_PU5: JP68.2, R87.2, R88.2, R102.2
V_PU6: JP81.2, R104.2, R105.2, R119.2
V_PU7: JP94.2, R121.2, R122.2, R136.2
V_PU8: JP107.2, R138.2, R139.2, R153.2
V_PU9: JP120.2, R155.2, R156.2, R170.2
V_PU10: JP133.2, R172.2, R173.2, R187.2
V_PU11: JP146.2, R189.2, R190.2, R204.2
V_PU12: JP159.2, R206.2, R207.2, R221.2
V_PU13: JP172.2, R223.2, R224.2, R238.2
V_PU14: JP185.2, R240.2, R241.2, R255.2
V_PU15: JP198.2, R257.2, R258.2, R272.2
V_PU16: JP211.2, R274.2, R275.2, R289.2
V_PU17: JP224.2, R291.2, R292.2, R306.2
V_PU18: JP237.2, R308.2, R309.2, R323.2
V_PU19: JP250.2, R325.2, R326.2, R340.2
V_PU20: JP263.2, R342.2, R343.2, R357.2
V_PU21: JP276.2, R359.2, R360.2, R374.2
V_PU22: JP289.2, R376.2, R377.2, R391.2
V_PU23: JP302.2, R393.2, R394.2, R408.2
V_PU24: JP315.2, R410.2, R411.2, R425.2
V_PU25: JP328.2, R427.2, R428.2, R442.2
V_PU26: JP341.2, R444.2, R445.2, R459.2
V_PU27: JP354.2, R461.2, R462.2, R476.2
V_USB: C1.1, JP1.VBUS1, JP2.1, JP3.1, JP4.1, U1.13
V_USB1: C9.1, JP14.VBUS1, JP19.1, JP23.1, JP26.1, U4.13
V_USB2: C14.1, JP27.VBUS1, JP32.1, JP36.1, JP39.1, U6.13
V_USB3: C19.1, JP40.VBUS1, JP45.1, JP49.1, JP52.1, U8.13
V_USB4: C24.1, JP53.VBUS1, JP58.1, JP62.1, JP65.1, U10.13
V_USB5: C29.1, JP66.VBUS1, JP71.1, JP75.1, JP78.1, U12.13
V_USB6: C34.1, JP79.VBUS1, JP84.1, JP88.1, JP91.1, U14.13
V_USB7: C39.1, JP92.VBUS1, JP97.1, JP101.1, JP104.1, U16.13
V_USB8: C44.1, JP105.VBUS1, JP110.1, JP114.1, JP117.1, U18.13
V_USB9: C49.1, JP118.VBUS1, JP123.1, JP127.1, JP130.1, U20.13
V_USB10: C54.1, JP131.VBUS1, JP136.1, JP140.1, JP143.1, U22.13
V_USB11: C59.1, JP144.VBUS1, JP149.1, JP153.1, JP156.1, U24.13
V_USB12: C64.1, JP157.VBUS1, JP162.1, JP166.1, JP169.1, U26.13
V_USB13: C69.1, JP170.VBUS1, JP175.1, JP179.1, JP182.1, U28.13
V_USB14: C74.1, JP183.VBUS1, JP188.1, JP192.1, JP195.1, U30.13
V_USB15: C79.1, JP196.VBUS1, JP201.1, JP205.1, JP208.1, U32.13
V_USB16: C84.1, JP209.VBUS1, JP214.1, JP218.1, JP221.1, U34.13
V_USB17: C89.1, JP222.VBUS1, JP227.1, JP231.1, JP234.1, U36.13
V_USB18: C94.1, JP235.VBUS1, JP240.1, JP244.1, JP247.1, U38.13
V_USB19: C99.1, JP248.VBUS1, JP253.1, JP257.1, JP260.1, U40.13
V_USB20: C104.1, JP261.VBUS1, JP266.1, JP270.1, JP273.1, U42.13
V_USB21: C109.1, JP274.VBUS1, JP279.1, JP283.1, JP286.1, U44.13
V_USB22: C114.1, JP287.VBUS1, JP292.1, JP296.1, JP299.1, U46.13
V_USB23: C119.1, JP300.VBUS1, JP305.1, JP309.1, JP312.1, U48.13
V_USB24: C124.1, JP313.VBUS1, JP318.1, JP322.1, JP325.1, U50.13
V_USB25: C129.1, JP326.VBUS1, JP331.1, JP335.1, JP338.1, U52.13
V_USB26: C134.1, JP339.VBUS1, JP344.1, JP348.1, JP351.1, U54.13
V_USB27: C139.1, JP352.VBUS1, JP357.1, JP361.1, JP364.1, U56.13
