Caveatron/caveatron_old_rev-A_version/caveatron_libraries/Sweep/Sweep.cpp

/*
	This library has been modified for use with the Caveatron
	Adds checksum check for each getReading and if fails, returns false with bIsSync set to true
	Rev 2017-10-18 - Joe Mitchell
*/

#include "Sweep.h"

Sweep::Sweep(Stream &serial) : _serial(serial), bIsScanning(false) {}

Sweep::~Sweep()
{
    _serial.flush();
}

bool Sweep::isScanning()
{
    return bIsScanning;
}

bool Sweep::startScanning()
{
    if (bIsScanning)
        return false;

    // wait until the device is ready (calibration complete + motor stabilized)
    if (!waitUntilMotorReady())
        return false;

    _writeCommand(_DATA_ACQUISITION_START);
    // wait for the receipt (possible timeout)
    if (_readResponseHeader())
    {
        // TODO: validate receipt
        bIsScanning = true;
        return true;
    }
    return false;
}

bool Sweep::stopScanning()
{
    _writeCommand(_DATA_ACQUISITION_STOP);

    // wait for the device to stop sending packets
    delay(500);

    // then flush the buffer and send STOP again to check for a receipt
    _flushInputBuffer();
    _writeCommand(_DATA_ACQUISITION_STOP);

    // wait for the receipt (possible timeout)
    if (_readResponseHeader())
    {
        // TODO: validate receipt
        bIsScanning = false;
        return true;
    }
    return false;
}

ScanPacket Sweep::getReading(bool &success)
{
    success = false;
    if (!bIsScanning)
    {
        return ScanPacket(false, 0, 0, 0);
    }

	// wait for the receipt (possible timeout)
    if (_readResponseScanPacket())
    {
        // TODO: validate receipt
        uint8_t i = 0;

        bool bIsSync = _responseScanPacket[i++] & _SYNC_MASK;

        // read raw fixed point azimuth value
        uint16_t rawAngle_lsb = _responseScanPacket[i++];
        uint16_t rawAngle_msb = _responseScanPacket[i++] << 8;
        uint16_t rawAngle = rawAngle_lsb + rawAngle_msb;

        // read distance value
        uint16_t distance_lsb = _responseScanPacket[i++];
        uint16_t distance_msb = _responseScanPacket[i++] << 8;
        uint16_t distance = distance_lsb + distance_msb;

        // read signal strength value
        uint8_t signalStrength = _responseScanPacket[i++];

		// *** Start Modifications for Caveatron ***
		// evaluate checksum of data block
		int calculatedSum = 0;
		for (int i = 0; i < 6; i++) {
			//add each status byte to the running sum
			calculatedSum += _responseScanPacket[i];
		}
		calculatedSum = calculatedSum % 255;
		// compare to received checksum byte
		if (calculatedSum==_responseScanPacket[6]) {
			success = true;
			return ScanPacket(bIsSync, rawAngle, distance, signalStrength);
		} else return ScanPacket(true, 0, 0, 0);	//if checksum fails, return false, set bIsSync to true and other values to 0
		// *** End Modifications for Caveatron ***
    }
	
    return ScanPacket(false, 0, 0, 0);
}

bool Sweep::getMotorReady()
{
    if (bIsScanning)
        return false;
    _writeCommand(_MOTOR_READY);
    if (_readResponseInfoSetting())
    {
        // TODO: validate receipt (hold off until performance hit is determined)
        const uint8_t readyCode[2] = {_responseInfoSetting[2], _responseInfoSetting[3]};
        // readyCode == 0 indicates device is ready
        return _ascii_bytes_to_integer(readyCode) == 0;
    }
    return false;
}

bool Sweep::waitUntilMotorReady()
{
    if (bIsScanning)
        return false;
    // only check for 10 seconds (20 iterations with 500ms pause)
    for (uint8_t i = 0; i < 20; ++i)
    {
        if (getMotorReady())
            return true;
        delay(500);
    }
    // timeout after 10 seconds
    return false;
}

int32_t Sweep::getMotorSpeed()
{
    if (bIsScanning)
        return false;

    _writeCommand(_MOTOR_INFORMATION);
    if (_readResponseInfoSetting())
    {
        // TODO: validate receipt (hold off until performance hit is determined)
        const uint8_t speedCode[2] = {_responseInfoSetting[2], _responseInfoSetting[3]};
        return _ascii_bytes_to_integer(speedCode);
    }
    return -1;
}

bool Sweep::setMotorSpeed(const uint8_t motorSpeedCode[2])
{
    if (bIsScanning)
        return false;

    // wait until the device is ready (calibration complete + motor stabilized)
    if (!waitUntilMotorReady())
        return false;

    _writeCommandWithArgument(_MOTOR_SPEED_ADJUST, motorSpeedCode);
    // wait for the receipt (possible timeout)
    if (_readResponseParam())
    {
        // TODO: validate receipt
        return true;
    }
    return false;
}

int32_t Sweep::getSampleRate()
{
    if (bIsScanning)
        return false;

    _writeCommand(_SAMPLE_RATE_INFORMATION);
    if (_readResponseInfoSetting())
    {
        // TODO: validate receipt (hold off until performance hit is determined)
        const uint8_t sampleRateCode[2] = {_responseInfoSetting[2], _responseInfoSetting[3]};
        switch (_ascii_bytes_to_integer(sampleRateCode))
        {
        case 1:
            return 500;
        case 2:
            return 750;
        case 3:
            return 1000;
        default:
            break;
        }
    }
    return -1;
}

bool Sweep::setSampleRate(const uint8_t sampleRateCode[2])
{
    if (bIsScanning)
        return false;

    _writeCommandWithArgument(_SAMPLE_RATE_ADJUST, sampleRateCode);
    // wait for the receipt (possible timeout)
    if (_readResponseParam())
    {
        // TODO: validate receipt
        return true;
    }
    return false;
}

void Sweep::reset()
{
    _writeCommand(_RESET_DEVICE);
}

void Sweep::_writeCommand(const uint8_t cmd[2])
{
    const uint8_t command[3] = {cmd[0], cmd[1], _COMMAND_TERMINATION};

    _serial.write(command, 3);
}

void Sweep::_writeCommandWithArgument(const uint8_t cmd[2], const uint8_t arg[2])
{
    const uint8_t command[5] = {cmd[0], cmd[1], arg[0], arg[1], _COMMAND_TERMINATION};

    _serial.write(command, 5);
}

bool Sweep::_readResponseHeader()
{
    // determine the expected number of bytes to read
    uint8_t len = sweepArrLen(_responseHeader);

    // set a timeout on the read
    _serial.setTimeout(1000);

    // attempt to read (can timeout)
    int numBytesRead = _serial.readBytes(_responseHeader, len);

    // return true if the expected num of bytes were read
    return numBytesRead == len;
}

bool Sweep::_readResponseParam()
{
    // determine the expected number of bytes to read
    uint8_t len = sweepArrLen(_responseParam);

    // set a timeout on the read
    _serial.setTimeout(1000);

    // attempt to read (can timeout)
    int numBytesRead = _serial.readBytes(_responseParam, len);

    // return true if the expected num of bytes were read
    return numBytesRead == len;
}

bool Sweep::_readResponseScanPacket()
{
    // determine the expected number of bytes to read
    uint8_t len = sweepArrLen(_responseScanPacket);

    // set a timeout on the read
    _serial.setTimeout(1000);

    // attempt to read (can timeout)
    int numBytesRead = _serial.readBytes(_responseScanPacket, len);

    // return true if the expected num of bytes were read
    return numBytesRead == len;
}

bool Sweep::_readResponseInfoDevice()
{
    // determine the expected number of bytes to read
    uint8_t len = sweepArrLen(_responseInfoDevice);

    // set a timeout on the read
    _serial.setTimeout(1000);

    // attempt to read (can timeout)
    int numBytesRead = _serial.readBytes(_responseInfoDevice, len);

    // return true if the expected num of bytes were read
    return numBytesRead == len;
}

bool Sweep::_readResponseInfoVersion()
{
    // determine the expected number of bytes to read
    uint8_t len = sweepArrLen(_responseInfoVersion);

    // set a timeout on the read
    _serial.setTimeout(1000);

    // attempt to read (can timeout)
    int numBytesRead = _serial.readBytes(_responseInfoVersion, len);

    // return true if the expected num of bytes were read
    return numBytesRead == len;
}

bool Sweep::_readResponseInfoSetting()
{
    // determine the expected number of bytes to read
    uint8_t len = sweepArrLen(_responseInfoSetting);

    // set a timeout on the read
    _serial.setTimeout(1000);

    // attempt to read (can timeout)
    int numBytesRead = _serial.readBytes(_responseInfoSetting, len);

    // return true if the expected num of bytes were read
    return numBytesRead == len;
}

void Sweep::_flushInputBuffer()
{
    while (_serial.available() > 0)
    {
        _serial.read();
    }
}
