Caveatron/caveatron_old_rev-A_version/caveatron_libraries/URTouch/URTouch.cpp

/*
  URTouch.cpp - Arduino/chipKit library support for Color TFT LCD Touch screens 
  Copyright (C)2016 Rinky-Dink Electronics, Henning Karlsen. All right reserved
  
  Basic functionality of this library are based on the demo-code provided by
  ITead studio.

  You can find the latest version of the library at 
  http://www.RinkyDinkElectronics.com/

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
  Commercial use of this library requires you to buy a license that
  will allow commercial use. This includes using the library,
  modified or not, as a tool to sell products.

  The license applies to all part of the library including the 
  examples and tools supplied with the library.
*/

/*
	This library has been modified for use with the Caveatron
	Added initialization function to directly pass screen calibration parameters
	Added delays when using with Teensy 3.5/3.6 to slow touch read clocking
	Rev 2019-02-07 - Joe Mitchell
*/

#include "URTouch.h"
#include "URTouchCD.h"

#if defined(__AVR__)
	#include "hardware/avr/HW_AVR.inc"
#elif defined(__PIC32MX__)
	#include "hardware/pic32/HW_PIC32.inc"
#elif defined(__arm__)
	#include "hardware/arm/HW_ARM.inc"
#endif

URTouch::URTouch(byte tclk, byte tcs, byte din, byte dout, byte irq)
{
	T_CLK	= tclk;
	T_CS	= tcs;
	T_DIN	= din;
	T_DOUT	= dout;
	T_IRQ	= irq;
}

void URTouch::InitTouch(byte orientation)
{
	orient					= orientation;
	_default_orientation	= CAL_S>>31;
	touch_x_left			= (CAL_X>>14) & 0x3FFF;
	touch_x_right			= CAL_X & 0x3FFF;
	touch_y_top				= (CAL_Y>>14) & 0x3FFF;
	touch_y_bottom			= CAL_Y & 0x3FFF;
	disp_x_size				= (CAL_S>>12) & 0x0FFF;
	disp_y_size				= CAL_S & 0x0FFF;
	prec					= 10;

	P_CLK	= portOutputRegister(digitalPinToPort(T_CLK));
	B_CLK	= digitalPinToBitMask(T_CLK);
	P_CS	= portOutputRegister(digitalPinToPort(T_CS));
	B_CS	= digitalPinToBitMask(T_CS);
	P_DIN	= portOutputRegister(digitalPinToPort(T_DIN));
	B_DIN	= digitalPinToBitMask(T_DIN);
	P_DOUT	= portInputRegister(digitalPinToPort(T_DOUT));
	B_DOUT	= digitalPinToBitMask(T_DOUT);
	P_IRQ	= portInputRegister(digitalPinToPort(T_IRQ));
	B_IRQ	= digitalPinToBitMask(T_IRQ);

	pinMode(T_CLK,  OUTPUT);
    pinMode(T_CS,   OUTPUT);
    pinMode(T_DIN,  OUTPUT);
    pinMode(T_DOUT, INPUT);
    pinMode(T_IRQ,  OUTPUT);

	sbi(P_CS, B_CS);
	sbi(P_CLK, B_CLK);
	sbi(P_DIN, B_DIN);
	sbi(P_IRQ, B_IRQ);
}

// *** Start modifications for Caveatron ***
// Initialization with directly passed screen calibration parameters
void URTouch::InitTouch(byte orientation, unsigned long CCAL_X, unsigned long CCAL_Y, unsigned long CCAL_S)
{
	orient					= orientation;
	_default_orientation	= CCAL_S>>31;
	touch_x_left			= (CCAL_X>>14) & 0x3FFF;
	touch_x_right			= CCAL_X & 0x3FFF;
	touch_y_top				= (CCAL_Y>>14) & 0x3FFF;
	touch_y_bottom			= CCAL_Y & 0x3FFF;
	disp_x_size				= (CCAL_S>>12) & 0x0FFF;
	disp_y_size				= CCAL_S & 0x0FFF;
	prec					= 10;

	P_CLK	= portOutputRegister(digitalPinToPort(T_CLK));
	B_CLK	= digitalPinToBitMask(T_CLK);
	P_CS	= portOutputRegister(digitalPinToPort(T_CS));
	B_CS	= digitalPinToBitMask(T_CS);
	P_DIN	= portOutputRegister(digitalPinToPort(T_DIN));
	B_DIN	= digitalPinToBitMask(T_DIN);
	P_DOUT	= portInputRegister(digitalPinToPort(T_DOUT));
	B_DOUT	= digitalPinToBitMask(T_DOUT);
	P_IRQ	= portInputRegister(digitalPinToPort(T_IRQ));
	B_IRQ	= digitalPinToBitMask(T_IRQ);

	pinMode(T_CLK,  OUTPUT);
    pinMode(T_CS,   OUTPUT);
    pinMode(T_DIN,  OUTPUT);
    pinMode(T_DOUT, INPUT);
    pinMode(T_IRQ,  OUTPUT);

	sbi(P_CS, B_CS);
	sbi(P_CLK, B_CLK);
	sbi(P_DIN, B_DIN);
	sbi(P_IRQ, B_IRQ);
}
// *** End modifications for Caveatron ***

void URTouch::read()
{
	unsigned long tx=0, temp_x=0;
	unsigned long ty=0, temp_y=0;
	unsigned long minx=99999, maxx=0;
	unsigned long miny=99999, maxy=0;
	int datacount=0;

	cbi(P_CS, B_CS);                    

	pinMode(T_IRQ,  INPUT);
	for (int i=0; i<prec; i++)
	{
		if (!rbi(P_IRQ, B_IRQ))
		{
			touch_WriteData(0x90);   
			#if defined (__MK64FX512__) || defined(__MK66FX1M0__)	//Modified for Caveatron to slow clock for Teensy
				delayMicroseconds(1);	
			#endif
			pulse_high(P_CLK, B_CLK);
			#if defined (__MK64FX512__) || defined(__MK66FX1M0__)	//Modified for Caveatron to slow clock for Teensy
				delayMicroseconds(1);	
			#endif
			temp_x=touch_ReadData();
			#if defined (__MK64FX512__) || defined(__MK66FX1M0__)	//Modified for Caveatron to slow clock for Teensy
				delayMicroseconds(1);	
			#endif
			if (!rbi(P_IRQ, B_IRQ))
			{
				touch_WriteData(0xD0); 
				#if defined (__MK64FX512__) || defined(__MK66FX1M0__)	//Modified for Caveatron to slow clock for Teensy
					delayMicroseconds(1);	
				#endif			
				pulse_high(P_CLK, B_CLK);
				#if defined (__MK64FX512__) || defined(__MK66FX1M0__)	//Modified for Caveatron to slow clock for Teensy
					delayMicroseconds(1);	
				#endif
				temp_y=touch_ReadData();
				#if defined (__MK64FX512__) || defined(__MK66FX1M0__)	//Modified for Caveatron to slow clock for Teensy
					delayMicroseconds(1);	
				#endif
				if ((temp_x>0) and (temp_x<4096) and (temp_y>0) and (temp_y<4096))
				{
					tx+=temp_x;
					ty+=temp_y;
					if (prec>5)
					{
						if (temp_x<minx)
							minx=temp_x;
						if (temp_x>maxx)
							maxx=temp_x;
						if (temp_y<miny)
							miny=temp_y;
						if (temp_y>maxy)
							maxy=temp_y;
					}
					datacount++;
				}
			}
		}
	}
	pinMode(T_IRQ,  OUTPUT);

	if (prec>5)
	{
		tx = tx-(minx+maxx);
		ty = ty-(miny+maxy);
		datacount -= 2;
	}

	sbi(P_CS, B_CS);                    
	if ((datacount==(prec-2)) or (datacount==PREC_LOW))
	{
		if (orient == _default_orientation)
		{
			TP_X=ty/datacount;
			TP_Y=tx/datacount;
		}
		else
		{
			TP_X=tx/datacount;
			TP_Y=ty/datacount;
		}
	}
	else
	{
		TP_X=-1;
		TP_Y=-1;
	}
}

bool URTouch::dataAvailable()
{
	bool avail;
	pinMode(T_IRQ,  INPUT);
	avail = !(rbi(P_IRQ, B_IRQ));
	pinMode(T_IRQ,  OUTPUT);
	return avail;
}

int16_t URTouch::getX()
{
	long c;

	if ((TP_X==-1) or (TP_Y==-1))
		return -1;
	if (orient == _default_orientation)
	{
		c = long(long(TP_X - touch_x_left) * (disp_x_size)) / long(touch_x_right - touch_x_left);
		if (c<0)
			c = 0;
		if (c>disp_x_size)
			c = disp_x_size;
	}
	else
	{
		if (_default_orientation == PORTRAIT)
			c = long(long(TP_X - touch_y_top) * (-disp_y_size)) / long(touch_y_bottom - touch_y_top) + long(disp_y_size);
		else
			c = long(long(TP_X - touch_y_top) * (disp_y_size)) / long(touch_y_bottom - touch_y_top);
		if (c<0)
			c = 0;
		if (c>disp_y_size)
			c = disp_y_size;
	}
	return c;
}

int16_t URTouch::getY()
{
	int c;

	if ((TP_X==-1) or (TP_Y==-1))
		return -1;
	if (orient == _default_orientation)
	{
		c = long(long(TP_Y - touch_y_top) * (disp_y_size)) / long(touch_y_bottom - touch_y_top);
		if (c<0)
			c = 0;
		if (c>disp_y_size)
			c = disp_y_size;
	}
	else
	{
		if (_default_orientation == PORTRAIT)
			c = long(long(TP_Y - touch_x_left) * (disp_x_size)) / long(touch_x_right - touch_x_left);
		else
			c = long(long(TP_Y - touch_x_left) * (-disp_x_size)) / long(touch_x_right - touch_x_left) + long(disp_x_size);
		if (c<0)
			c = 0;
		if (c>disp_x_size)
			c = disp_x_size;
	}
	return c;
}

void URTouch::setPrecision(byte precision)
{
	switch (precision)
	{
		case PREC_LOW:
			prec=1;		// DO NOT CHANGE!
			break;
		case PREC_MEDIUM:
			prec=12;	// Iterations + 2
			break;
		case PREC_HI:
			prec=27;	// Iterations + 2
			break;
		case PREC_EXTREME:
			prec=102;	// Iterations + 2
			break;
		default:
			prec=12;	// Iterations + 2
			break;
	}
}

void URTouch::calibrateRead()
{
	unsigned long tx=0;
	unsigned long ty=0;

	cbi(P_CS, B_CS);                    

	touch_WriteData(0x90);
	#if defined (__MK64FX512__) || defined(__MK66FX1M0__)	//Modified for Caveatron to slow clock for Teensy
		delayMicroseconds(1);	
	#endif
	pulse_high(P_CLK, B_CLK);
	#if defined (__MK64FX512__) || defined(__MK66FX1M0__)	//Modified for Caveatron to slow clock for Teensy
		delayMicroseconds(1);	
	#endif
	tx=touch_ReadData();
	#if defined (__MK64FX512__) || defined(__MK66FX1M0__)	//Modified for Caveatron to slow clock for Teensy
		delayMicroseconds(1);	
	#endif
	touch_WriteData(0xD0); 
	#if defined (__MK64FX512__) || defined(__MK66FX1M0__)	//Modified for Caveatron to slow clock for Teensy
		delayMicroseconds(1);	
	#endif
	pulse_high(P_CLK, B_CLK);
	#if defined (__MK64FX512__) || defined(__MK66FX1M0__)	//Modified for Caveatron to slow clock for Teensy
		delayMicroseconds(1);	
	#endif
	ty=touch_ReadData();
	#if defined (__MK64FX512__) || defined(__MK66FX1M0__)	//Modified for Caveatron to slow clock for Teensy
		delayMicroseconds(1);	
	#endif
	sbi(P_CS, B_CS);                    

	TP_X=ty;
	TP_Y=tx;
}
